Open-BeatBox/Open-BeatBox_Hardware/electronics/pictures/BB_feeder_IRbarrier.PNG

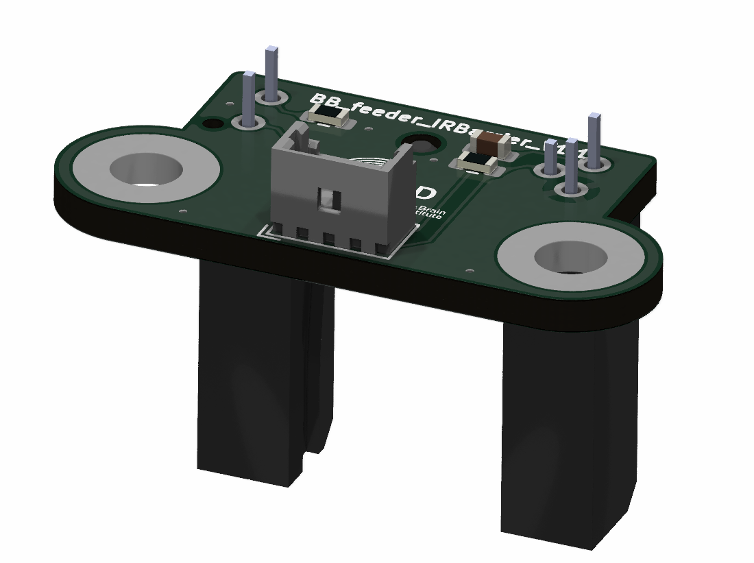
electronics/pictures/BB_feeder_IRbarrier.PNG
