Open-BeatBox/Open-BeatBox_Hardware/electronics/pictures/BB_Feeder_main.PNG

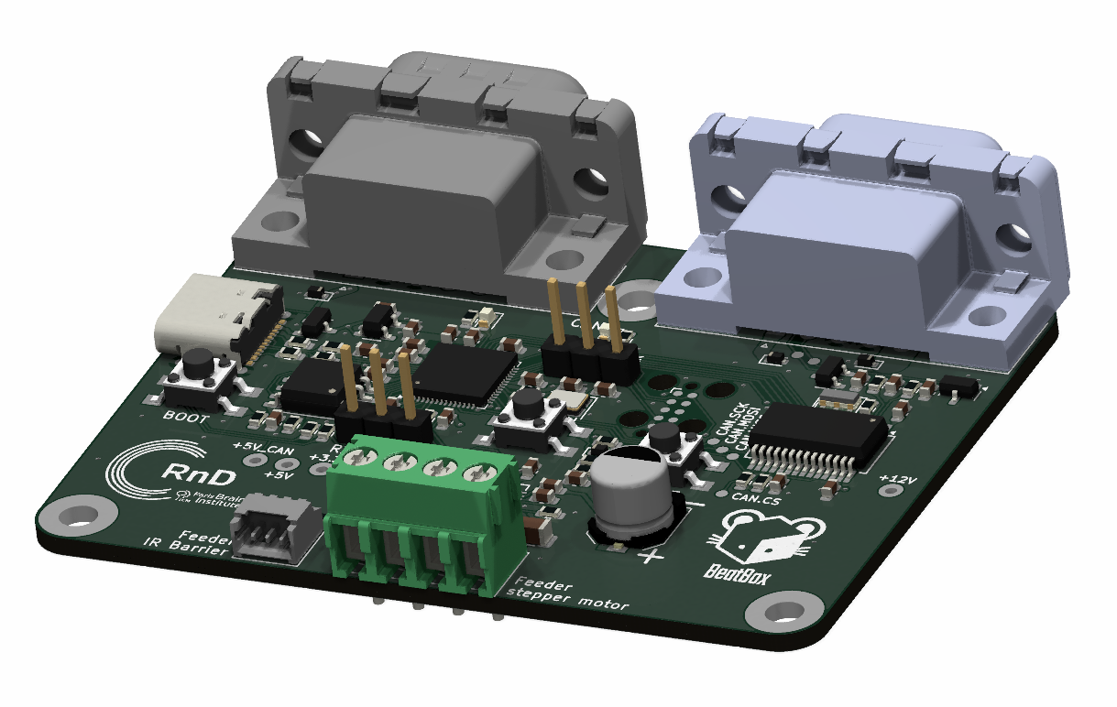
electronics/pictures/BB_Feeder_main.PNG
