Open-BeatBox/Open-BeatBox_Hardware/electronics/pictures/BB_Lighting.PNG

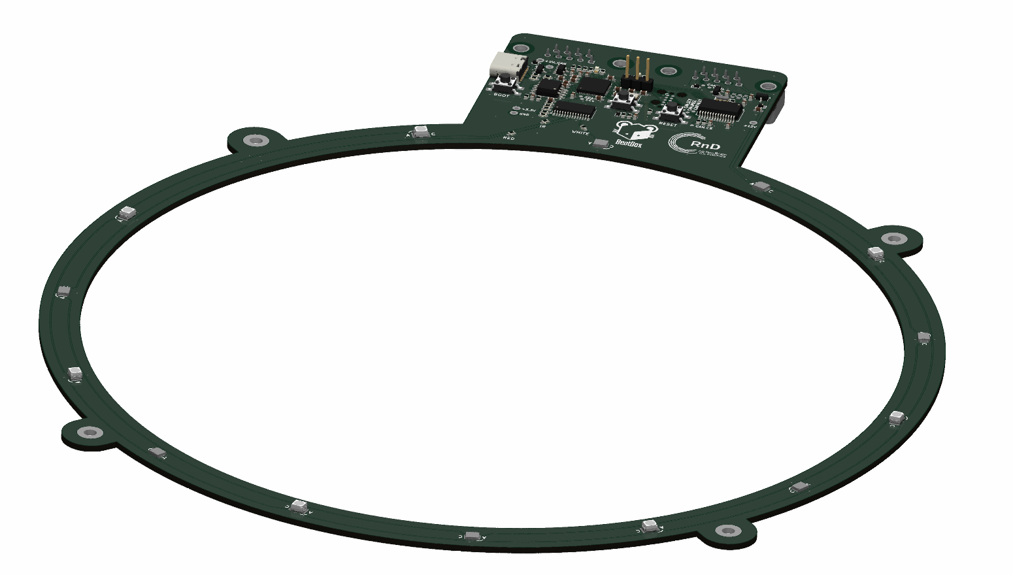
electronics/pictures/BB_Lighting.PNG
