Open-BeatBox/Open-BeatBox_Hardware/electronics/pictures/BB_Nosepoke.PNG

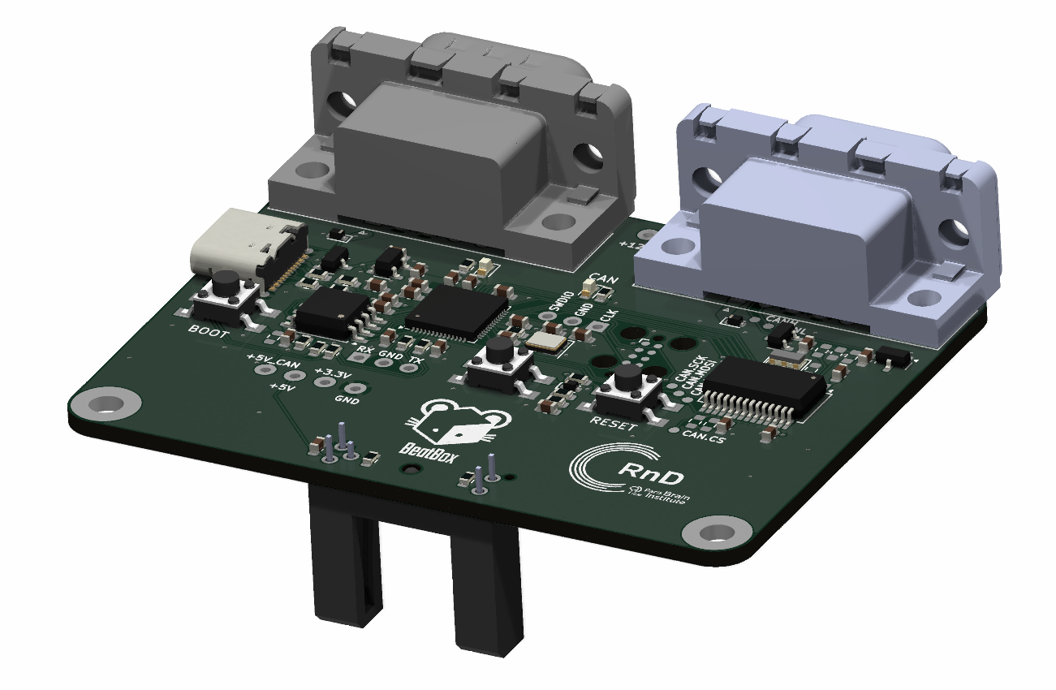
electronics/pictures/BB_Nosepoke.PNG
