Open-BeatBox/Open-BeatBox_Hardware/electronics/pictures/BB_RPI_shield.PNG

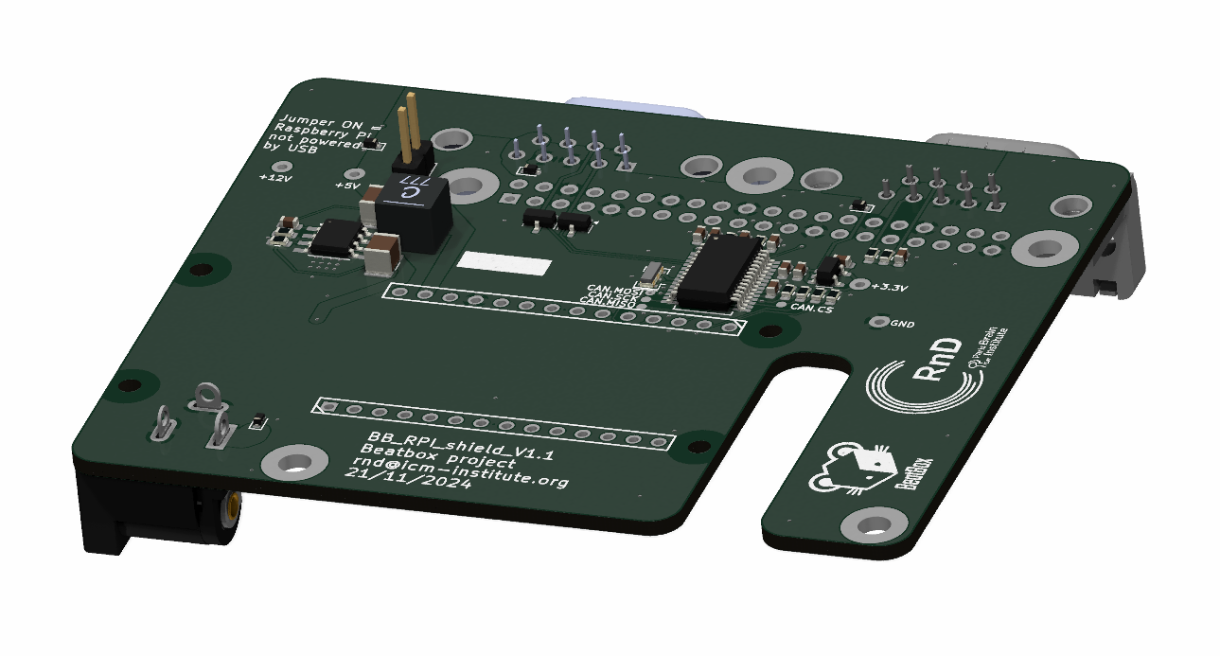
electronics/pictures/BB_RPI_shield.PNG
