Open-BeatBox/Open-BeatBox_Hardware/electronics/pictures/BB_Screen_Main.PNG

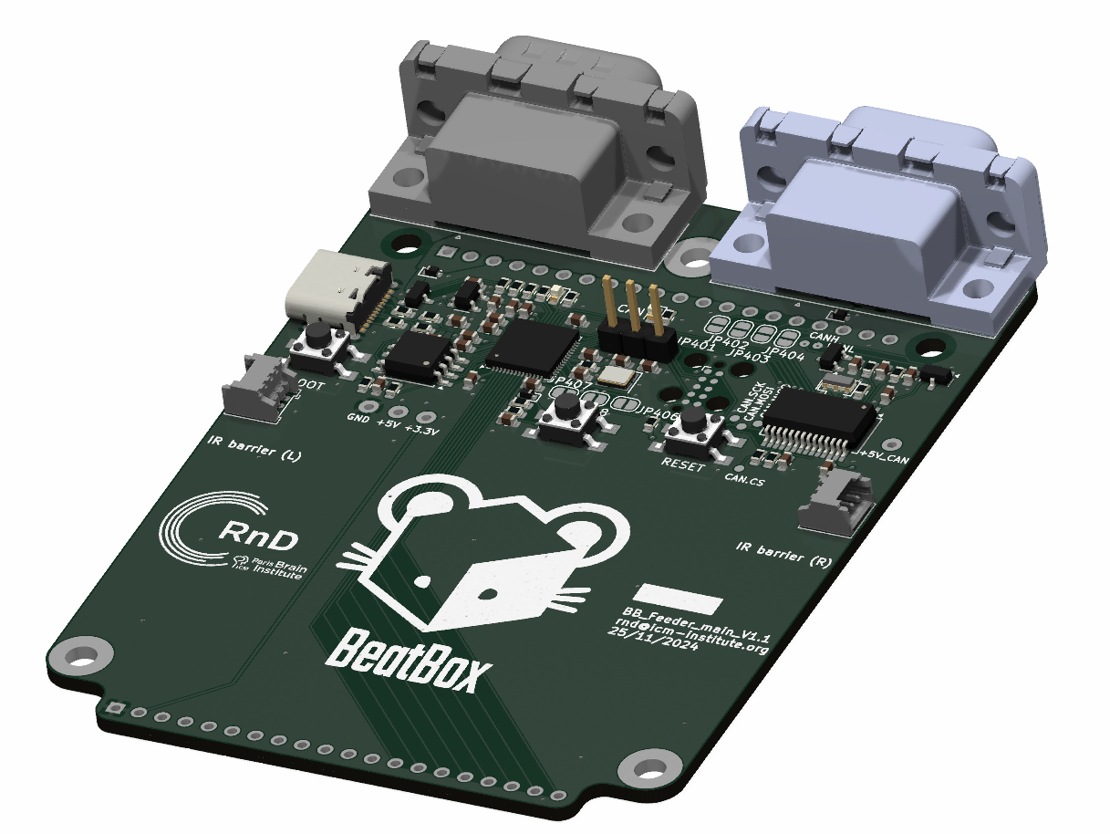
electronics/pictures/BB_Screen_Main.PNG
