Open-BeatBox/Open-BeatBox_Hardware/electronics/pictures/BB_Tunnel.PNG

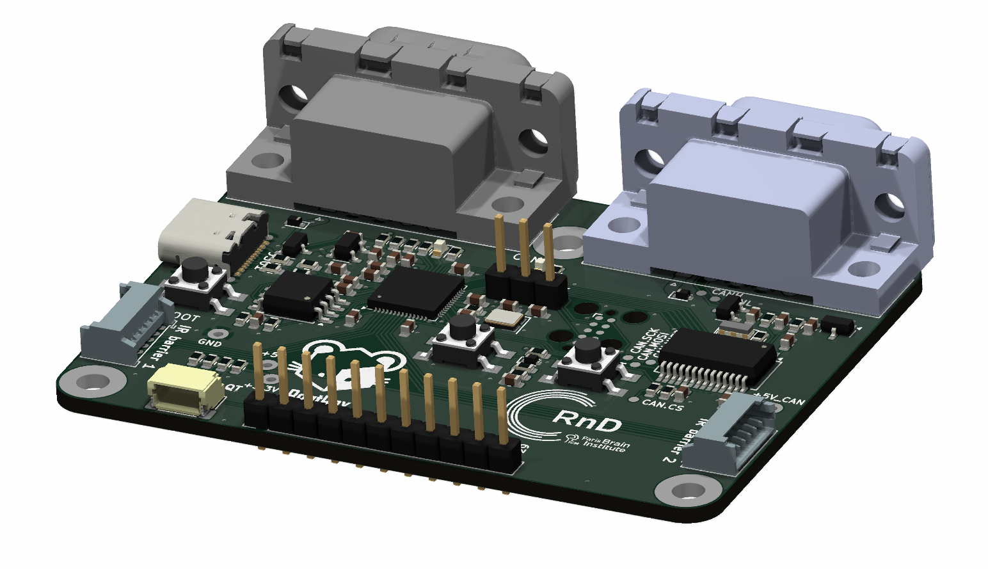
electronics/pictures/BB_Tunnel.PNG
