Open-BeatBox/Open-BeatBox_Hardware/electronics/pictures/BB_Tunnel_IR_Light_curtain.PNG

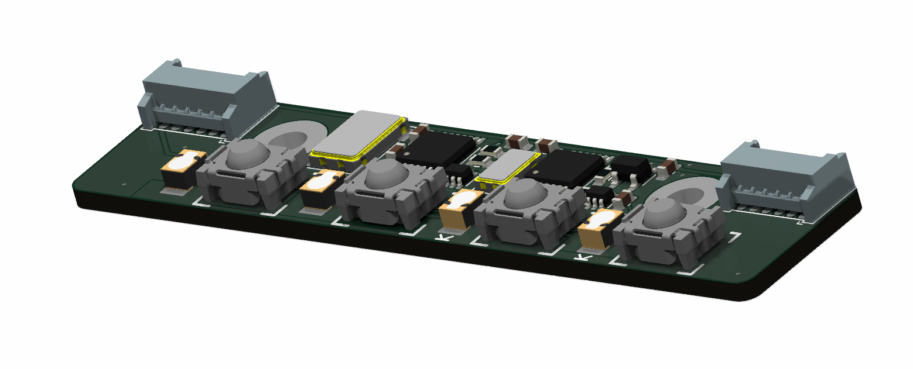
electronics/pictures/BB_Tunnel_IR_Light_curtain.PNG
