Open-BeatBox/Open-BeatBox_Hardware/electronics/BB_feeder_IRBarrier_V1/production/bom.csv

Designator | Footprint | Quantity | Value | LCSC Part #
C101 | 0603 | 1 | 100nF
J101 | Conn_Molex_PicoBlade_53048-0310_1x03_P1.25mm_Horizontal | 1 | Conn_Picoblade_Molex_53047-0310 | 53048-0310
R101 | 0603 | 1 | 300R
R102 | 0603 | 1 | 30k
U101 | SHARP-GP1A57HRJ00F | 1 | GP1A57HRJ00F | GP1A57HRJ00F
