Open-BeatBox/Open-BeatBox_Hardware/electronics/BB_feeder_main_V1/production/bom.csv

Designator | Footprint | Quantity | Value | LCSC Part #
C201, C202, C205, C206, C207, C208, C209, C210, C211, C212, C213, C214, C215, C216, C217, C303, C304, C305, C502, C503, C506, C507 | 0603 | 22 | 100nF
C203, C204 | 0603 | 2 | 1µF
C218, C219 | 0603 | 2 | 15pF
C302, C307 | 0603 | 2 | 47pF
C401, C402, C403, C404 | 0603 | 4 | 1uF
C501, C508 | 0603 | 2 | 220nF
C504 | 1206 | 1 | 4.7µF 16V
C505 | EEE-FN1V680UP | 1 | EEE-FN1V680UP | EEE-FN1V680UP
D201 | D_SOD-523 | 1 | TVS_ESD5Z3.3T5G | ESD5Z3.3T5G
D202, D301, D302 | D_SOD-523 | 3 | TVS_ESD5Z5.0T1G | ESD5Z5.0T1G
D203 | 0603 | 1 | LED_150060GS75000 | 150060GS75000
D204 | 0603 | 1 | LED_150060YS75000 | 150060YS75000
D303 | D_SOD-523 | 1 | TVS_ESD5Z12T1G | ESD5Z12T1G
D304, D305 | SOT-23 | 2 | MMBZ27VCLT1G | MMBZ27VCLT1G
J202 | KH-BNC50-3511 | 1 | Conn_BNC_KH-BNC50-3511 | KH-BNC50-3511
J301 | Conn_DB9_D09P33E4PA00LF | 1 | Conn-DB9_D09P33E4PA00LF | D09P33E4PA00LF
J302 | Conn_DB9_D09S33E4PA00LF | 1 | Conn-DB9_D09S33E4PA00LF | D09S33E4PA00LF
J401 | Conn_USB_C_Receptacle_GCT_USB4105-xx-A_16P_TopMnt_Horizontal | 1 | Conn_USB-C_USB4105-GF-A | USB4105-GF-A
J501 | TerminalBlock_Phoenix_PT-1,5-4-3.5-H_1x04_P3.50mm_Horizontal | 1 | Conn_Screw_Terminal_04_P3.5 | 20020327-C041B01LF
J502 | Conn_Molex_PicoBlade_53048-0310_1x03_P1.25mm_Horizontal | 1 | Conn_Picoblade_Molex_53048-0310 | 53048-0310
R201, R209, R403, R406, R503, R504 | 0603 | 6 | 100k
R202, R203, R205, R306, R307, R308, R309, R501, R508 | 0603 | 9 | 10k
R204, R206 | 0603 | 2 | 1k
R207, R208 | 0603 | 2 | 470R
R210 | 0603 | 1 | 33k
R401, R402 | 0603 | 2 | 5.1k
R404, R405 | 0603 | 2 | 27R
R502 | 0603 | 1 | 1.05k
R505 | 0603 | 1 | 5k
R506, R507 | 0603 | 2 | 68mR
R509 | 0603 | 1 | 30k
SW201, SW202, SW203 | SW_Push_TL3305 | 3 | SW_TL3305AF160QG | TL3305AF160QG
U201 | SOIC-8_W25Q128JV | 1 | W25Q128JVS
U202 | SOT-363_SC-70-6 | 1 | 74LVC1T45 | 74LVC1T45DW-7
U203 | QFN-56-1EP_7x7mm_P0.4mm_EP3.2x3.2mm | 1 | RP2040 | RP2040
U301 | SSOP-28_5.3x10.2mm_P0.65mm | 1 | MCP25625-E/SS | MCP25625-E/SS
U401, U403 | SOT-363_SC-70-6 | 2 | LM66100DCK | LM66100DCKR
U402 | SOT-23-5 | 1 | MIC5504-3.3YM5 | MIC5504-3.3YM5
U501 | QFN-28-1EP_5x5mm_P0.5mm_EP3.1x3.1mm | 1 | A4988 | A4988SETTR-T
Y201 | Crystal_SMD_Abracon_ABM8 | 1 | Crystal_ABM8-272-T3 | ABM8-272-T3
Y301 | Resonator_SMD_Murata_CSTxExxV-3Pin_3.0x1.1mm | 1 | CSTNE16M0VH3L000R0 | CSTNE16M0VH3L000R0
