Open-BeatBox/Open-BeatBox_Hardware/electronics/BB_IR_light_curtain_V2_38k/production/bom.csv

Designator | Footprint | Quantity | Value | LCSC Part #
C1, C2 | 0603 | 2 | 1µF
C101, C102 | 0603 | 2 | 100nF
D1, D2, D3, D4 | 1206 | 4 | DY-IRS3216176-3T-09 | C7470733
J1 | Conn_Molex_PicoBlade_53048-0610_1x06_P1.25mm_Horizontal | 1 | Conn_01x06
J2 | Conn_Molex_PicoBlade_53048-0310_1x03_P1.25mm_Horizontal | 1 | Conn_Picoblade_Molex_53048-0310 | C505275
R1, R2 | 0603 | 2 | 20k
R3 | 0603 | 1 | 10k
TP1, TP2, TP5 | TestPoint_Pad_D1.0mm | 3 | TestPoint
U1, U3, U5, U8 | SOT-353_SC-70-5 | 4 | 74LVC1G06GW,125 | C426704
U101 | TSSOP-14_4.4x5mm_P0.65mm | 1 | CD74HC4024PWR | C2653003
U2, U4, U7, U9 | Vishay-panhead | 4 | TSSP6038 | C3742816
U6 | SOT-23-5 | 1 | MIC5504-3.3YM5 | C88419
X101 | Crystal_SMD_3225-4Pin_3.2x2.5mm | 1 | SX3M4.9152A10F20TNN | C41361375
