Open-BeatBox/Open-BeatBox_Hardware/electronics/BB_RPI_shield_V1/production/bom.csv

Designator | Footprint | Quantity | Value | LCSC Part #
BT601 | Harwin-S8411-45R | 1 | S8411R-45R | C70381
C201, C202, C205, C206, C207, C208, C209, C210, C211, C212, C213, C214, C215, C216, C217, C303, C304, C305, C412, C601 | 0603 | 20 | 100nF
C203, C204 | 0603 | 2 | 1µF
C218, C219 | 0603 | 2 | 15pF
C301, C306 | 0603 | 2 | 4.7nF
C302, C307, C408, C409 | 0603 | 4 | 47pF
C401, C402, C403, C404 | 0603 | 4 | 1uF
C405 | 1210 | 1 | 22uF
C406 | 1210 | 1 | 10uF 25V
C407 | 0603 | 1 | 1uF 25V
C410, C411 | 0603 | 2 | 2.2uF
C501 | 0603 | 1 | 10µF
D201, D501 | D_SOD-523 | 2 | TVS_ESD5Z3.3T5G | C22440024
D202, D301, D302, D407, D408 | D_SOD-523 | 5 | TVS_ESD5Z5.0T1G | C343989
D203, D402 | 0603 | 2 | LED_150060GS75000 | C5252984
D204 | 0603 | 1 | LED_150060YS75000 | C6784997
D303, D401 | D_SOD-523 | 2 | TVS_ESD5Z12T1G | ESD5Z12T1G
D304, D305 | SOT-23 | 2 | MMBZ27VCLT1G | C128609
D403, D404, D405, D406 | D_SOD-523 | 4 | TVS_ESD321DYAR | C20345394
D502, D503, D504, D505, D506 | D_SOD-323 | 5 | UDD32C03L01 | C78439
J202 | KH-BNC50-3511 | 1 | Conn_BNC_KH-BNC50-3511 | C2837587
J301 | Conn_DB9_D09P33E4PA00LF | 1 | Conn-DB9_D09P33E4PA00LF | C19077344
J302 | Conn_DB9_D09S33E4PA00LF | 1 | Conn-DB9_D09S33E4PA00LF | C141882
J401, J403 | Conn_USB_C_Receptacle_GCT_USB4105-xx-A_16P_TopMnt_Horizontal | 2 | Conn_USB-C_USB4105-GF-A | C393939
J402 | Conn_BarrelJack_Wurth_694106301002 | 1 | Barrel_Jack_Switch | C5441017
J501 | microSD_TF-01A | 1 | TF-01A | C91145
L401 | L_coilcraft_XAL50XX | 1 | Ind_XAL5030-332MEC | C5342047
LG401 | Lightpipe_Dialight_515-1049F | 1 | 515-1049F | 515-1049F
R201, R210 | 0603 | 2 | 100k
R202, R203, R205, R306, R307, R308, R309 | 0603 | 7 | 10k
R204, R206 | 0603 | 2 | 1k
R207, R208, R413 | 0603 | 3 | 470R
R303, R304, R305, R310 | 0603 | 4 | 60.4R
R401, R402, R409, R410 | 0603 | 4 | 5.1k
R404, R405, R411, R412 | 0603 | 4 | 27R
R407 | 0603 | 1 | 115k
R408 | 0603 | 1 | 22k
R501 | 0603 | 1 | 100kR
R502, R503, R504, R601, R602 | 0603 | 5 | 10kR
SW201, SW202, SW203 | SW_Push_TL3305 | 3 | SW_TL3305AF160QG | C18078070
U201 | SOIC-8_W25Q128JV | 1 | W25Q128JVS | C97521
U202 | SOT-363_SC-70-6 | 1 | 74LVC1T45 | C168855
U203 | QFN-56-1EP_7x7mm_P0.4mm_EP3.2x3.2mm | 1 | RP2040 | C2040
U301 | SSOP-28_5.3x10.2mm_P0.65mm | 1 | MCP25625-E/SS | C184944
U401, U403 | SOT-363_SC-70-6 | 2 | LM66100DCK | C2869734
U402 | SOT-23-5 | 1 | MIC5504-3.3YM5 | C88419
U404 | TI_SO-PowerPAD-8 | 1 | ST1S41PHR | C2070789
U405 | WDFN-12-1EP_3x3mm_P0.45mm_EP1.7x2.5mm | 1 | FT234XD
U601 | SOIC-16W_7.5x10.3mm_P1.27mm | 1 | DS3231S | C722469
Y201 | Crystal_SMD_Abracon_ABM8 | 1 | Crystal_ABM8-272-T3 | C20625731
Y301 | Resonator_SMD_Murata_CSTxExxV-3Pin_3.0x1.1mm | 1 | CSTNE16M0VH3L000R0 | C1870467
