Open-BeatBox/Open-BeatBox_Hardware/electronics/BB_screen_main_V1/production/bom.csv

Designator | Footprint | Quantity | Value | LCSC Part #
BOM401, BOM402 | Placeholder | 2 | M20-7822046 | M20-7822046
C201, C305, C306, C307, C308, C309, C310, C311, C312, C313, C314, C315, C318, C502, C503, C504 | 0603 | 16 | 100nF
C301, C302 | 0603 | 2 | 10µF
C303, C304 | 0603 | 2 | 1µF
C316, C317 | 0603 | 2 | 15pF
C501, C506 | 0603 | 2 | 47pF
D302 | 0603 | 1 | LED_150060GS75000 | 150060GS75000
D303 | 0603 | 1 | LED_150060YS75000 | 150060YS75000
D304 | D_SOD-523 | 1 | TVS_ESD5Z3.3T5G | ESD5Z3.3T5G
D501, D502 | D_SOD-523 | 2 | TVS_ESD5Z5.0T1G | ESD5Z5.0T1G
D503, D504 | SOT-23 | 2 | MMBZ27VCLT1G | MMBZ27VCLT1G
J301 | Conn_USB_C_Receptacle_GCT_USB4105-xx-A_16P_TopMnt_Horizontal | 1 | Conn_USB-C_USB4105-GF-A | USB4105-GF-A
J302, J305 | Conn_Molex_PicoBlade_53048-0310_1x03_P1.25mm_Horizontal | 2 | Conn_Picoblade_Molex_53048-0310 | 53048-0310
J501 | Conn_DB9_D09P33E4PA00LF | 1 | Conn-DB9_D09P33E4PA00LF | D09P33E4PA00LF
J502 | Conn_DB9_D09S33E4PA00LF | 1 | Conn-DB9_D09S33E4PA00LF | D09S33E4PA00LF
R201, R210, R310, R311, R502, R503, R505 | 0603 | 7 | 10k
R209, R303, R306, R309 | 0603 | 4 | 100k
R301, R304 | 0603 | 2 | 470R
R307, R308 | 0603 | 2 | 5.1k
R312, R315 | 0603 | 2 | 1k
R313, R314 | 0603 | 2 | 27R
SW301, SW302, SW303 | SW_Push_TL3305 | 3 | SW_TL3305AF160QG | TL3305AF160QG
U201 | SOIC-8_W25Q128JV | 1 | W25Q128JVS | W25Q128JVS
U301 | SOT-23-5 | 1 | MIC5504-3.3YM5 | MIC5504-3.3YM5
U302 | QFN-56-1EP_7x7mm_P0.4mm_EP3.2x3.2mm | 1 | RP2040 | RP2040
U501 | SSOP-28_5.3x10.2mm_P0.65mm | 1 | MCP25625-E/SS | MCP25625-E/SS
Y301 | Crystal_SMD_Abracon_ABM8 | 1 | Crystal_ABM8-272-T3 | ABM8-272-T3
Y501 | Resonator_SMD_Murata_CSTxExxV-3Pin_3.0x1.1mm | 1 | CSTNE16M0VH3L000R0 | CSTNE16M0VH3L000R0
