Open-BeatBox/Open-BeatBox_Hardware/electronics/BB_tunnel_V1/production/bom.csv

Designator | Footprint | Quantity | Value | LCSC Part #
C201, C305, C306, C307, C308, C309, C310, C311, C312, C313, C314, C315, C316, C402, C403, C404 | 0603 | 16 | 100nF
C301, C302 | 0603 | 2 | 10µF
C303, C304 | 0603 | 2 | 1µF
C317, C318 | 0603 | 2 | 15pF
C401, C406 | 0603 | 2 | 47pF
D302 | 0603 | 1 | LED_150060GS75000 | C5252984
D303 | 0603 | 1 | LED_150060YS75000 | C6784997
D304 | D_SOD-523 | 1 | TVS_ESD5Z3.3T5G | C22440024
D401, D402 | D_SOD-523 | 2 | TVS_ESD5Z5.0T1G | C343989
D403, D404 | SOT-23 | 2 | MMBZ27VCLT1G | C128609
J301 | Conn_USB_C_Receptacle_GCT_USB4105-xx-A_16P_TopMnt_Horizontal | 1 | Conn_USB-C_USB4105-GF-A | C393939
J401 | Conn_DB9_D09P33E4PA00LF | 1 | Conn-DB9_D09P33E4PA00LF | C19077344
J402 | Conn_DB9_D09S33E4PA00LF | 1 | Conn-DB9_D09S33E4PA00LF | C141882
J502, J504 | Molex_PicoBlade_53048-0610_1x06_P1.25mm_Horizontal | 2 | 53048-0610 | C161598
J503 | Conn_JST_SH_SM04B-SRSS-TB_1x04-1MP_P1.00mm_Horizontal | 1 | SH_SM04B-SRSS-TB | C160404
R201, R310, R311, R402, R403, R405, R503, R504 | 0603 | 8 | 10k
R209, R302, R303, R305, R306, R309 | 0603 | 6 | 100k
R210 | 0603 | 1 | 56k
R301, R304 | 0603 | 2 | 470R
R307, R308 | 0603 | 2 | 5.1k
R312, R315 | 0603 | 2 | 1k
R313, R314 | 0603 | 2 | 27R
R502 | 0603 | 1 | 0R
SW301, SW302, SW303 | SW_Push_TL3305 | 3 | SW_TL3305AF160QG | C18078070
TP301, TP302, TP303 | TestPoint_THTPad_D2.0mm_Drill1.0mm | 3 | TestPoint
U201 | SOIC-8_W25Q128JV | 1 | W25Q128JVS | C97521
U301 | SOT-23-5 | 1 | MIC5504-3.3YM5 | C88419
U302 | QFN-56-1EP_7x7mm_P0.4mm_EP3.2x3.2mm | 1 | RP2040 | C2040
U401 | SSOP-28_5.3x10.2mm_P0.65mm | 1 | MCP25625-E/SS | C184944
Y301 | Crystal_SMD_Abracon_ABM8 | 1 | Crystal_ABM8-272-T3 | C20625731
Y401 | Resonator_SMD_Murata_CSTxExxV-3Pin_3.0x1.1mm | 1 | CSTNE16M0VH3L000R0 | C1870467
