Open-BeatBox/Open-BeatBox_Hardware/mechanical/V3/enclosure/ceiling_3mm.DXF

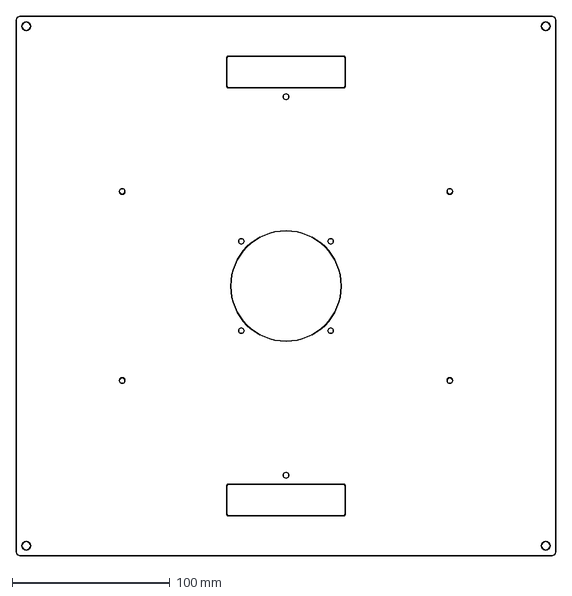
[picture p10: CAD file, 2026-09-29]
mechanical/V3/enclosure/ceiling_3mm.DXF
342.0 x 342.0 mm
