Open-BeatBox/Open-BeatBox_Hardware/mechanical/V3/feeder/PRODUCTION/feeder_base.STL

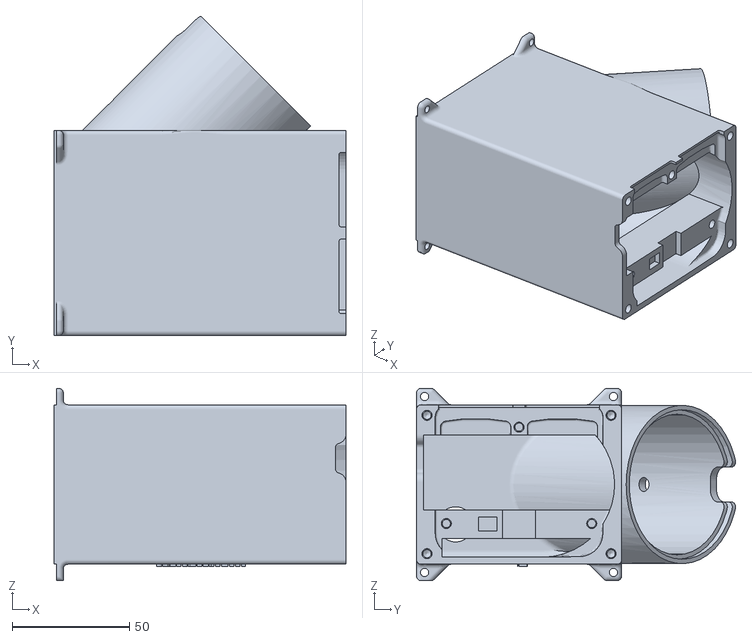
[picture p11: CAD file, 2026-09-29]
mechanical/V3/feeder/PRODUCTION/feeder_base.STL
124.5 x 136.1 x 82.0
