Open-BeatBox/Open-BeatBox_Hardware/mechanical/V3/lighting/PRODUCTION/lighting_cap.STL

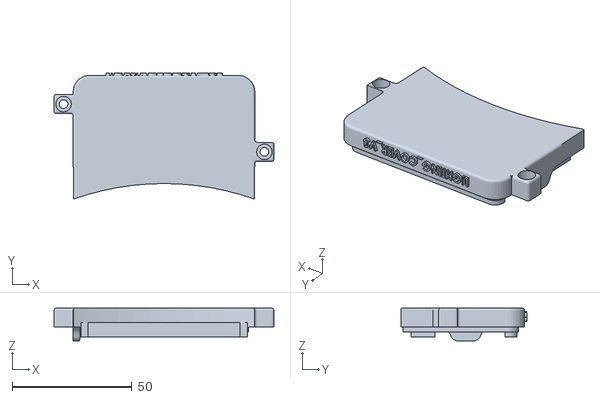
[picture p12: CAD file, 2026-09-29]
mechanical/V3/lighting/PRODUCTION/lighting_cap.STL
92.0 x 52.7 x 13.7
