Open-BeatBox/Open-BeatBox_Hardware/mechanical/V3/main/PRODUCTION/RPI_shield_top_V3.STL

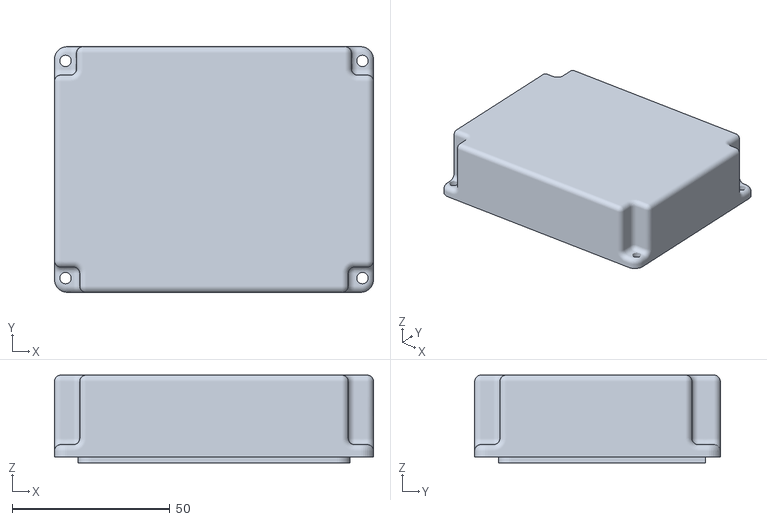
[picture p13: CAD file, 2026-09-18]
mechanical/V3/main/PRODUCTION/RPI_shield_top_V3.STL
101.0 x 77.8 x 27.8
