Open-BeatBox/Open-BeatBox_Hardware/mechanical/V3/screen/PRODUCTION/screen_cover.STL

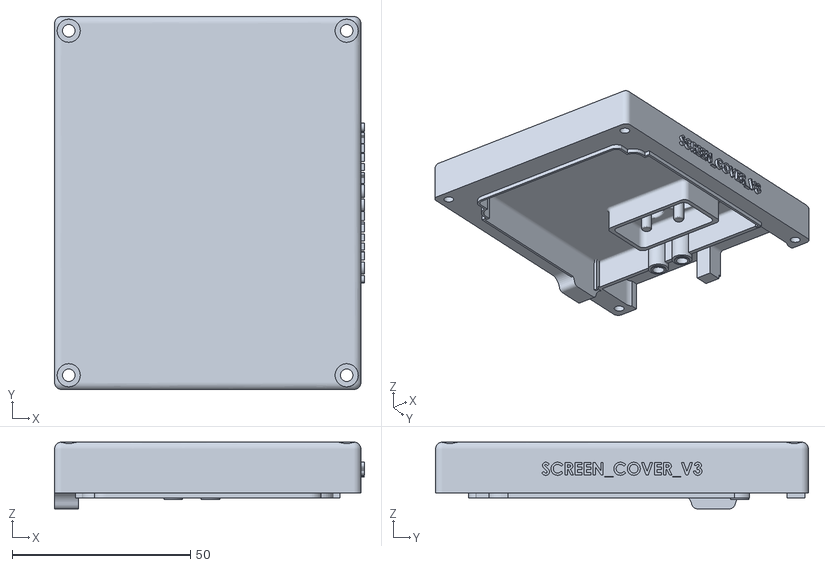
[picture p14: CAD file, 2026-09-29]
mechanical/V3/screen/PRODUCTION/screen_cover.STL
87.0 x 104.7 x 18.8
