Open-BeatBox/Open-BeatBox_Hardware/mechanical/V3/structure/base_plate.DXF

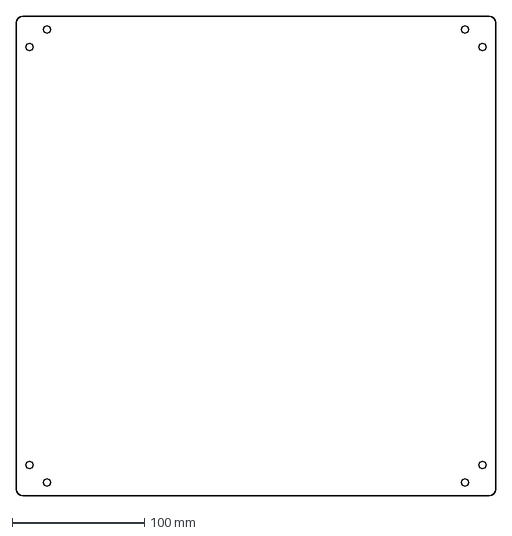
[picture p15: CAD file, 2026-09-29]
mechanical/V3/structure/base_plate.DXF
363.0 x 363.0 mm
