Open-BeatBox/Open-BeatBox_Hardware/mechanical/V3/tunnel/PRODUCTION/tunnel_base.STL

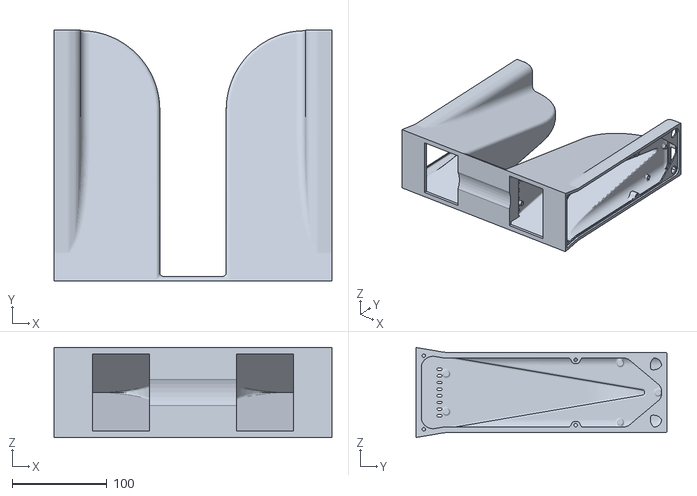
[picture p16: CAD file, 2026-09-29]
mechanical/V3/tunnel/PRODUCTION/tunnel_base.STL
293.0 x 265.0 x 95.0
