Open-BeatBox/Open-BeatBox_Hardware/mechanical/V3/enclosure/door_locker_3mm.DXF

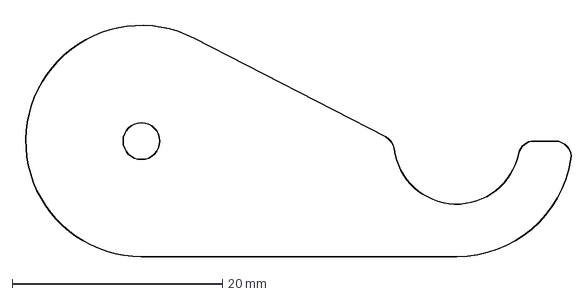
[picture p17: CAD file, 2026-09-29]
mechanical/V3/enclosure/door_locker_3mm.DXF
52.8 x 22.9 mm
