Open-BeatBox/Open-BeatBox_Hardware/mechanical/V3/feeder/PRODUCTION/feeder_front.STL

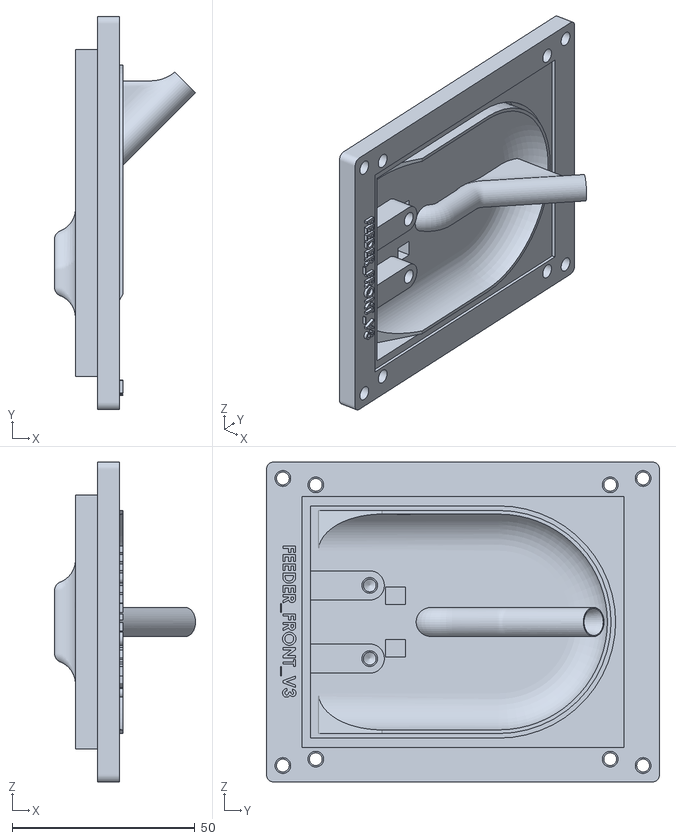
[picture p18: CAD file, 2026-09-29]
mechanical/V3/feeder/PRODUCTION/feeder_front.STL
38.6 x 107.5 x 87.5
