Open-BeatBox/Open-BeatBox_Hardware/mechanical/V3/lighting/PRODUCTION/beatbox_lighting_cover.DXF

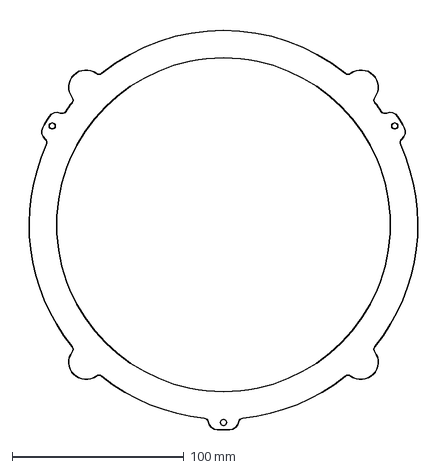
[picture p19: CAD file, 2026-09-29]
mechanical/V3/lighting/PRODUCTION/beatbox_lighting_cover.DXF
241.1 x 240.6 mm
