Open-BeatBox/Open-BeatBox_Hardware/mechanical/V3/main/PRODUCTION/RPI_shield_base_V3.STL

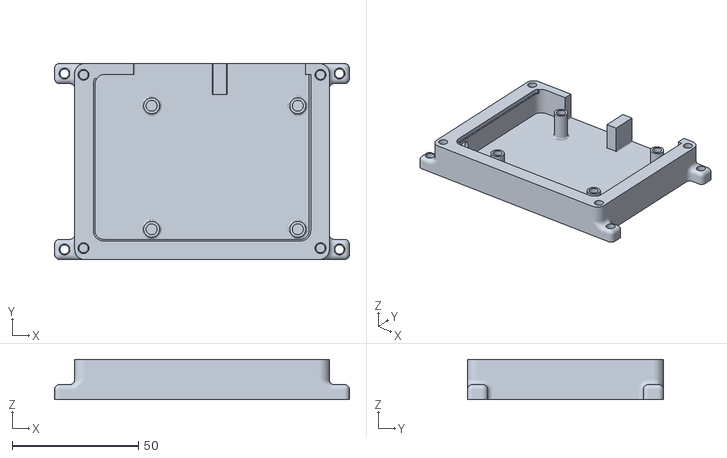
[picture p20: CAD file, 2026-09-18]
mechanical/V3/main/PRODUCTION/RPI_shield_base_V3.STL
117.0 x 77.8 x 16.0
