Open-BeatBox/Open-BeatBox_Hardware/mechanical/V3/screen/PRODUCTION/screen_base.STL

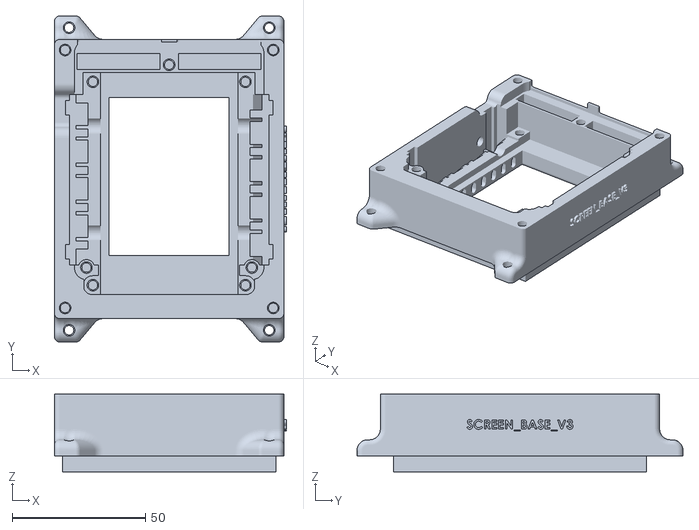
[picture p21: CAD file, 2026-09-29]
mechanical/V3/screen/PRODUCTION/screen_base.STL
87.0 x 122.2 x 29.1
