Open-BeatBox/Open-BeatBox_Hardware/mechanical/V3/structure/pillar.STL

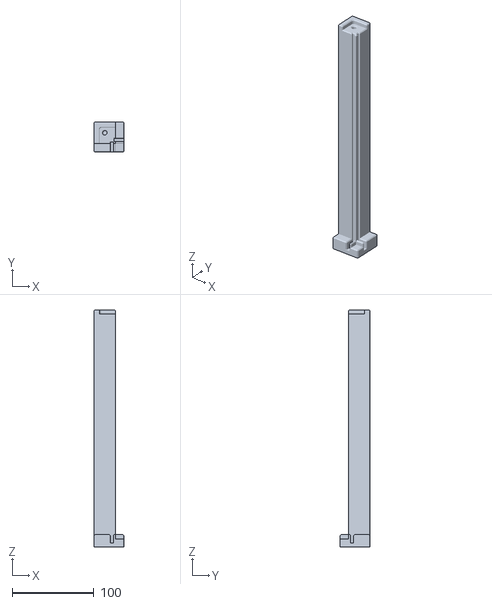
[picture p22: CAD file, 2026-09-18]
mechanical/V3/structure/pillar.STL
36.5 x 36.5 x 290.0
