Open-BeatBox/Open-BeatBox_Hardware/mechanical/V3/tunnel/PRODUCTION/tunnel_lateral_cap.STL

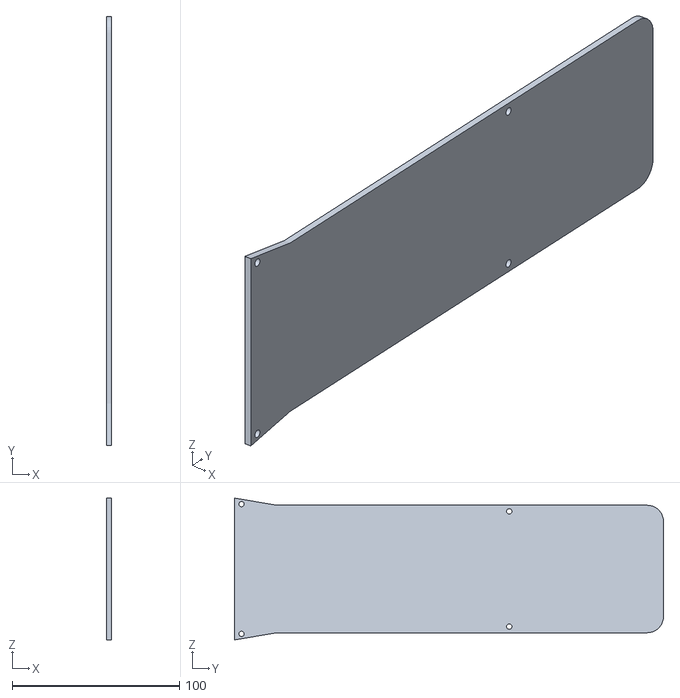
[picture p23: CAD file, 2026-09-18]
mechanical/V3/tunnel/PRODUCTION/tunnel_lateral_cap.STL
3.00 x 256.4 x 84.8
