Open-BeatBox/Open-BeatBox_Hardware/mechanical/V3/enclosure/door_3mm.DXF

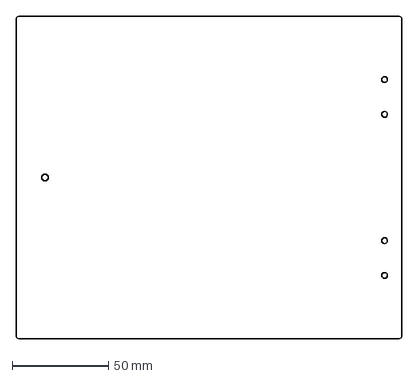
[picture p24: CAD file, 2026-09-29]
mechanical/V3/enclosure/door_3mm.DXF
200.0 x 166.9 mm
