Open-BeatBox/Open-BeatBox_Hardware/mechanical/V3/feeder/PRODUCTION/feeder_cover.STL

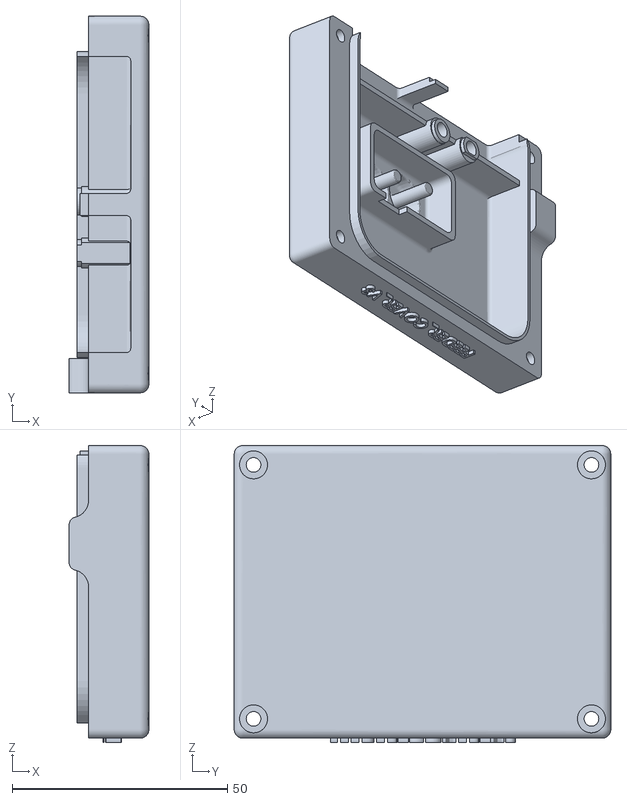
[picture p25: CAD file, 2026-09-29]
mechanical/V3/feeder/PRODUCTION/feeder_cover.STL
18.5 x 87.5 x 69.0
