Open-BeatBox/Open-BeatBox_Hardware/mechanical/V3/lighting/PRODUCTION/lighting_base.STL

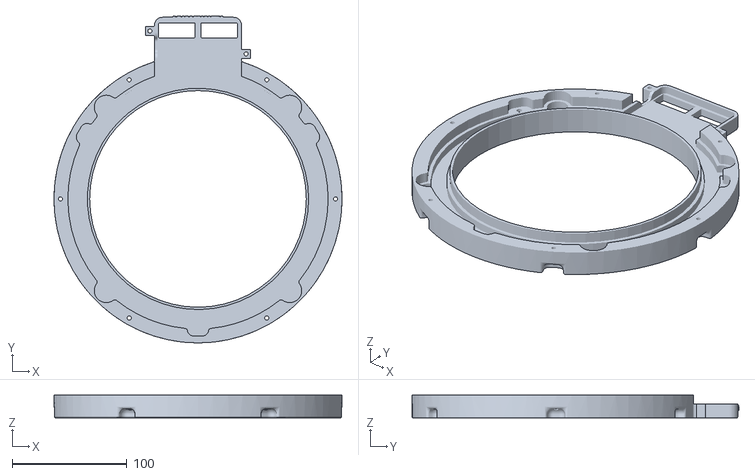
[picture p26: CAD file, 2026-09-29]
mechanical/V3/lighting/PRODUCTION/lighting_base.STL
251.3 x 285.1 x 20.0
