Open-BeatBox/Open-BeatBox_Hardware/mechanical/V3/feeder/PRODUCTION/front_bottle_guide.STL

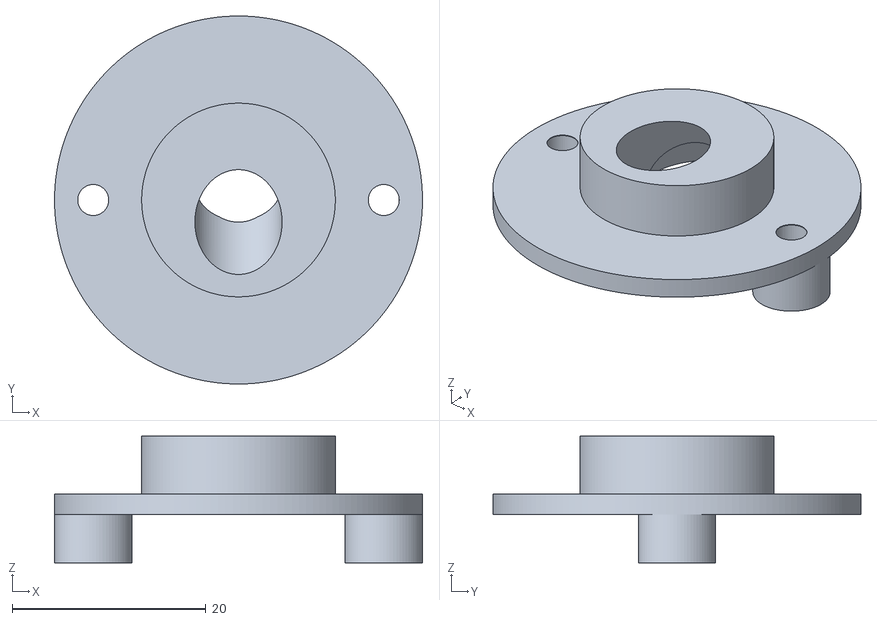
[picture p28: CAD file, 2026-09-18]
mechanical/V3/feeder/PRODUCTION/front_bottle_guide.STL
38.0 x 38.0 x 13.1
