Open-BeatBox/Open-BeatBox_Hardware/mechanical/V3/enclosure/door_wall_1_3mm.DXF

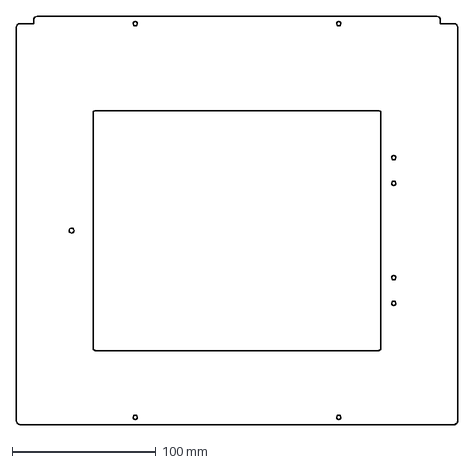
[picture p29: CAD file, 2026-09-29]
mechanical/V3/enclosure/door_wall_1_3mm.DXF
306.9 x 283.9 mm
