Open-BeatBox/Open-BeatBox_Hardware/mechanical/V3/enclosure/feeder_wall_1_3mm.DXF

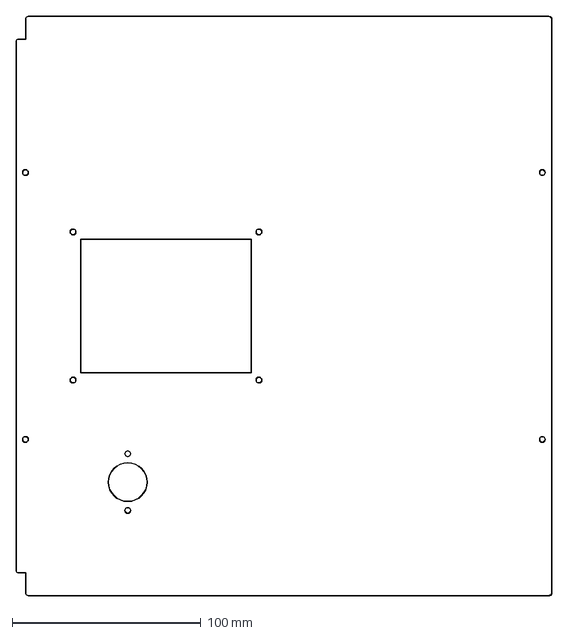
[picture p33: CAD file, 2026-09-29]
mechanical/V3/enclosure/feeder_wall_1_3mm.DXF
283.9 x 306.9 mm
