Open-BeatBox/Open-BeatBox_Hardware/mechanical/V3/enclosure/door_wall_2_3mm.DXF

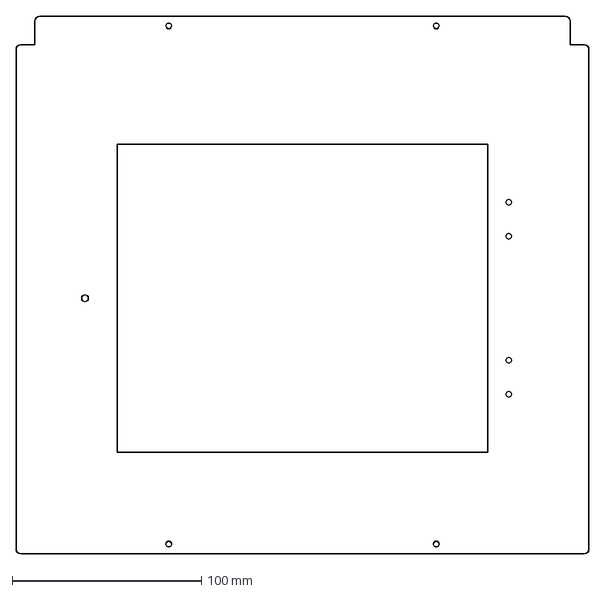
[picture p35: CAD file, 2026-09-29]
mechanical/V3/enclosure/door_wall_2_3mm.DXF
302.8 x 283.9 mm
