Open-BeatBox/Open-BeatBox_Hardware/mechanical/V3/enclosure/base_plate_10mm.DXF

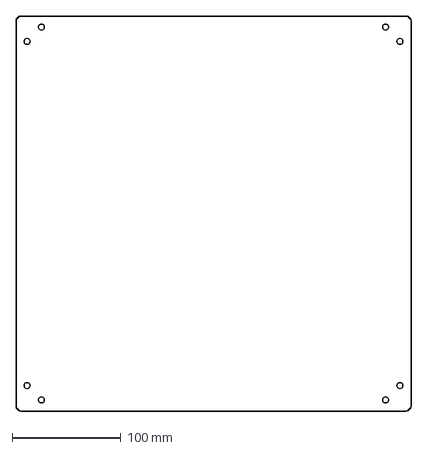
[picture p36: CAD file, 2026-09-29]
mechanical/V3/enclosure/base_plate_10mm.DXF
363.0 x 363.0 mm
