Open-BeatBox/Open-BeatBox_Hardware/mechanical/V3/enclosure/doorKnob.STL

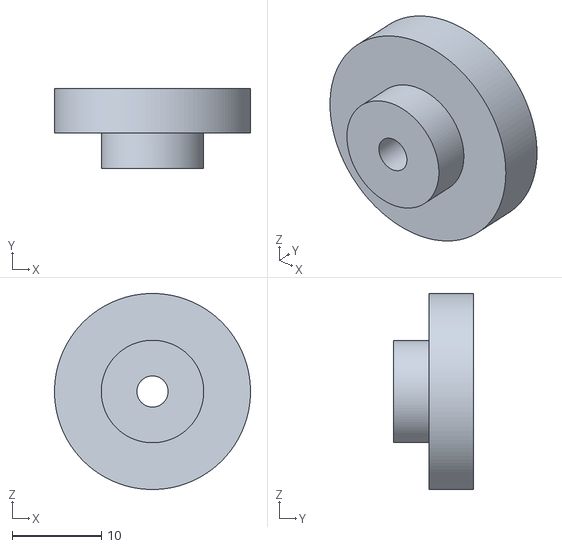
[picture p37: CAD file, 2026-09-18]
mechanical/V3/enclosure/doorKnob.STL
22.0 x 9.00 x 22.0
