Open-BeatBox/Open-BeatBox_Hardware/(list of files, cad)

Other CAD files:
mechanical/V3/main/main.STEP
electronics/STEPs/BB_feeder_main.step
electronics/STEPs/BB_screen_main.step
electronics/STEPs/BB_RPI_shield.step
mechanical/V3/feeder/feeder.STEP
mechanical/V3/lighting/lighting.STEP
mechanical/V3/screen/screen.STEP
mechanical/V3/tunnel/tunnel.STEP
electronics/STEPs/BB_lighting.step
electronics/STEPs/BB_feeder_IRBarrier.step
electronics/STEPs/BB_tunnel.step
electronics/STEPs/BB_nosepoke.step
electronics/STEPs/BB_IR_light_curtain.step
electronics/STEPs/BB_tunnel_IR_light_curtain.step
mechanical/V2/baseCage/baseCage.SLDPRT
mechanical/V2/cage_1feeder_2screens/baseCage_1feeder_2screens.SLDPRT
mechanical/V2/cage_1feeder_2screens/cage_1feeder_2screens.SLDASM
mechanical/V2/cage_1feeder_2screens/frontBottleGuide.SLDPRT
mechanical/V2/cage_1feeder_2screens/production/baseCage_1feeder_2screens_backSide1_3mm_glossyBlack.DXF
mechanical/V2/cage_1feeder_2screens/production/baseCage_1feeder_2screens_backSide2_3mm_matteBlack.DXF
mechanical/V2/cage_1feeder_2screens/production/baseCage_1feeder_2screens_basePlate_10mm_black.DXF
mechanical/V2/cage_1feeder_2screens/production/baseCage_1feeder_2screens_ceiling_5mm.DXF
mechanical/V2/cage_1feeder_2screens/production/baseCage_1feeder_2screens_doorKnob.STL
mechanical/V2/cage_1feeder_2screens/production/baseCage_1feeder_2screens_doorLocker_3mm_glossyBlack.DXF
mechanical/V2/cage_1feeder_2screens/production/baseCage_1feeder_2screens_door_3mm_clear.DXF
mechanical/V2/cage_1feeder_2screens/production/baseCage_1feeder_2screens_feederSide1_3mm_glossyBlack.DXF
mechanical/V2/cage_1feeder_2screens/production/baseCage_1feeder_2screens_feederSide2_3mm_matteBlack.DXF
mechanical/V2/cage_1feeder_2screens/production/baseCage_1feeder_2screens_frontSide1_3mm_glossyBlack.DXF
mechanical/V2/cage_1feeder_2screens/production/baseCage_1feeder_2screens_frontSide2_3mm_matteBlack.DXF
mechanical/V2/cage_1feeder_2screens/production/baseCage_1feeder_2screens_screenSide1_3mm_glossyBlack.DXF
mechanical/V2/cage_1feeder_2screens/production/baseCage_1feeder_2screens_screenSide2_3mm_matteBlack.DXF
mechanical/V2/camera/cameraAndNeopixelSupport.SLDPRT
mechanical/V2/camera/neopixelRing24.SLDPRT
mechanical/V2/camera/production/cameraAndNeopixelSupport.STL
mechanical/V2/camera/production/neopixelCover_3mm_clear.DXF
mechanical/V2/feeder/feeder.SLDPRT
mechanical/V2/feeder/feederAssembly.SLDASM
mechanical/V2/feeder/production/feederBack_FDM.STL
mechanical/V2/feeder/production/feederCase_FDM.STL
mechanical/V2/feeder/production/feederFacade_FDM.STL
mechanical/V2/feeder/production/feederRotor_FDM.STL
mechanical/V2/feeder/production/feederTankCover.DXF
mechanical/V2/passage/passage_printed.SLDPRT
mechanical/V2/passage/production/passage_printed.STL
mechanical/V2/passage/production/passage_printed_cover_3mm_black_x2.DXF
mechanical/V2/passage/production/passage_printed_test.STL
mechanical/V2/screen/production/screenCover.STL
mechanical/V2/screen/production/screenFrame.STL
mechanical/V2/screen/screenFrame.SLDPRT
