Open-BeatBox/Open-BeatBox_Hardware/electronics/BB_lighting_V1/BB_lighting_V1.pdf

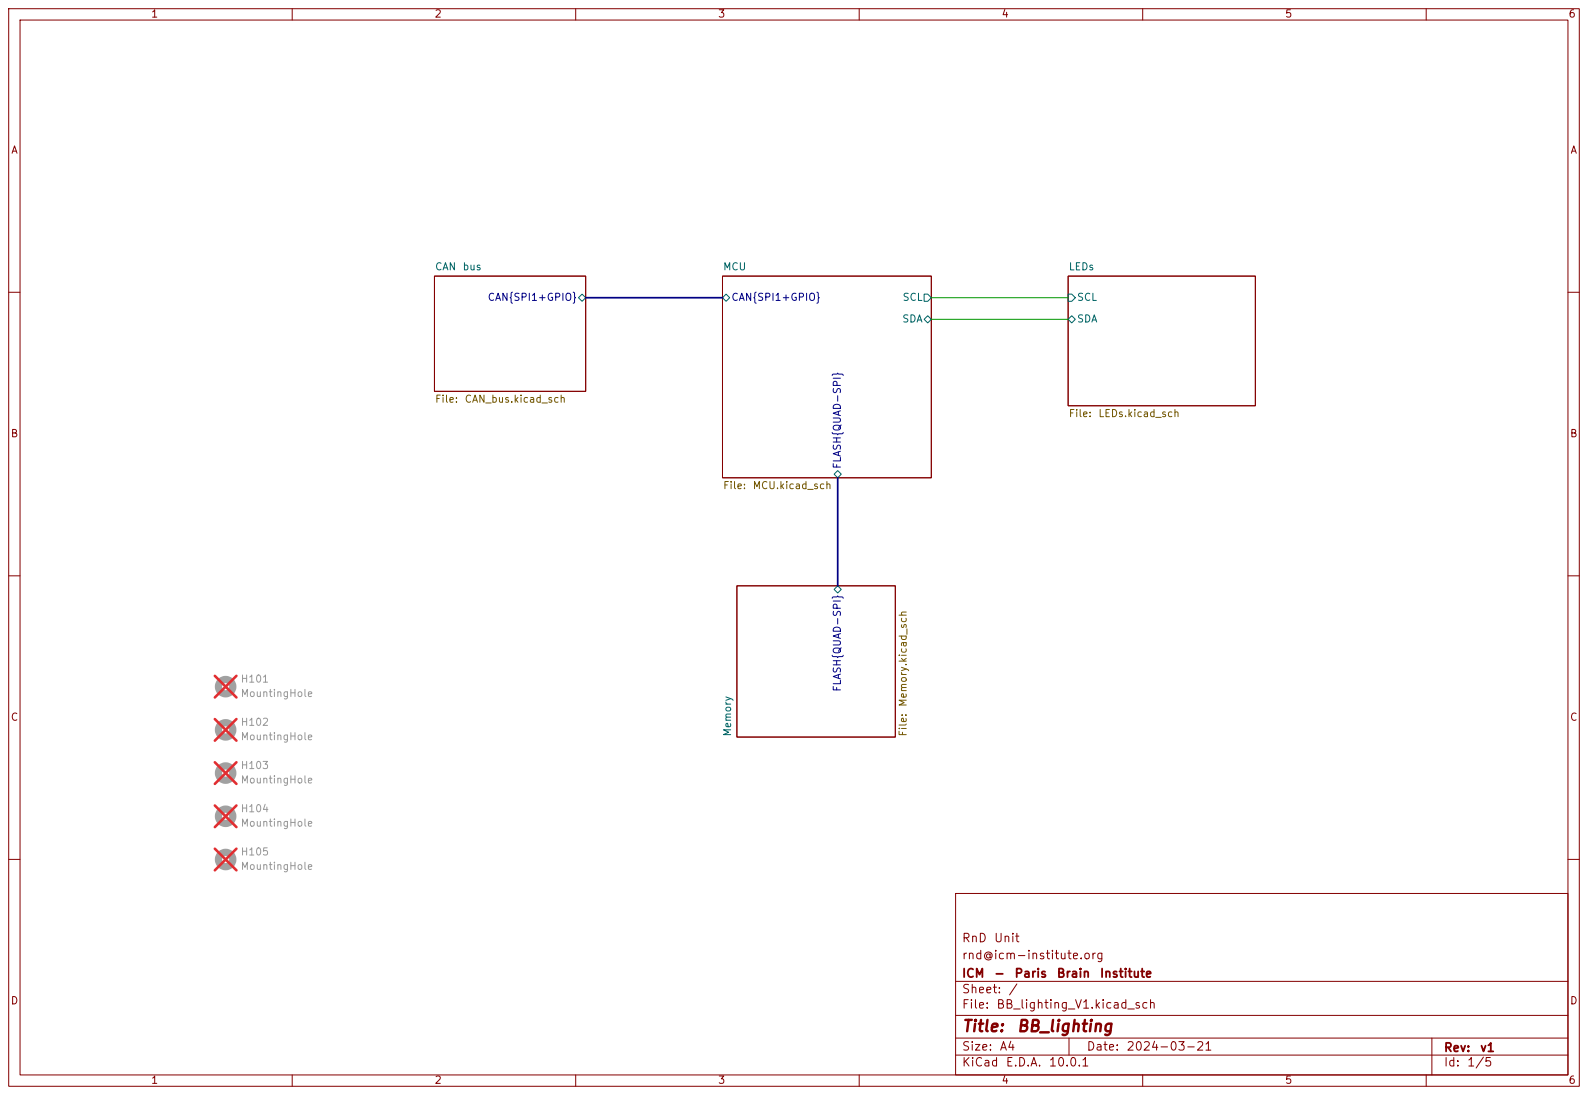
[picture p38: page 1]

RnD Unit FLASH{QUAD-SPI}

H105 MountingHole H103 MountingHole H102 MountingHole H101 MountingHole H104 MountingHole

rnd@icm-institute.org
ICM - Paris Brain Institute
Sheet: /
File: BB_lighting_V1.kicad_sch
Title: BB_lighting

Size: A4 | Rev: v1
KiCad E.D.A. 10.0.1 | Id: 1/5

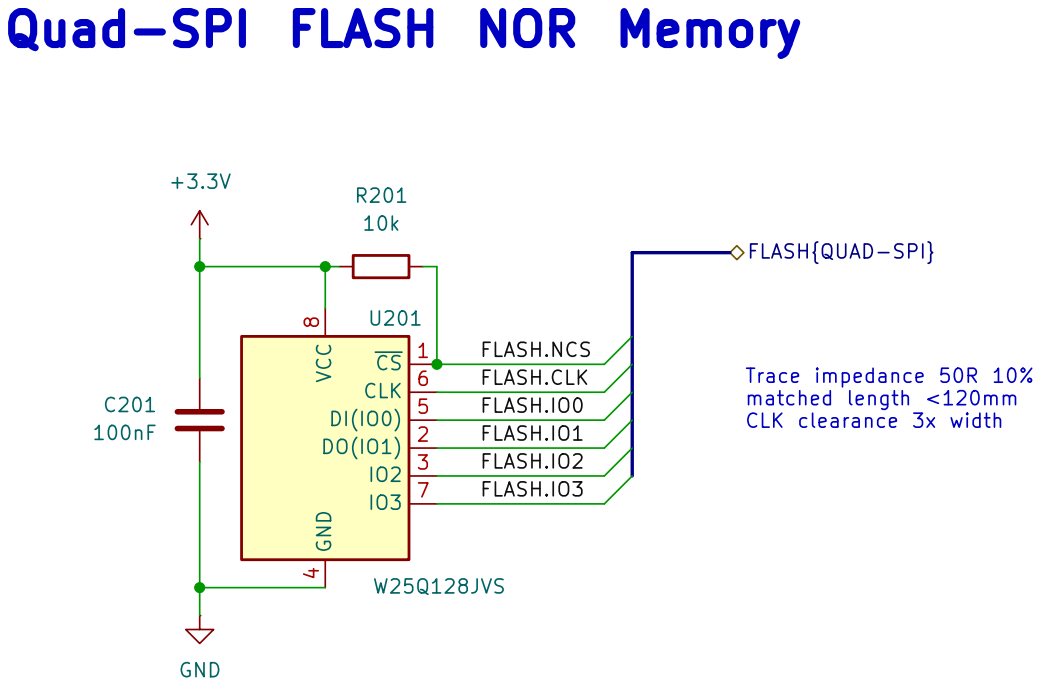
[picture p39: page 2]

FLASH.IO0 Quad-SPI FLASH NOR Memory

FLASH{QUAD-SPI} FLASH.IO3

Trace impedance 50R 10% matched length <120mm

RnD Unit
rnd@icm-institute.org
ICM - Paris Brain Institute
Sheet: /Memory/
File: Memory.kicad_sch
Title: BB_lighting

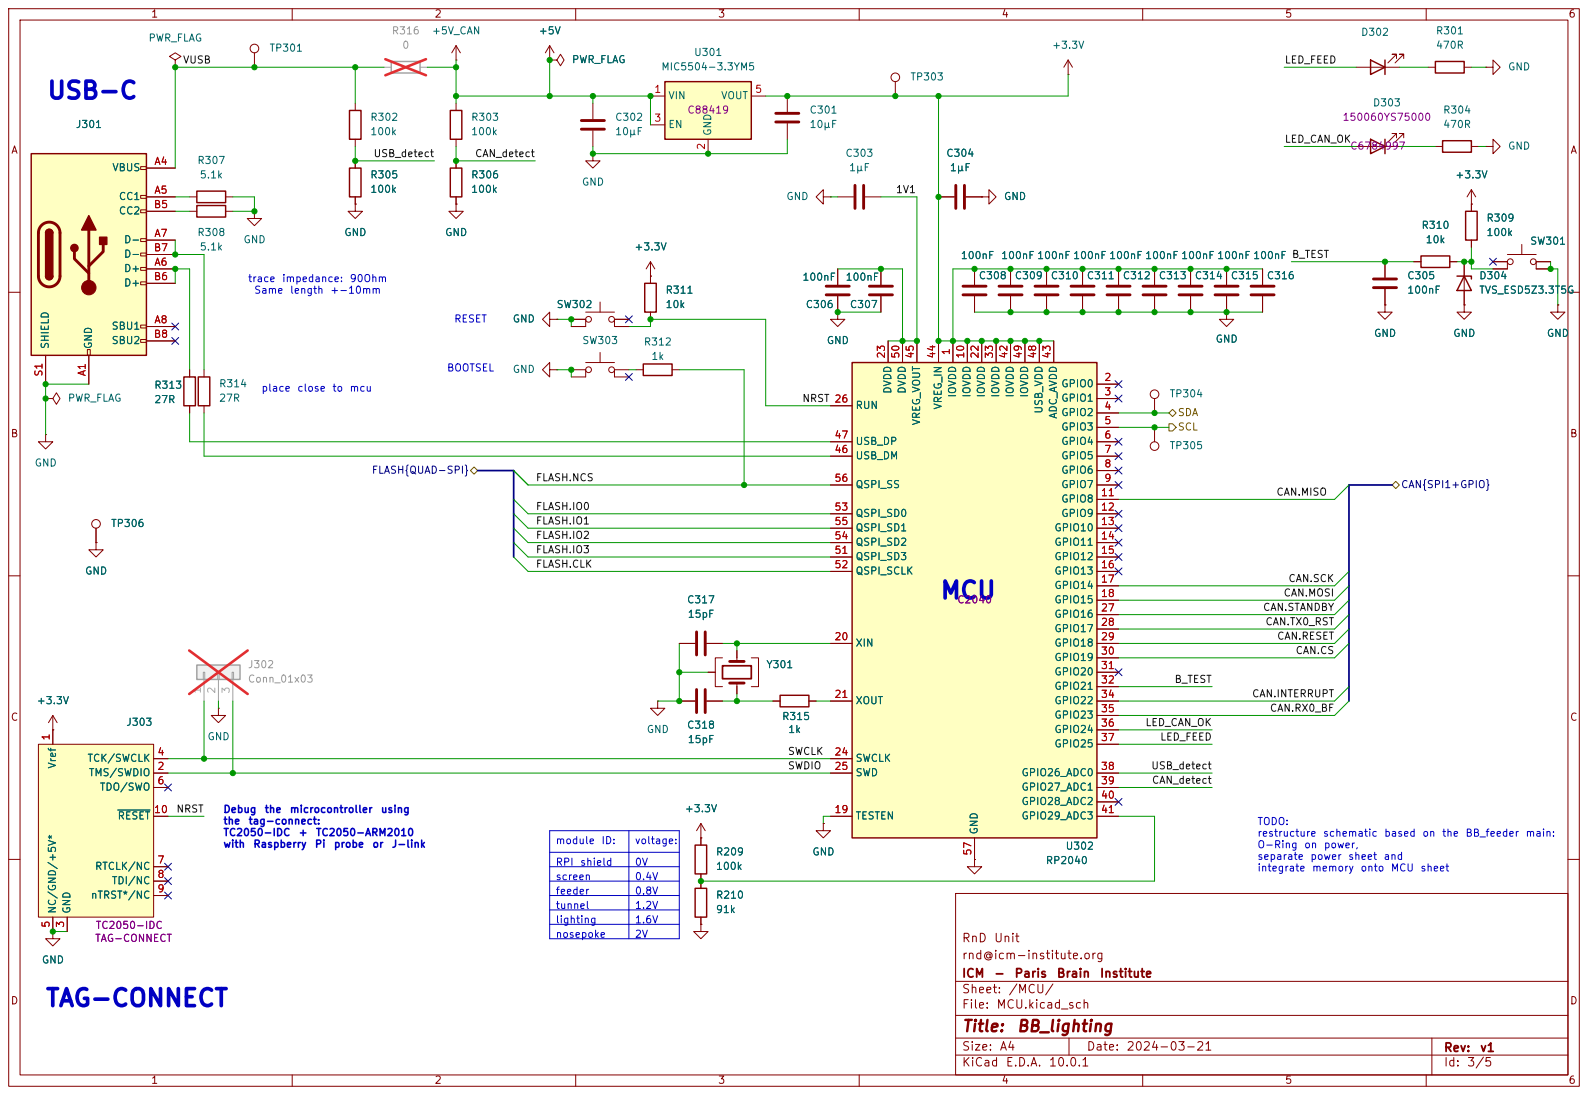
[picture p40: page 3]

place close to mcu

SDA SCL FLASH{QUAD-SPI}

Debug the microcontroller using
the tag-connect: TC2050-IDC + TC2050-ARM2010 with Raspberry Pi probe or J-link

TODO:
restructure schematic based on the BB_feeder main: O-Ring on power, separate power sheet and

screen | 0.4V
feeder | 0.8V

integrate memory onto MCU sheet

RnD Unit
rnd@icm-institute.org
ICM - Paris Brain Institute
Sheet: /MCU/
File: MCU.kicad_sch
Title: BB_lighting

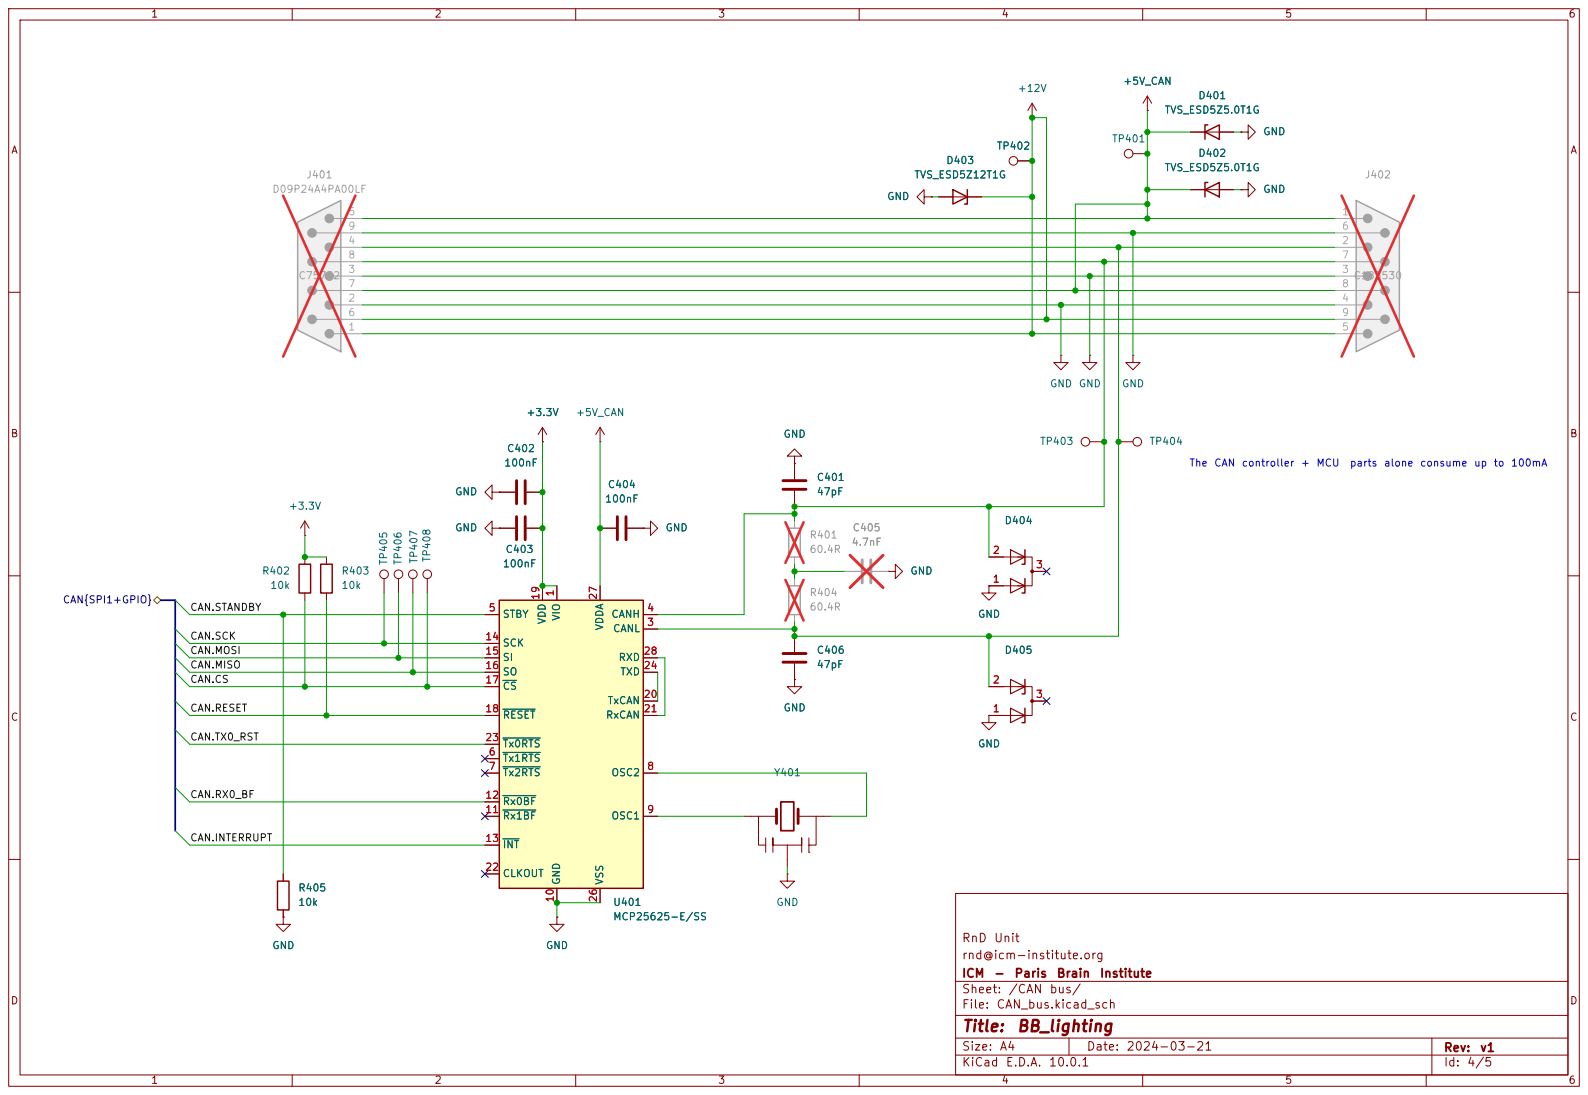
[picture p41: page 4]

The CAN controller + MCU parts alone consume up to 100mA GND

CAN.STANDBY CAN.RX0_BF CAN.RESET CAN.TX0_RST CAN.SCK

RnD Unit
rnd@icm-institute.org
ICM - Paris Brain Institute
Sheet: /CAN bus/
File: CAN_bus.kicad_sch
Title: BB_lighting

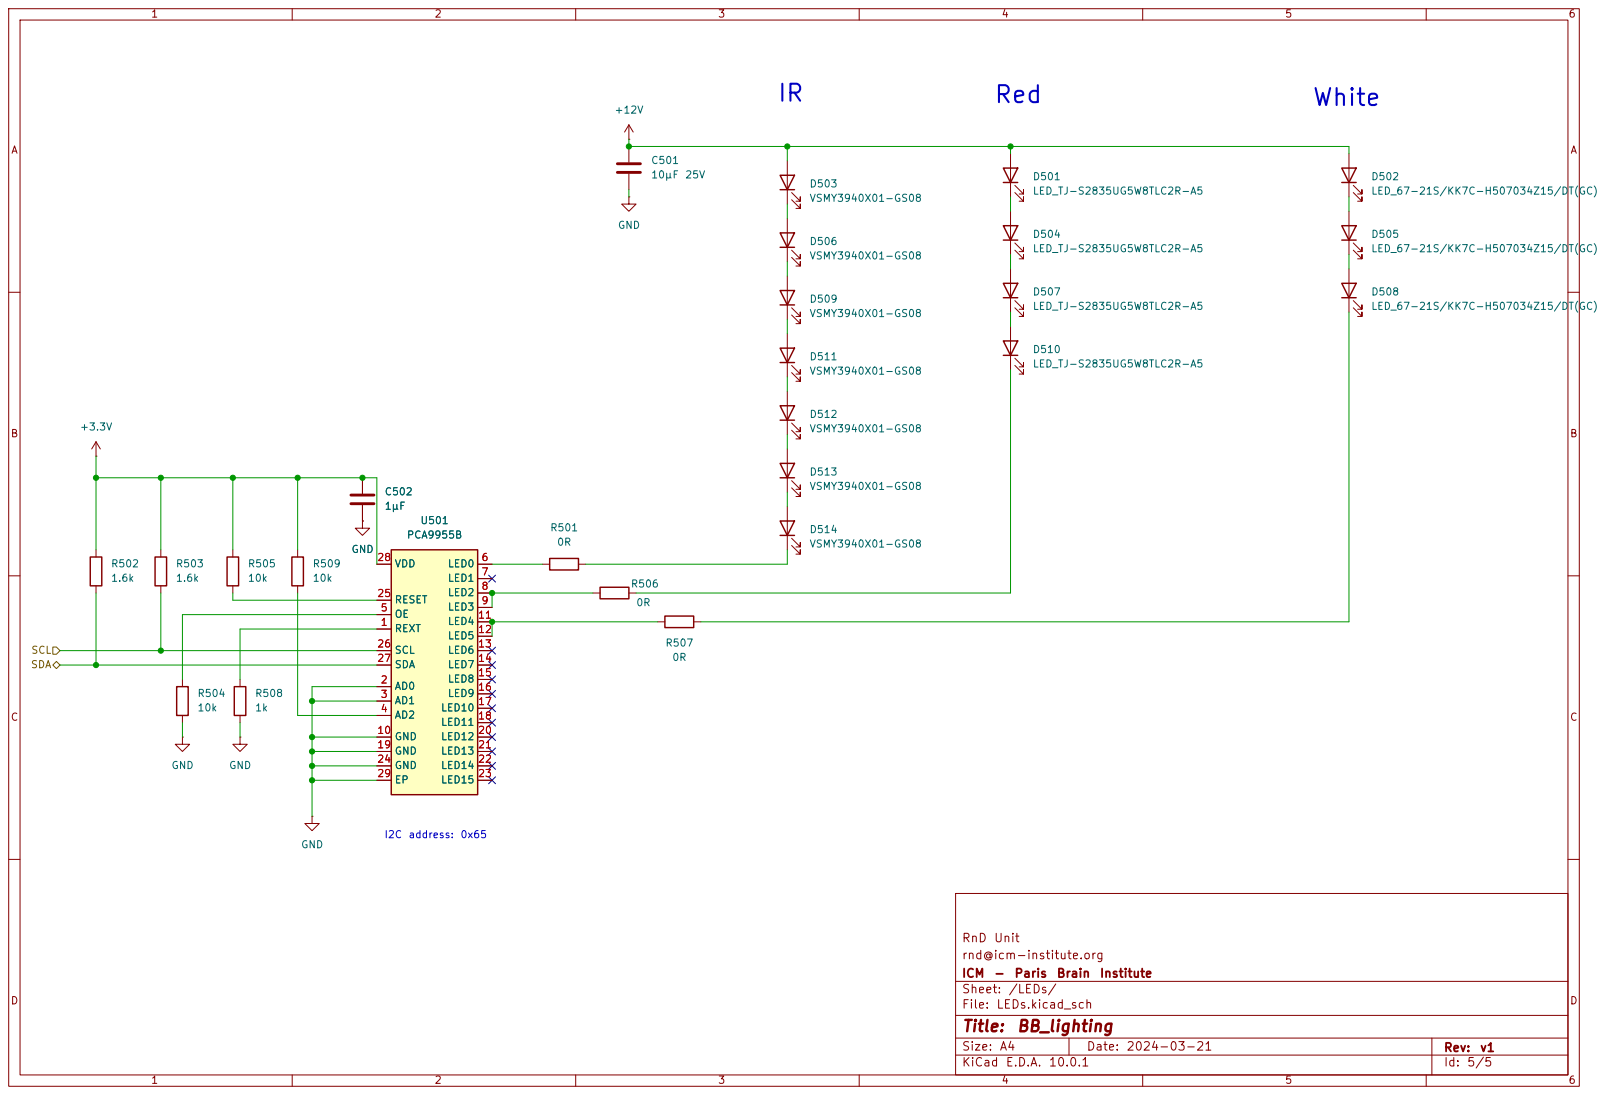
[picture p42: page 5]

rnd@icm-institute.org
ICM - Paris Brain Institute
Sheet: /LEDs/
File: LEDs.kicad_sch
Title: BB_lighting
