Open-BeatBox/Open-BeatBox_Hardware/electronics/BB_RPI_shield_V1/BB_RPI_shield_V1.pdf

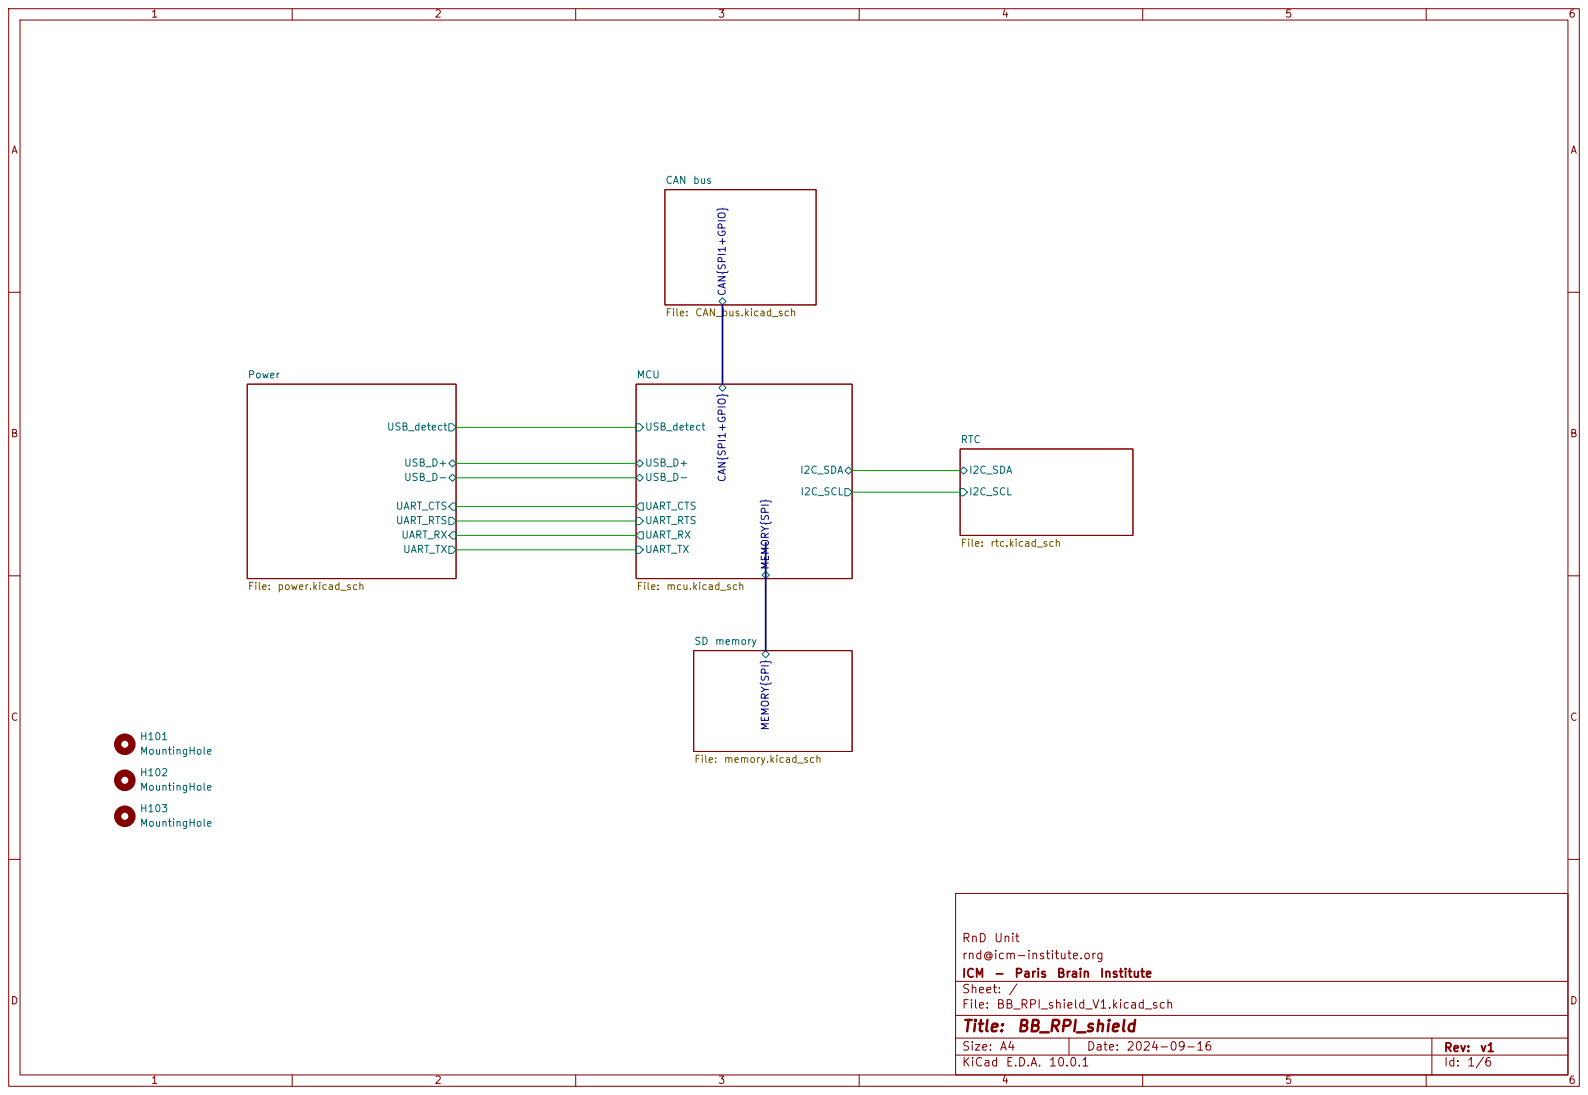
[picture p43: page 1]

USB_detect UART_CTS UART_RTS UART_RX UART_TX Power File: power.kicad_sch H103 MountingHole H101 MountingHole H102 MountingHole

rnd@icm-institute.org
ICM - Paris Brain Institute
Sheet: /
File: BB_RPI_shield_V1.kicad_sch
Title: BB_RPI_shield

Size: A4 | Rev: v1
KiCad E.D.A. 10.0.1 | Id: 1/6

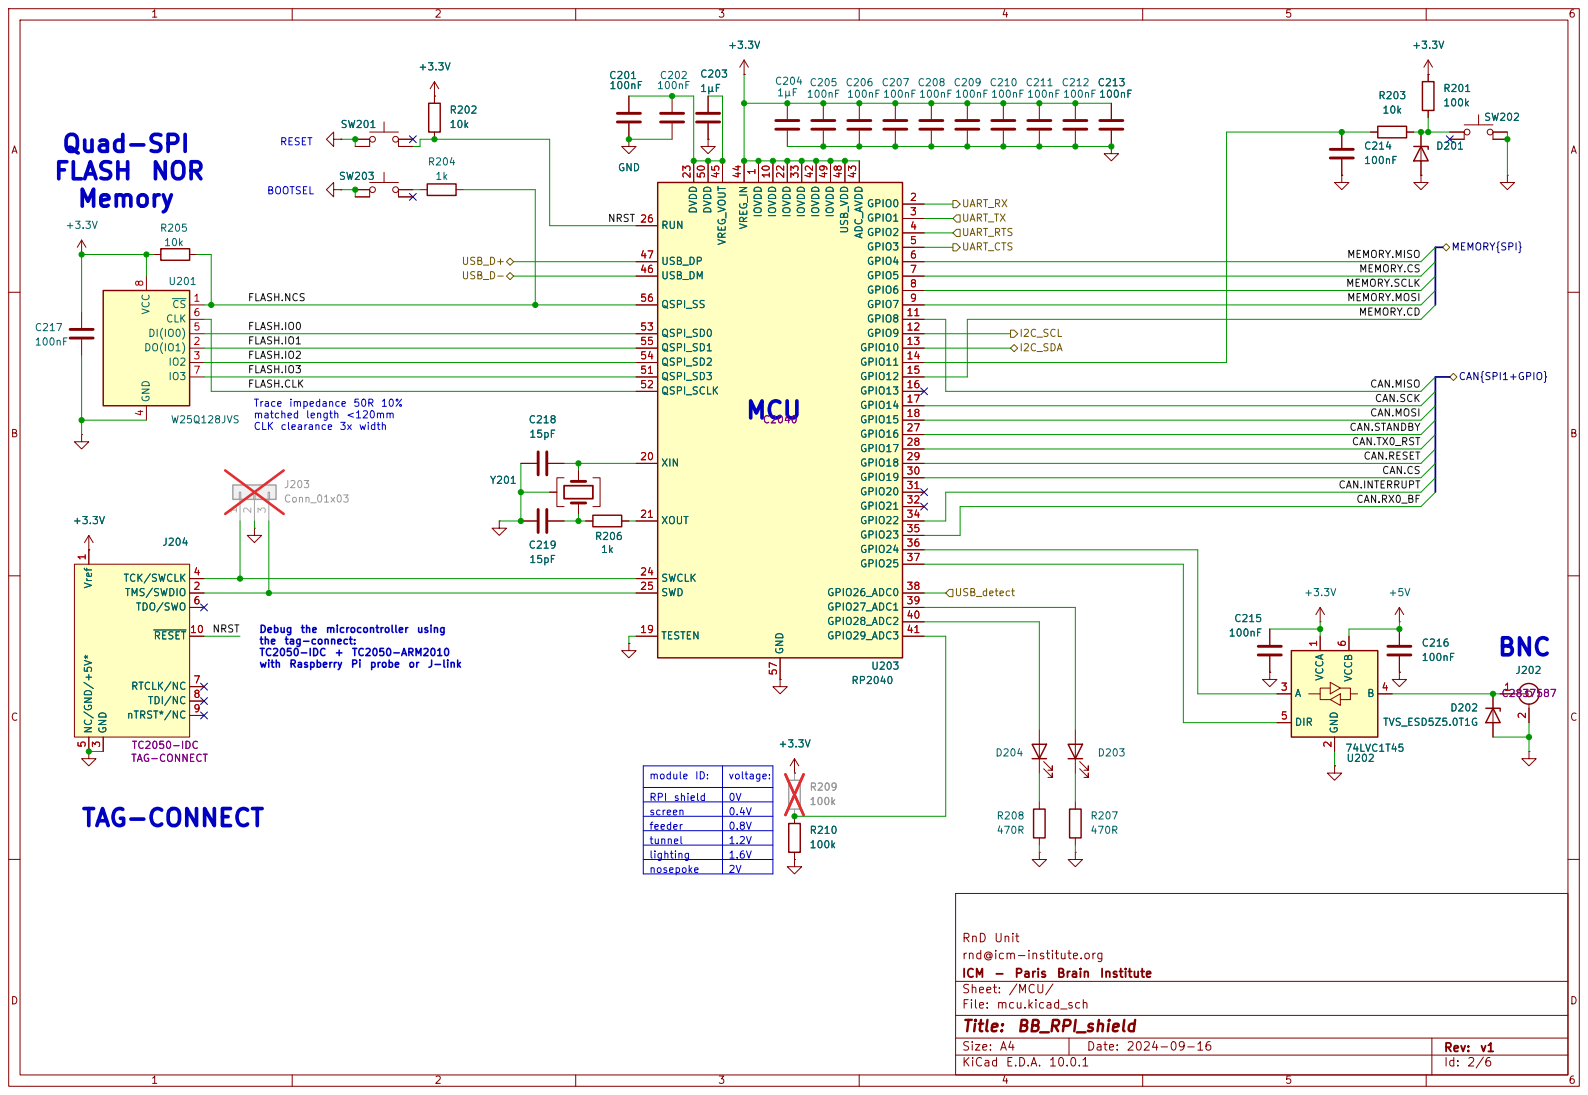
[picture p44: page 2]

CLK clearance 3x width RESET BOOTSEL Quad-SPI
FLASH NOR
Memory

MEMORY{SPI}
CAN.MISO MEMORY.CS

FLASH.IO1
FLASH.IO2

Trace impedance 50R 10% matched length <120mm

Debug the microcontroller using

screen | 0.4V
feeder | 0.8V
tunnel | 1.2V

RnD Unit
rnd@icm-institute.org
ICM - Paris Brain Institute
Sheet: /MCU/
File: mcu.kicad_sch
Title: BB_RPI_shield

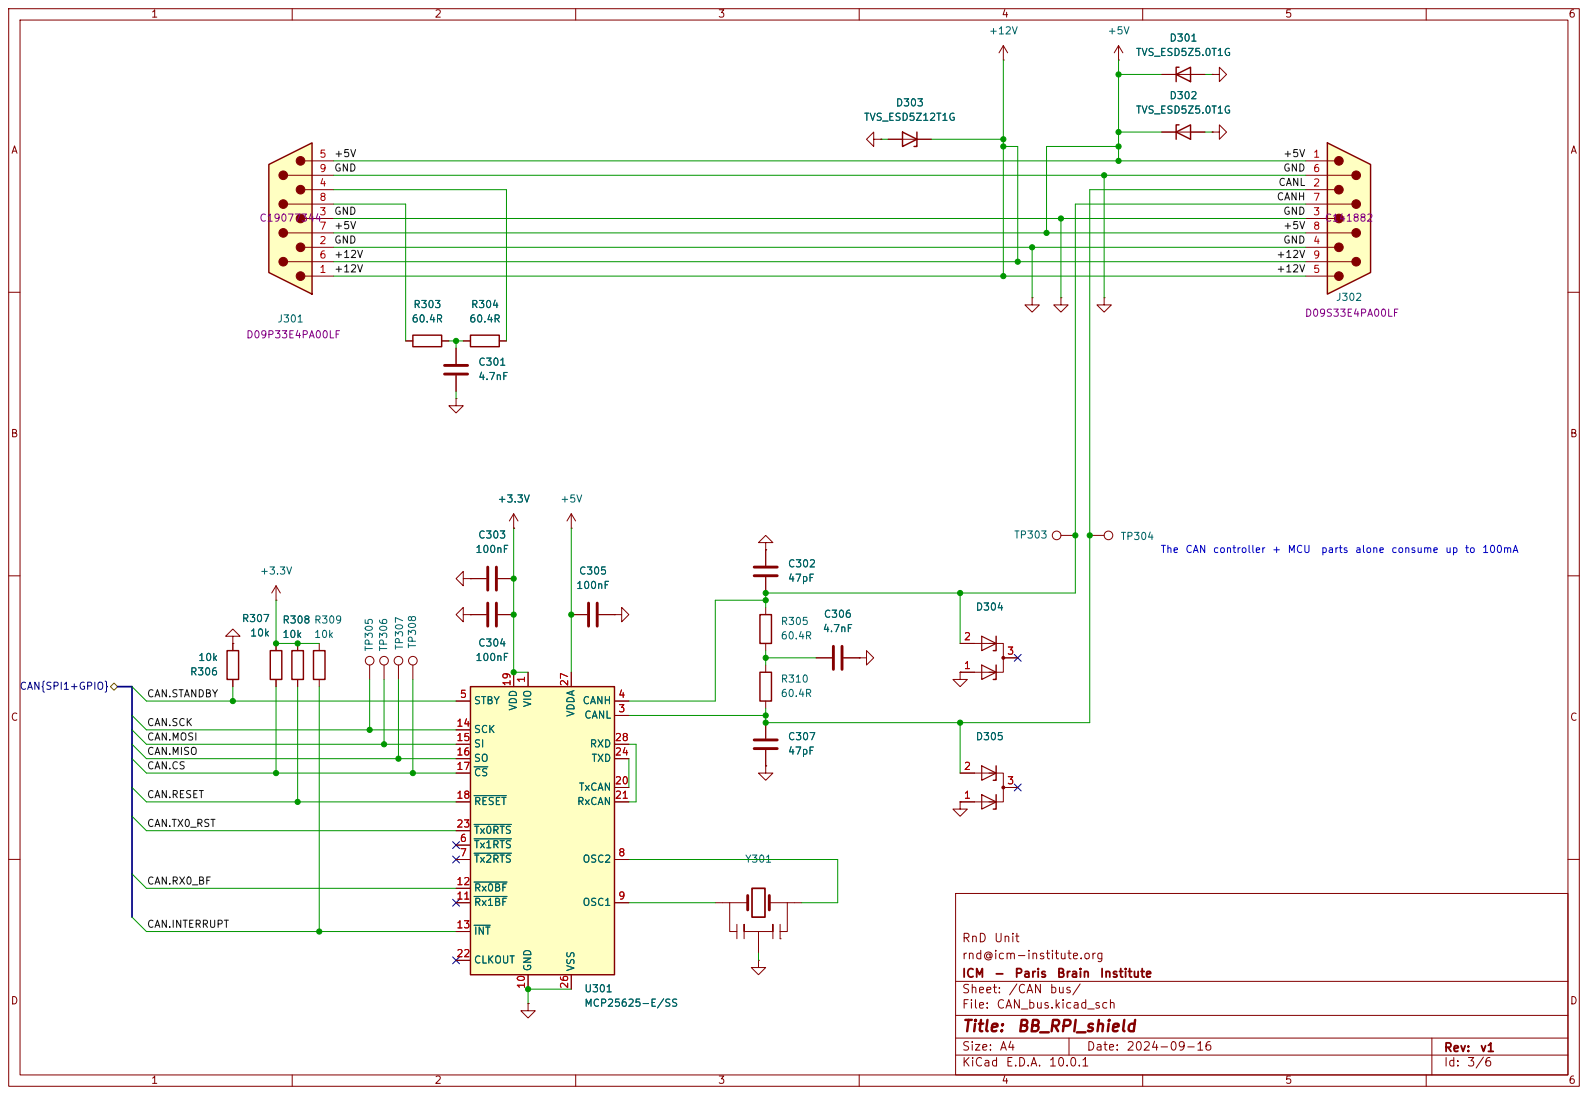
[picture p45: page 3]

The CAN controller + MCU parts alone consume up to 100mA

CAN.CS CAN.RESET CAN.MISO

rnd@icm-institute.org
ICM - Paris Brain Institute
Sheet: /CAN bus/
File: CAN_bus.kicad_sch
Title: BB_RPI_shield

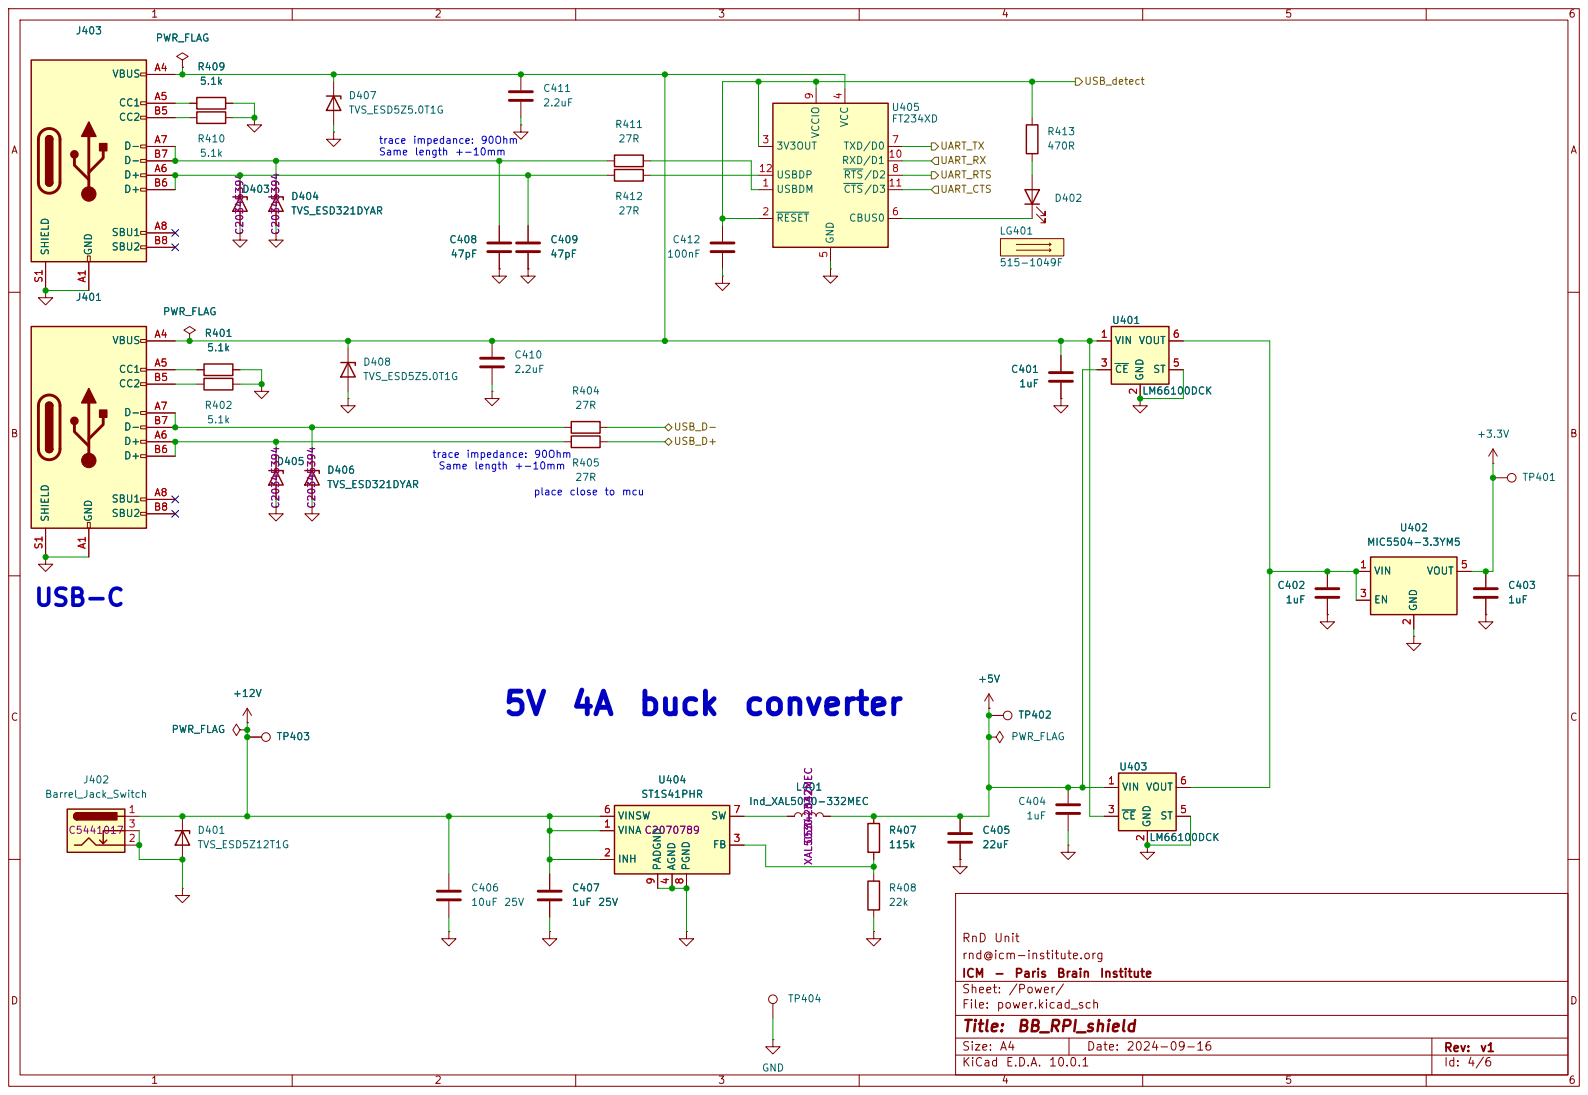
[picture p46: page 4]

place close to mcu D406

rnd@icm-institute.org
ICM - Paris Brain Institute
Sheet: /Power/
File: power.kicad_sch
Title: BB_RPI_shield

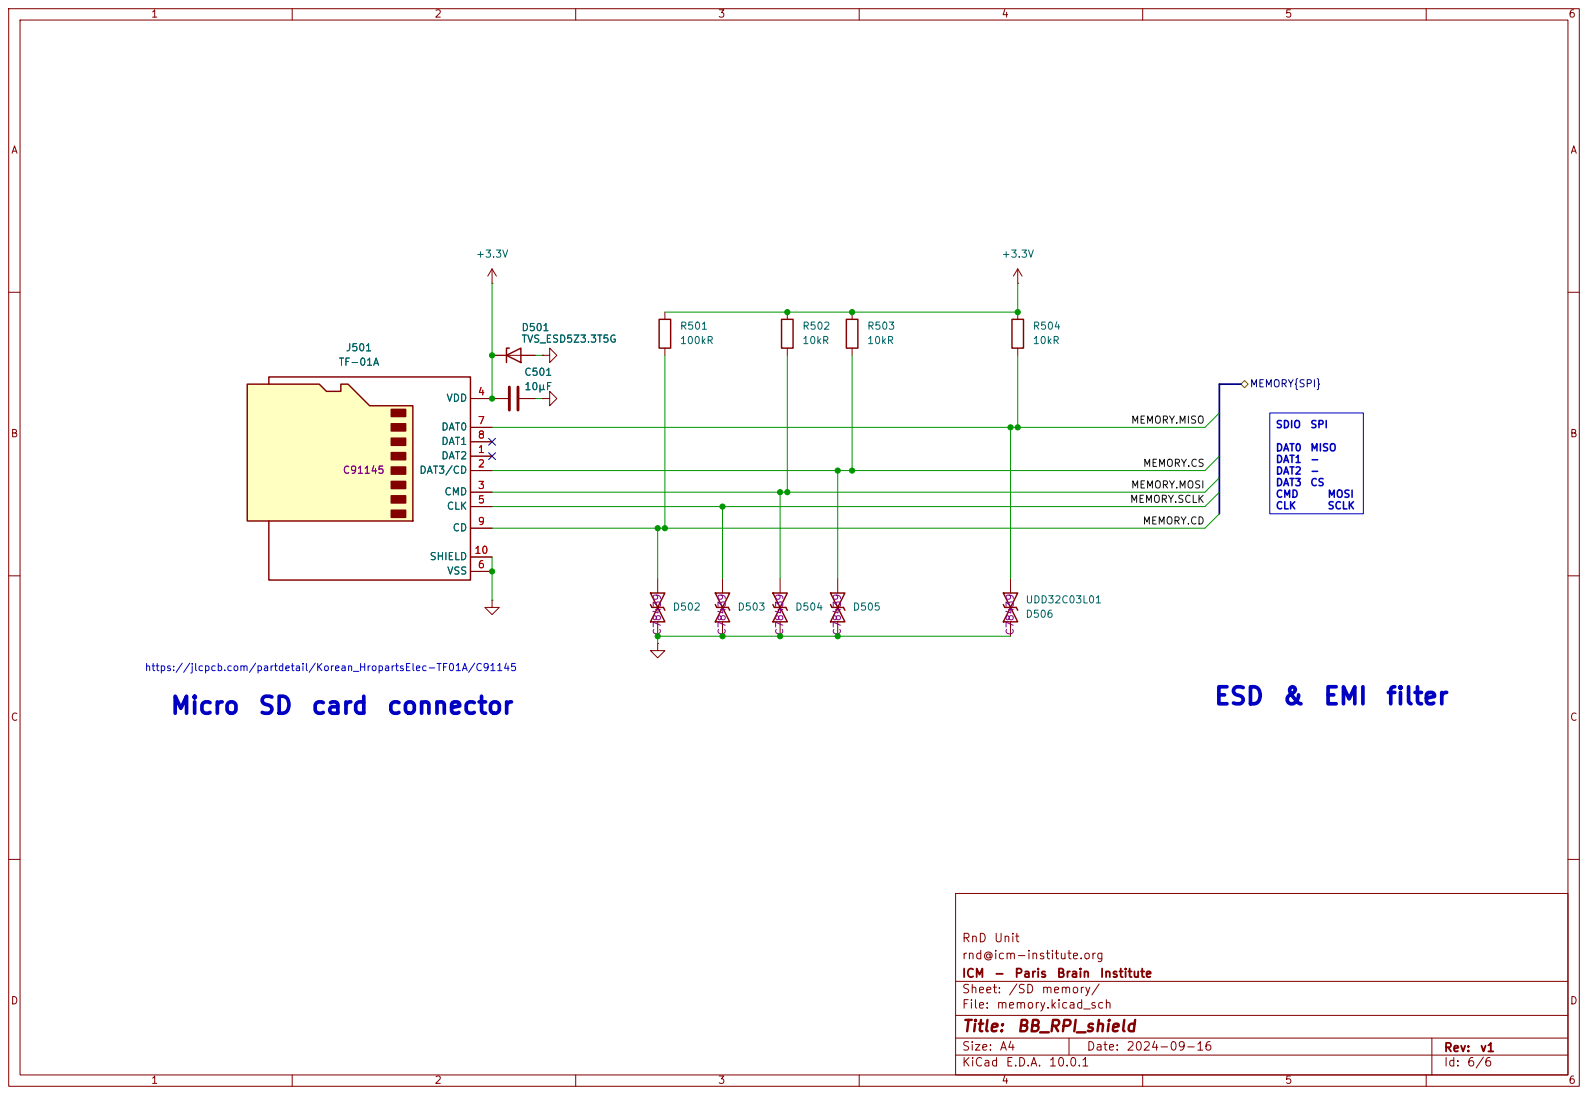
[picture p47: page 5]

https://jlcpcb.com/partdetail/Korean_HropartsElec-TF01A/C91145

rnd@icm-institute.org
ICM - Paris Brain Institute
Sheet: /SD memory/
File: memory.kicad_sch
Title: BB_RPI_shield

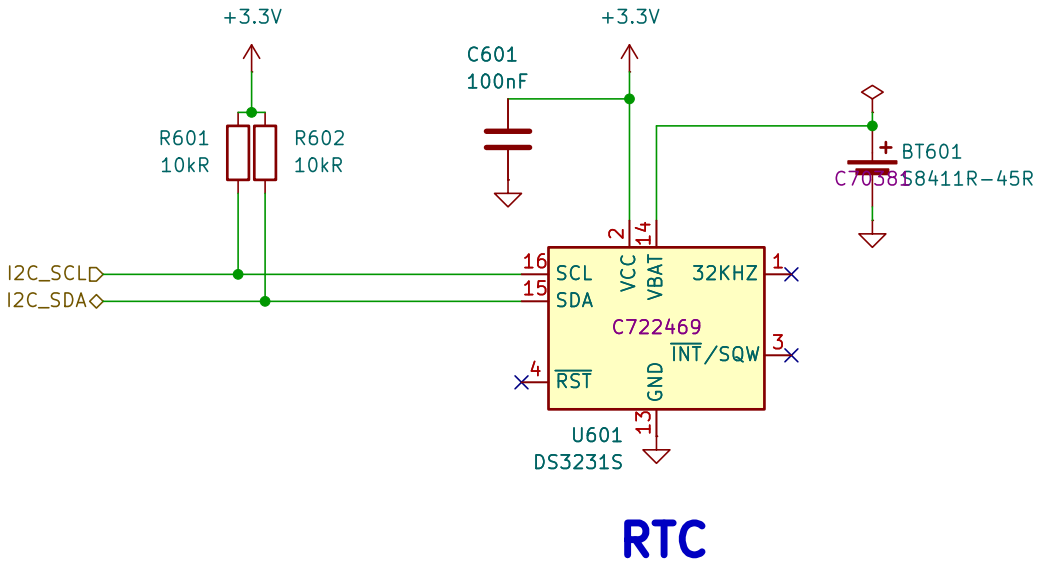
[picture p48: page 6]

RnD Unit
rnd@icm-institute.org
ICM - Paris Brain Institute
Sheet: /RTC/
File: rtc.kicad_sch
Title: BB_RPI_shield
