Open-BeatBox/Open-BeatBox_Hardware/electronics/BB_feeder_IRBarrier_V1/BB_feeder_IRBarrier_V1.pdf

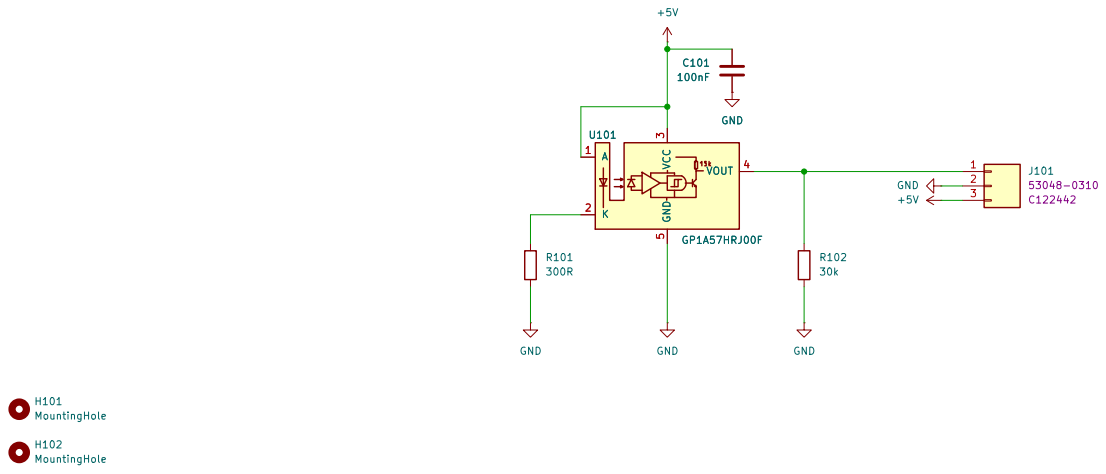
[picture p49: page 1]

rnd@icm-institute.org
ICM - Paris Brain Institute
Sheet: /
File: BB_feeder_IRBarrier_V1.kicad_sch
Title: BB_feeder_IRBarrier_V1

Size: A4 | Rev: v1
KiCad E.D.A. 10.0.1 | Id: 1/1
