Open-BeatBox/Open-BeatBox_Hardware/electronics/BB_feeder_main_V1/BB_feeder_main_V1.pdf

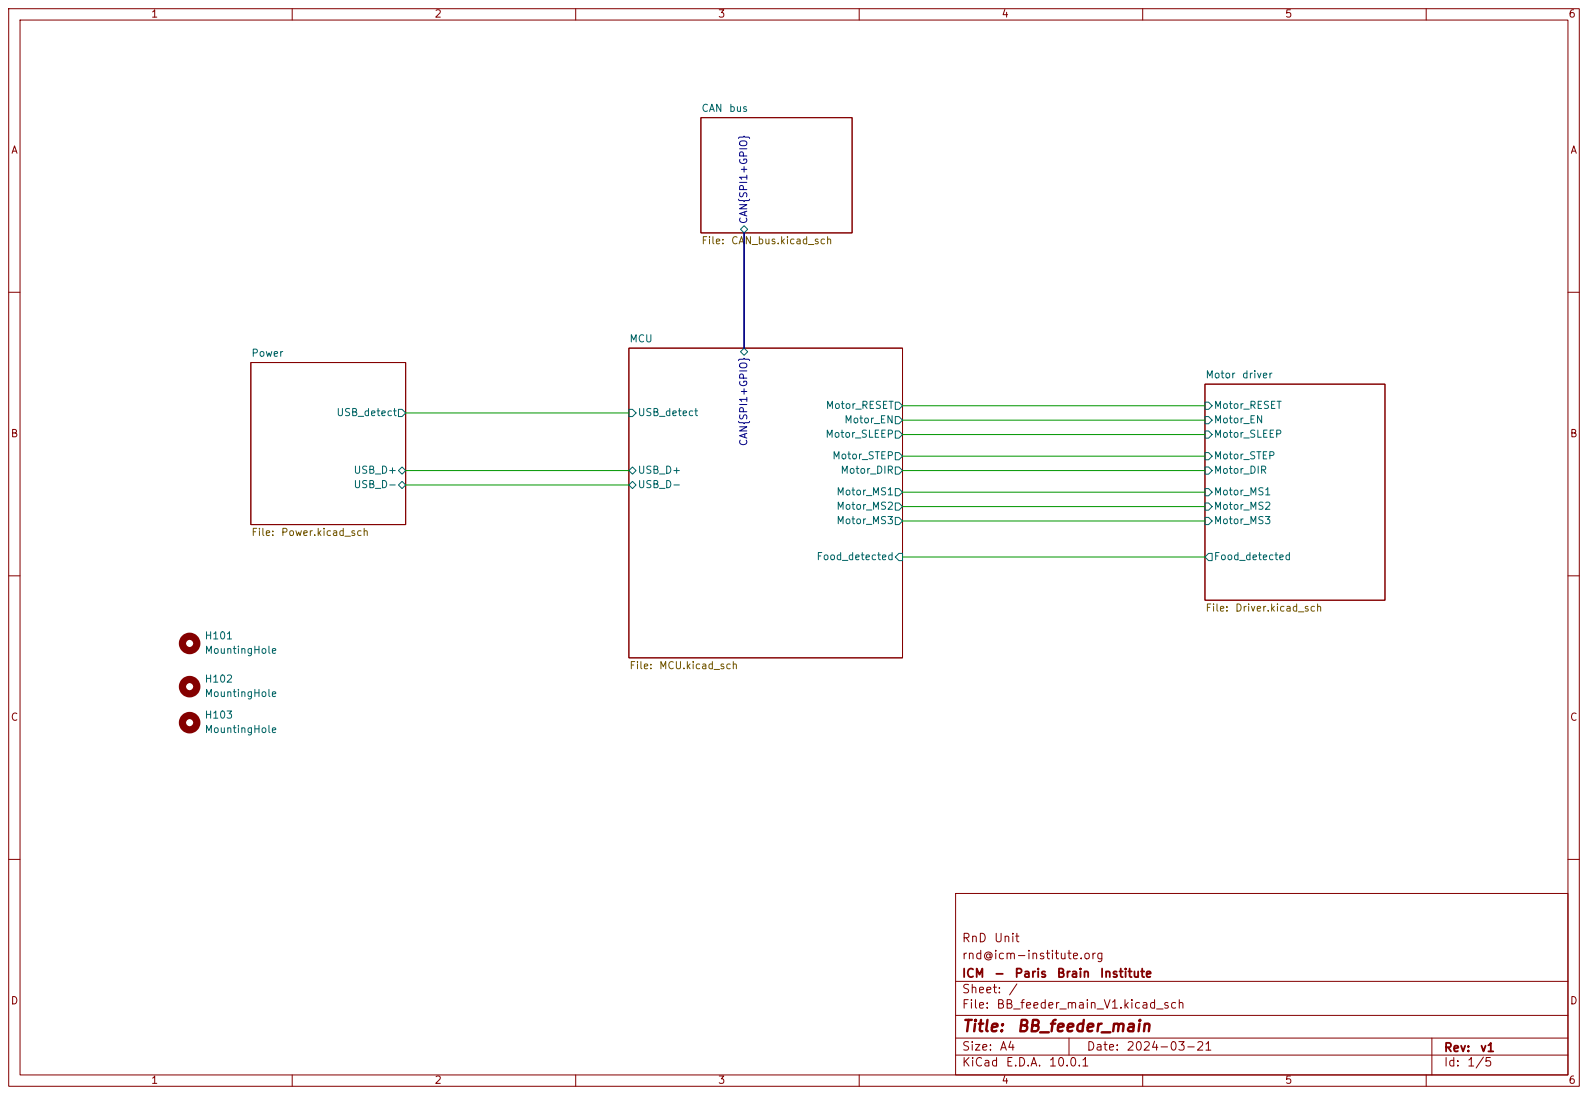
[picture p50: page 1]

Power File: Power.kicad_sch H102 MountingHole H103 MountingHole H101 MountingHole

rnd@icm-institute.org
ICM - Paris Brain Institute
Sheet: /
File: BB_feeder_main_V1.kicad_sch
Title: BB_feeder_main

Size: A4 | Rev: v1
KiCad E.D.A. 10.0.1 | Id: 1/5

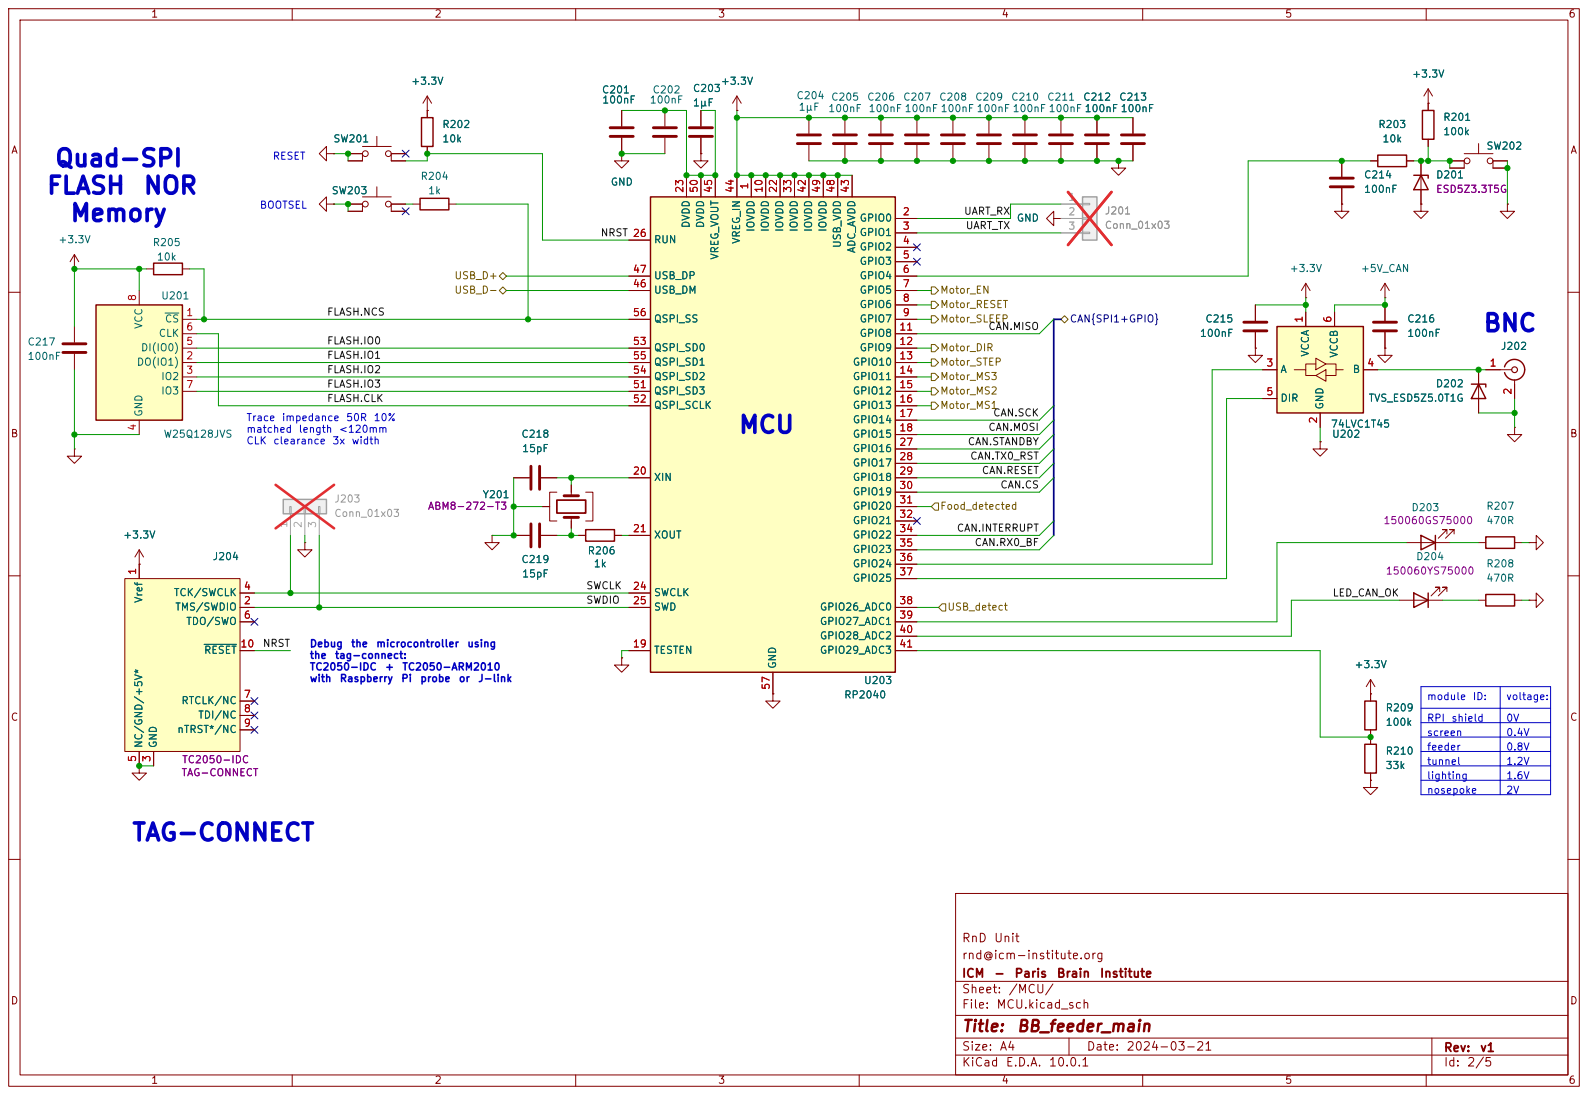
[picture p51: page 2]

RESET Debug the microcontroller using

Trace impedance 50R 10% matched length <120mm

CLK clearance 3x width TAG-CONNECT

the tag-connect: TC2050-IDC + TC2050-ARM2010 with Raspberry Pi probe or J-link

screen | 0.4V
feeder | 0.8V
tunnel | 1.2V

RnD Unit
rnd@icm-institute.org
ICM - Paris Brain Institute
Sheet: /MCU/
File: MCU.kicad_sch
Title: BB_feeder_main

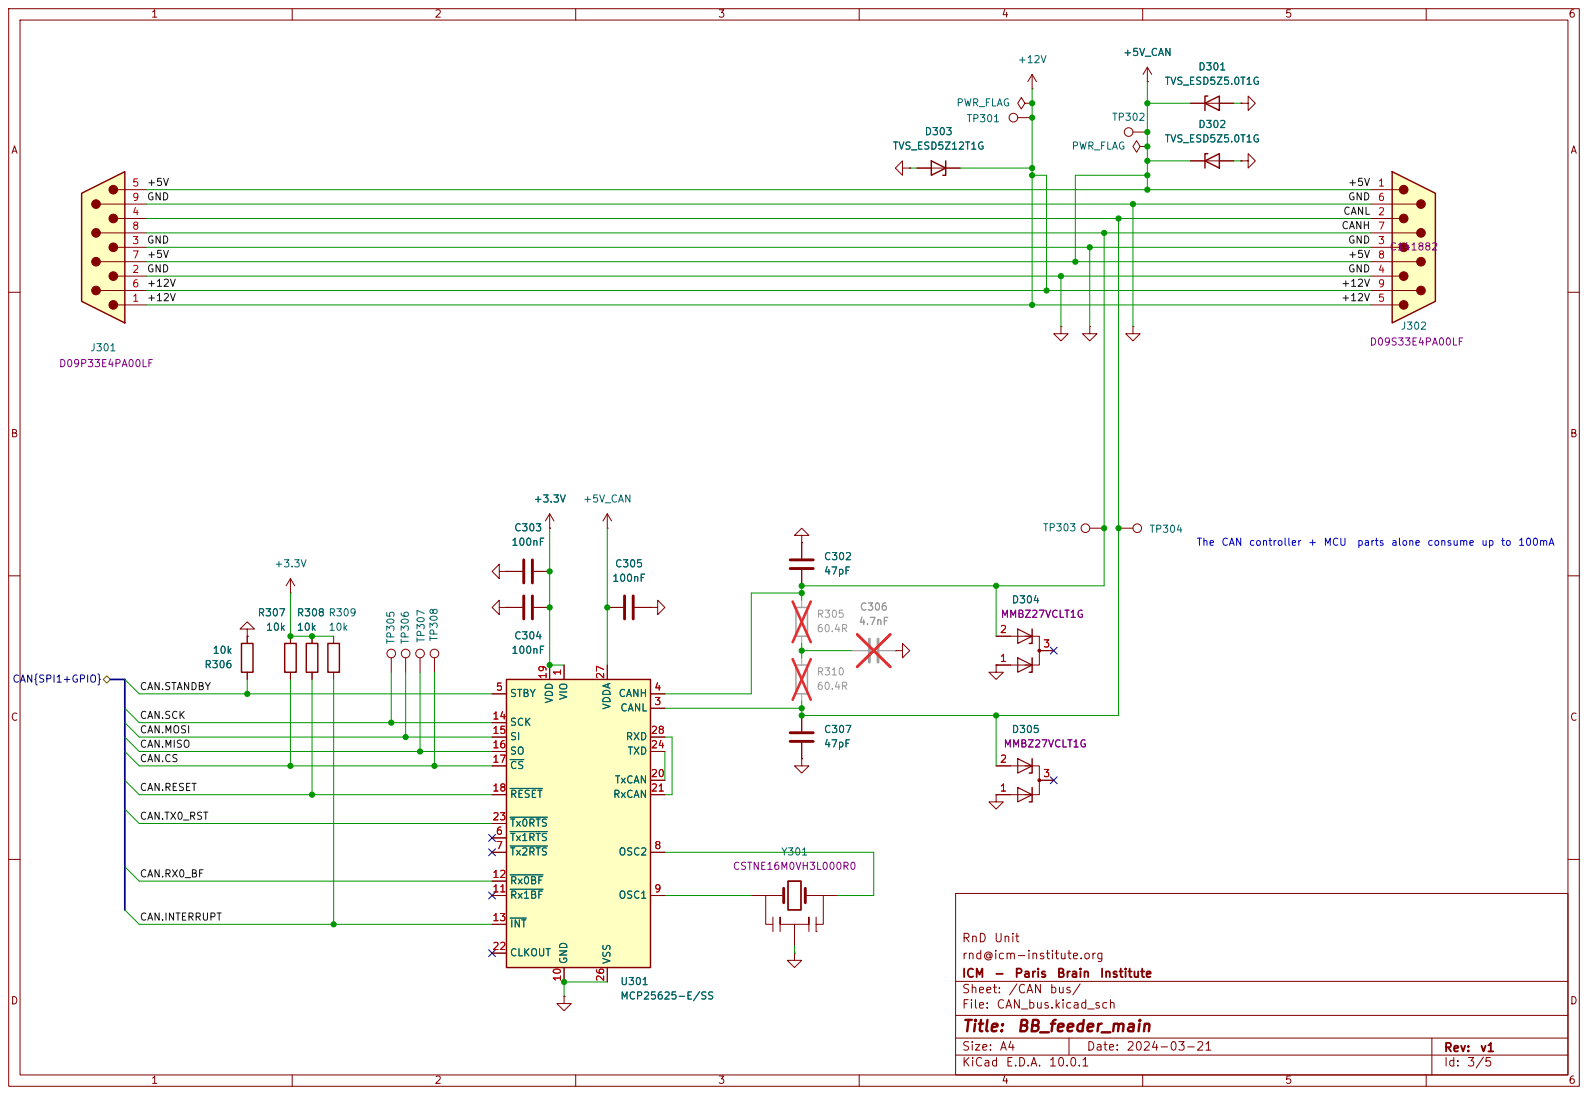
[picture p52: page 3]

The CAN controller + MCU parts alone consume up to 100mA C307

rnd@icm-institute.org
ICM - Paris Brain Institute
Sheet: /CAN bus/
File: CAN_bus.kicad_sch
Title: BB_feeder_main

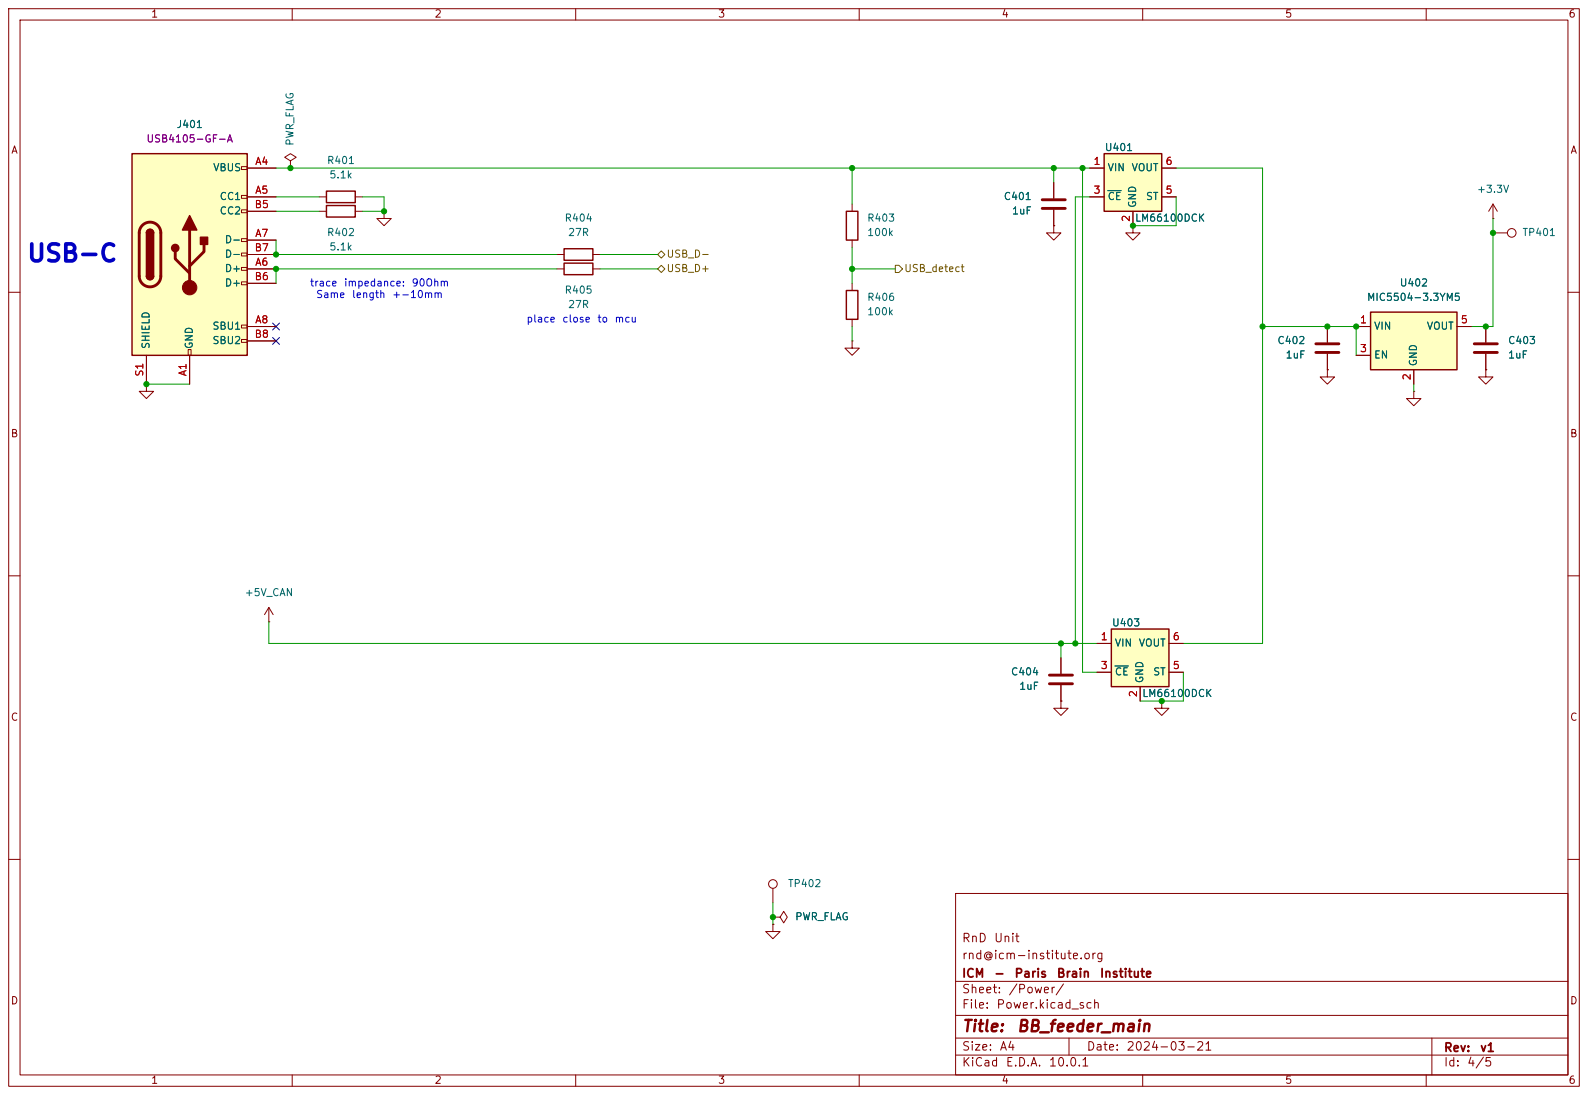
[picture p53: page 4]

RnD Unit
rnd@icm-institute.org
ICM - Paris Brain Institute
Sheet: /Power/
File: Power.kicad_sch
Title: BB_feeder_main

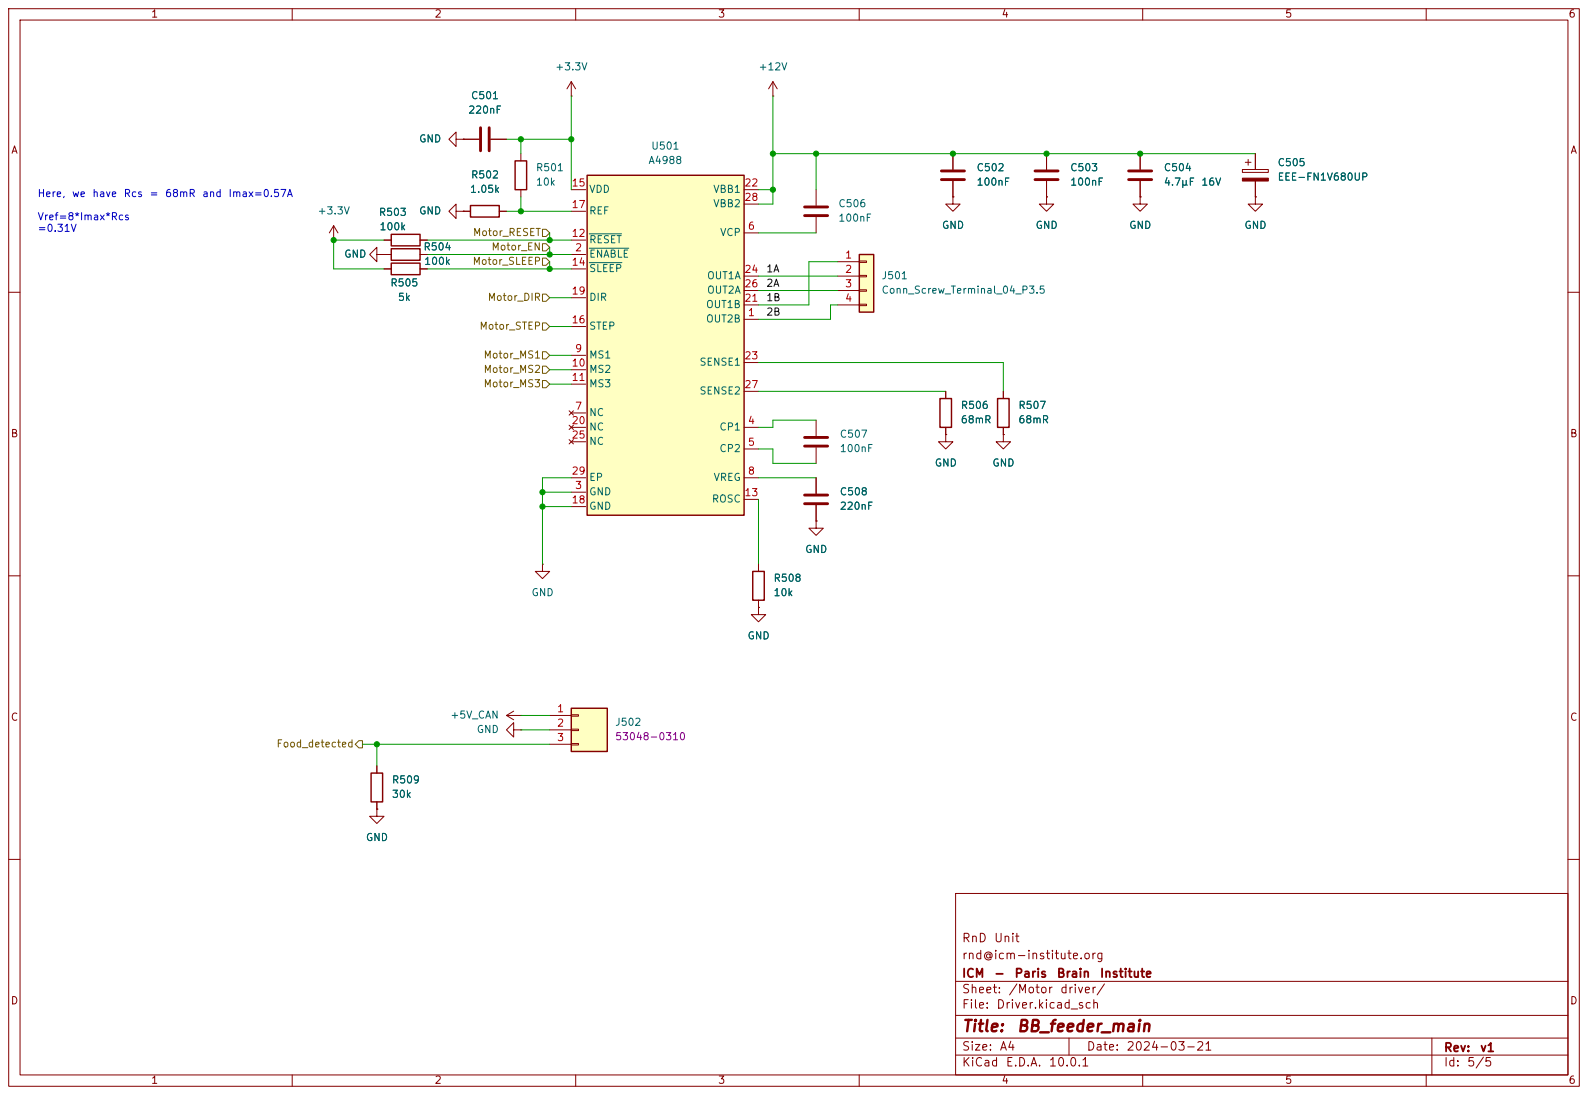
[picture p54: page 5]

2A1A1B Here, we have Rcs = 68mR and Imax=0.57A

RnD Unit
rnd@icm-institute.org
ICM - Paris Brain Institute
Sheet: /Motor driver/
File: Driver.kicad_sch
Title: BB_feeder_main
