Open-BeatBox/Open-BeatBox_Hardware/electronics/BB_IR_light_curtain_V2_38k/BB_IR_light_curtain_V2_38.pdf

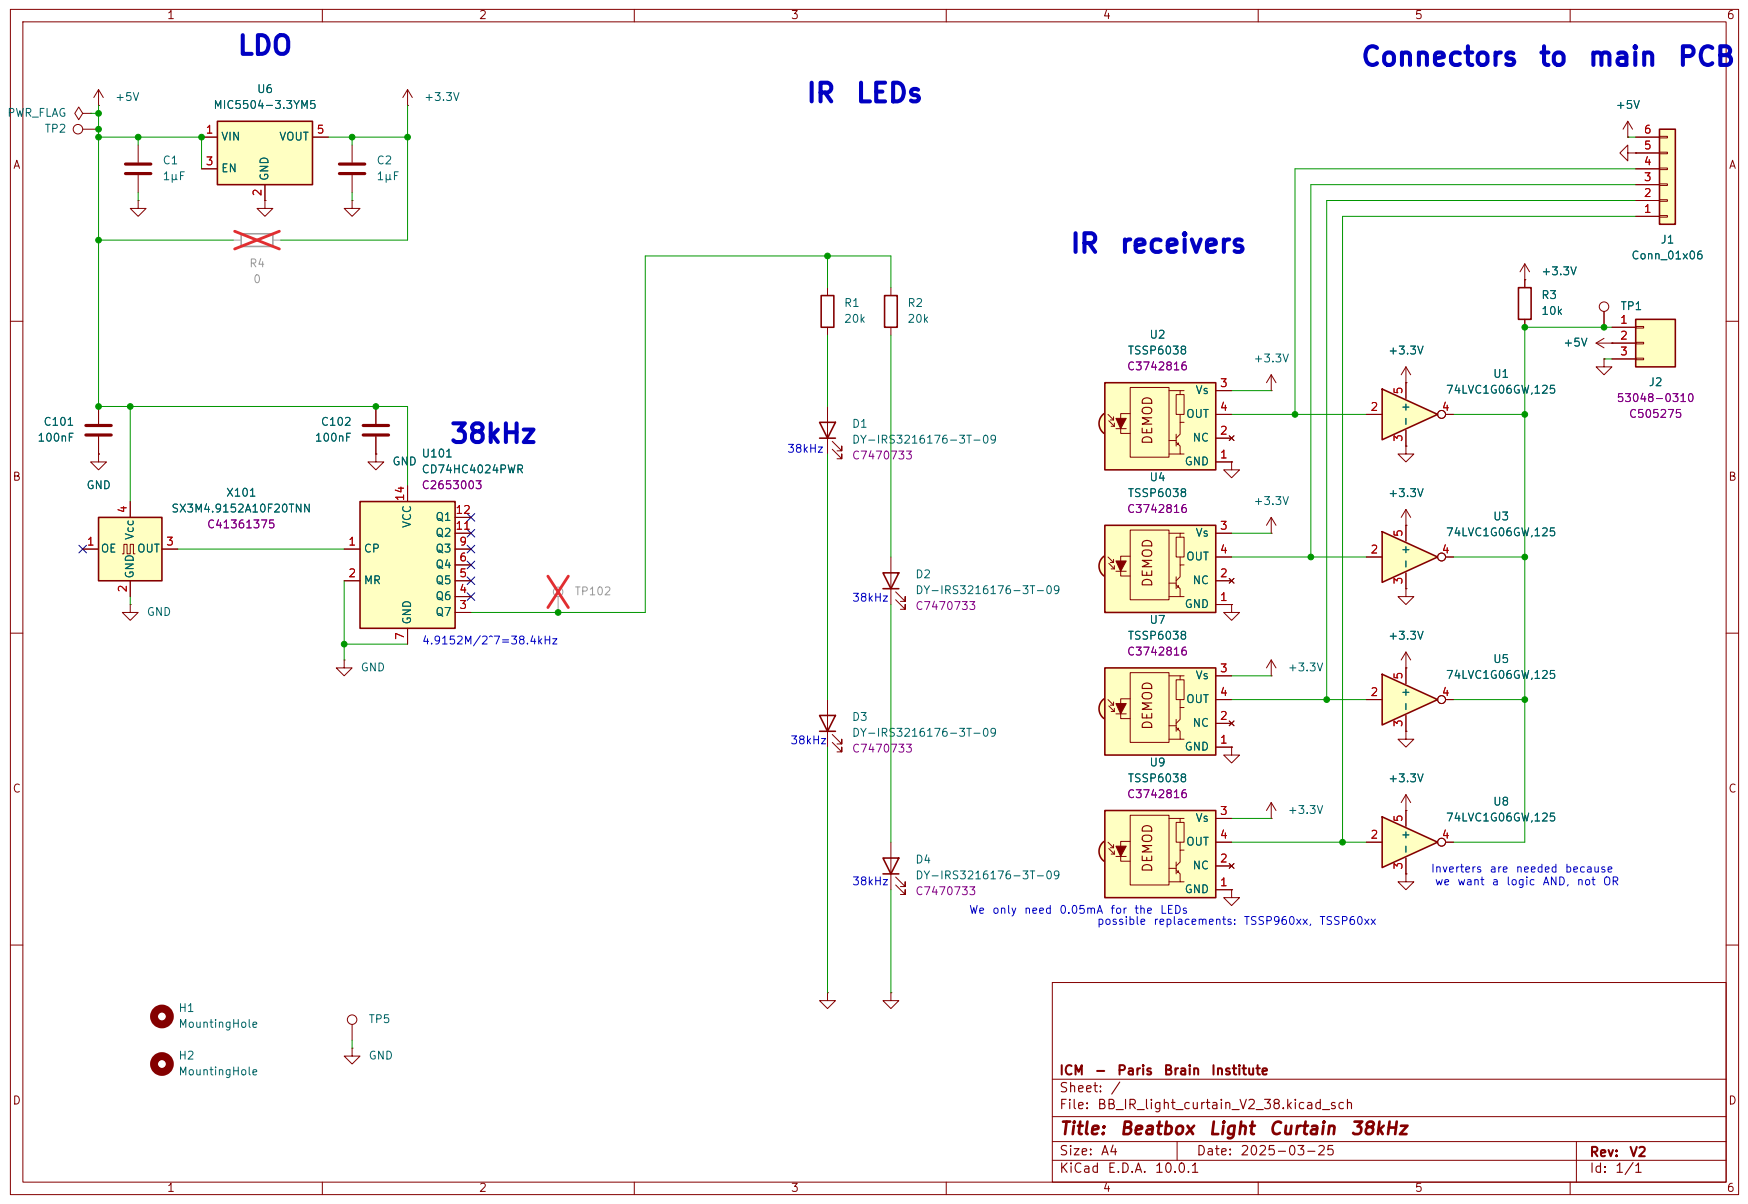
[picture p55: page 1]

74LVC1G06GW,125 +3.3V We only need 0.05mA for the LEDs possible replacements: TSSP960xx, TSSP60xx 38kHz 38kHz 38kHz LDO
Inverters are needed because we want a logic AND, not OR Connectors to main PCB

ICM - Paris Brain Institute
Sheet: /
File: BB_IR_light_curtain_V2_38.kicad_sch
Title: Beatbox Light Curtain 38kHz

Size: A4 | Rev: V2
KiCad E.D.A. 10.0.1 | Id: 1/1
