Open-BeatBox/Open-BeatBox_Hardware/electronics/BB_nosepoke_V1/BB_nosepoke_V1.pdf

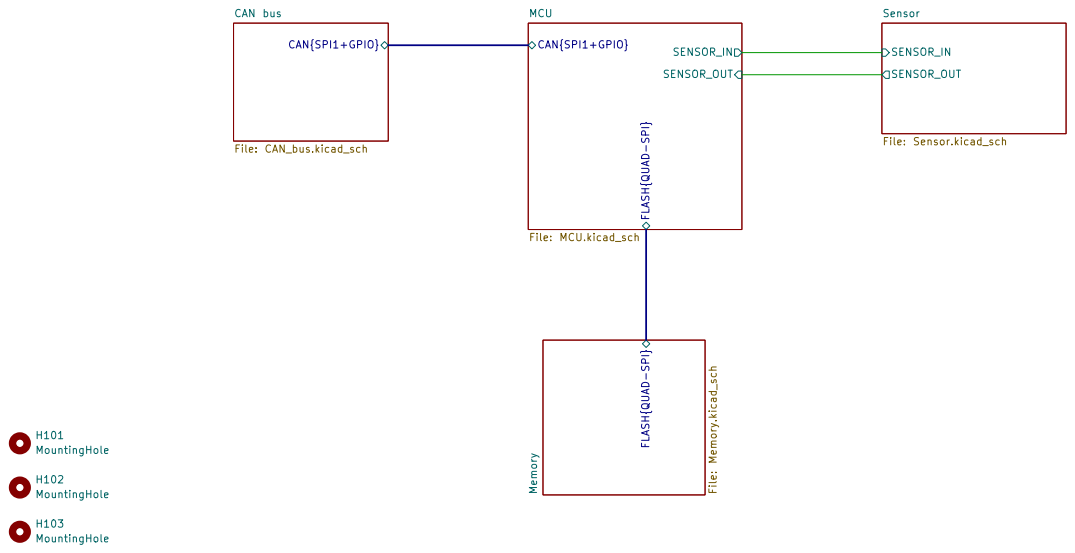
[picture p56: page 1]

File: MCU.kicad_sch H101 MountingHole H103 MountingHole H102 MountingHole

RnD Unit
rnd@icm-institute.org
ICM - Paris Brain Institute
Sheet: /
File: BB_nosepoke_V1.kicad_sch
Title: BB_nosepoke

Size: A4 | Rev: v1
KiCad E.D.A. 10.0.1 | Id: 1/5

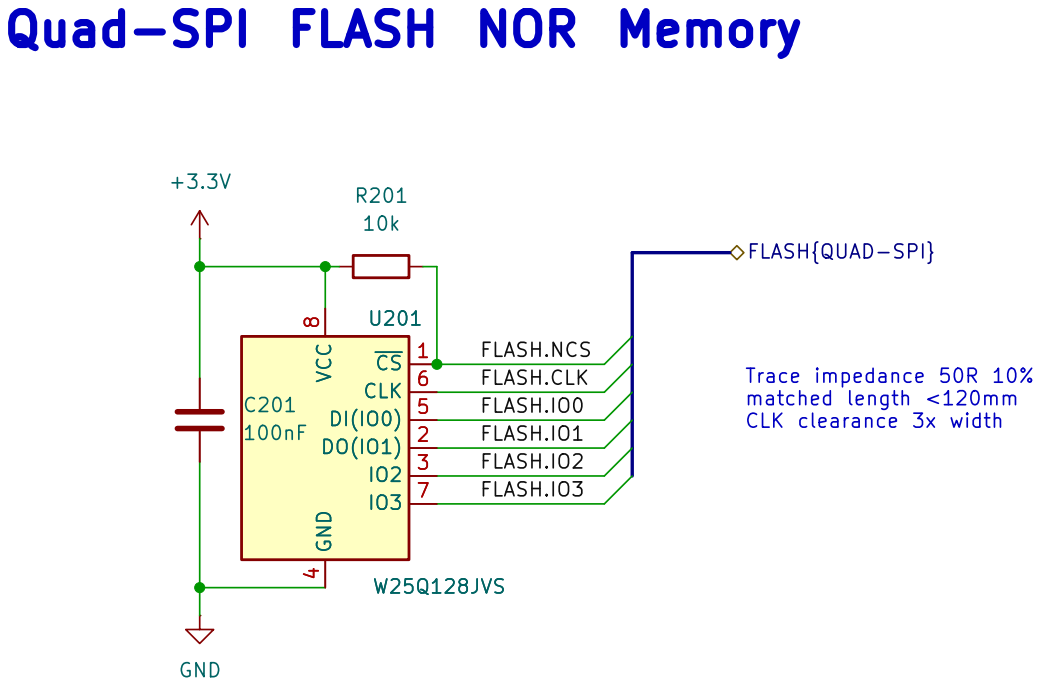
[picture p57: page 2]

CLK clearance 3x width Quad-SPI FLASH NOR Memory

FLASH{QUAD-SPI} FLASH.IO3

Trace impedance 50R 10% matched length <120mm

RnD Unit
rnd@icm-institute.org
ICM - Paris Brain Institute
Sheet: /Memory/
File: Memory.kicad_sch
Title: BB_nosepoke

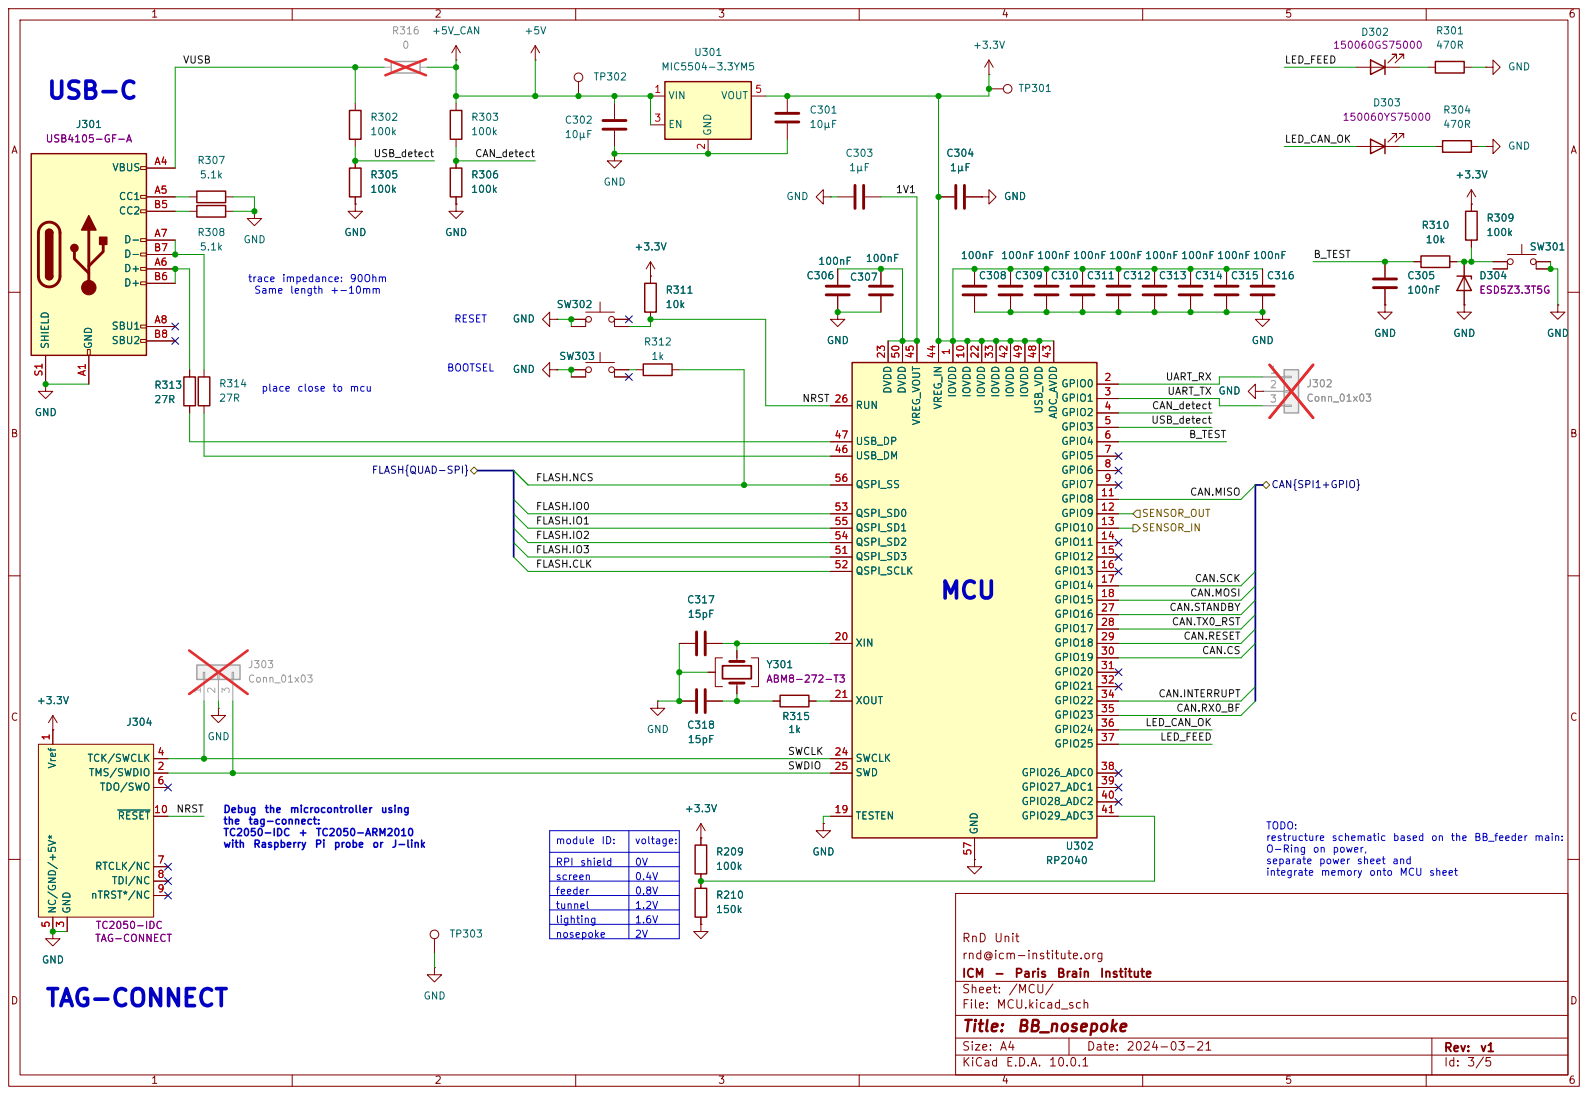
[picture p58: page 3]

place close to mcu

the tag-connect: TC2050-IDC + TC2050-ARM2010 with Raspberry Pi probe or J-link

TODO:
restructure schematic based on the BB_feeder main: O-Ring on power, separate power sheet and

screen | 0.4V
feeder | 0.8V

integrate memory onto MCU sheet

RnD Unit
rnd@icm-institute.org
ICM - Paris Brain Institute
Sheet: /MCU/
File: MCU.kicad_sch
Title: BB_nosepoke

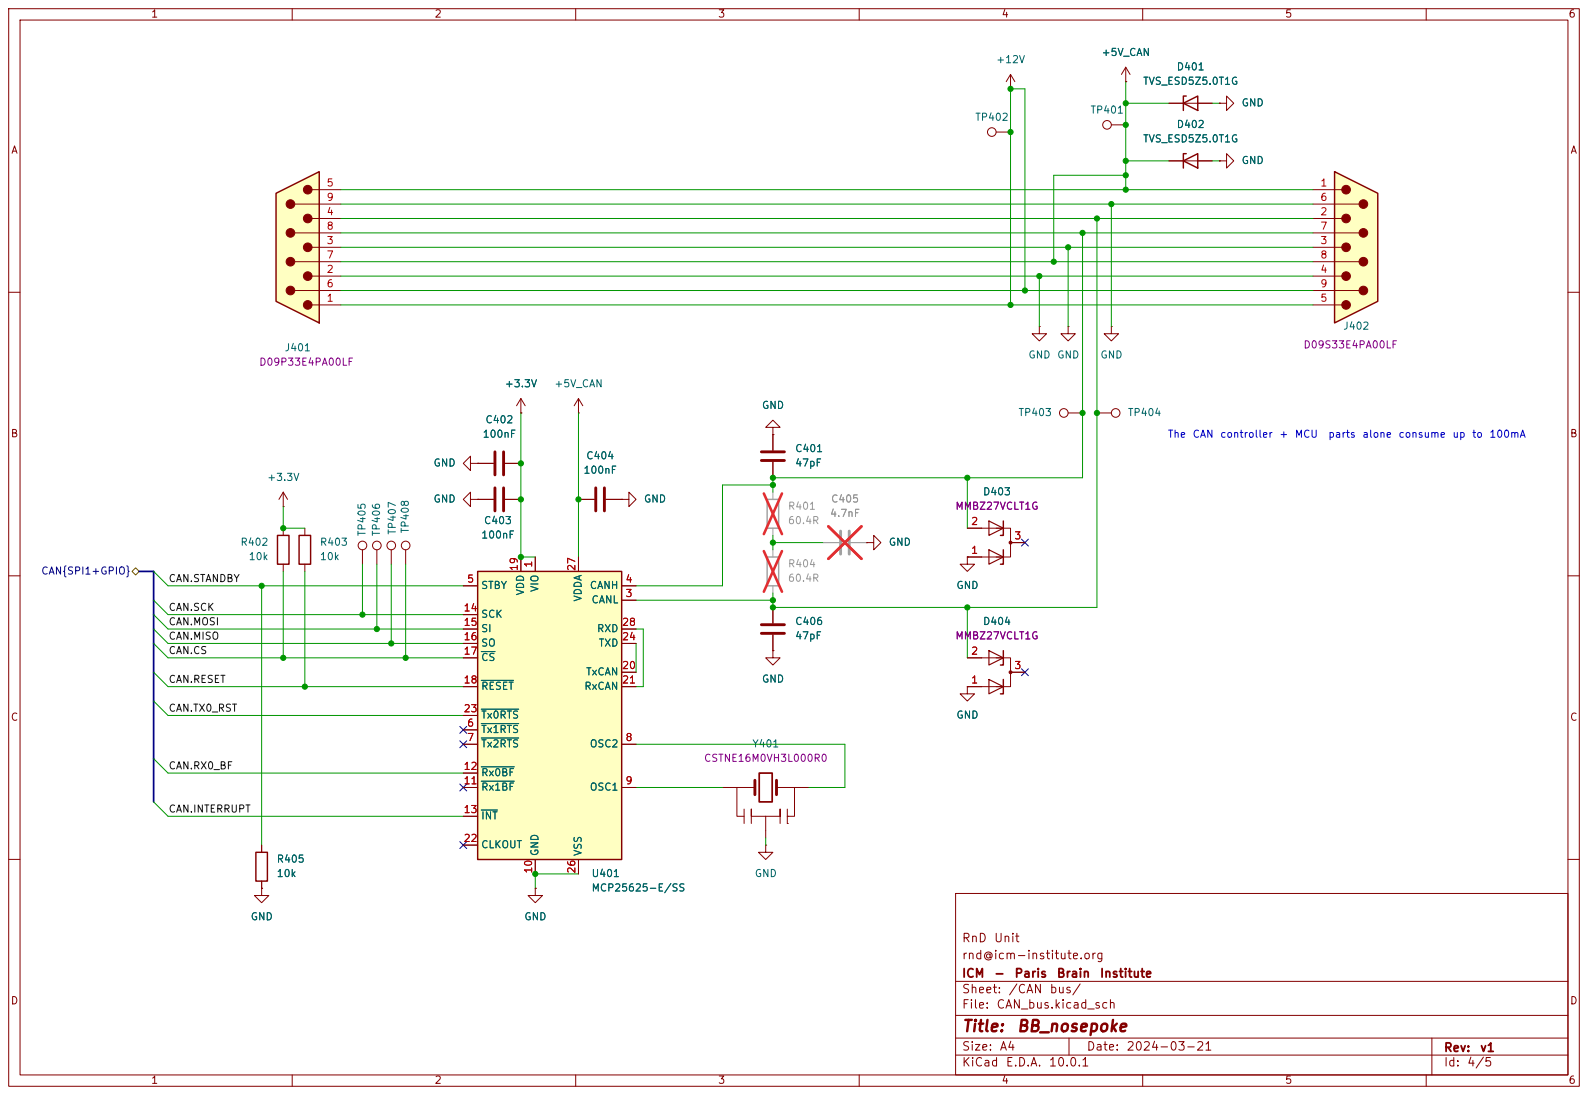
[picture p59: page 4]

The CAN controller + MCU parts alone consume up to 100mA +5V_CAN
3 D403 MMBZ27VCLT1G +12V

CAN.MOSI CAN.RX0_BF CAN.INTERRUPT CAN.RESET

CAN.CS CAN.TX0_RST CAN.STANDBY CAN.SCK

rnd@icm-institute.org
ICM - Paris Brain Institute
Sheet: /CAN bus/
File: CAN_bus.kicad_sch
Title: BB_nosepoke

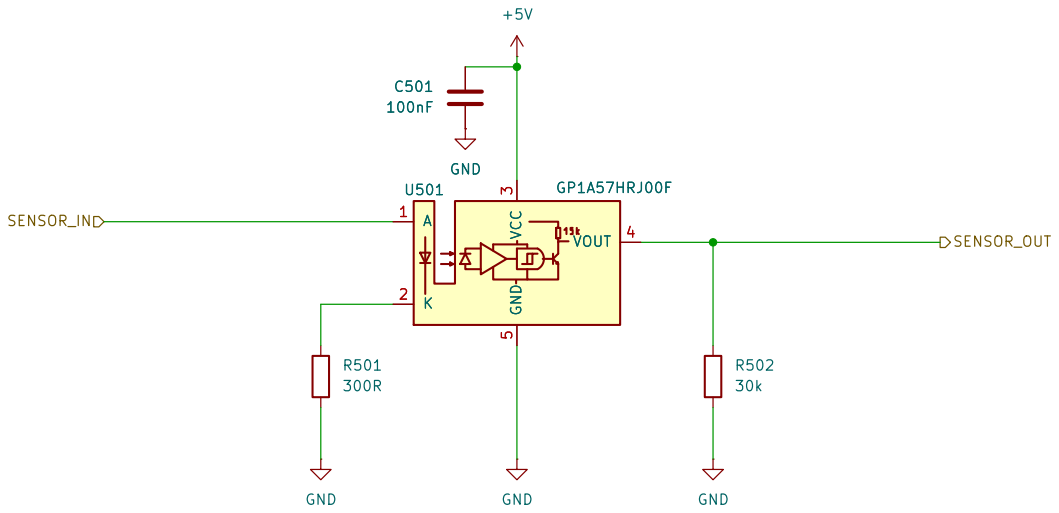
[picture p60: page 5]

RnD Unit
rnd@icm-institute.org
ICM - Paris Brain Institute
Sheet: /Sensor/
File: Sensor.kicad_sch
Title: BB_nosepoke
