Open-BeatBox/Open-BeatBox_Hardware/electronics/BB_screen_main_V1/BB_screen_main_V1.pdf

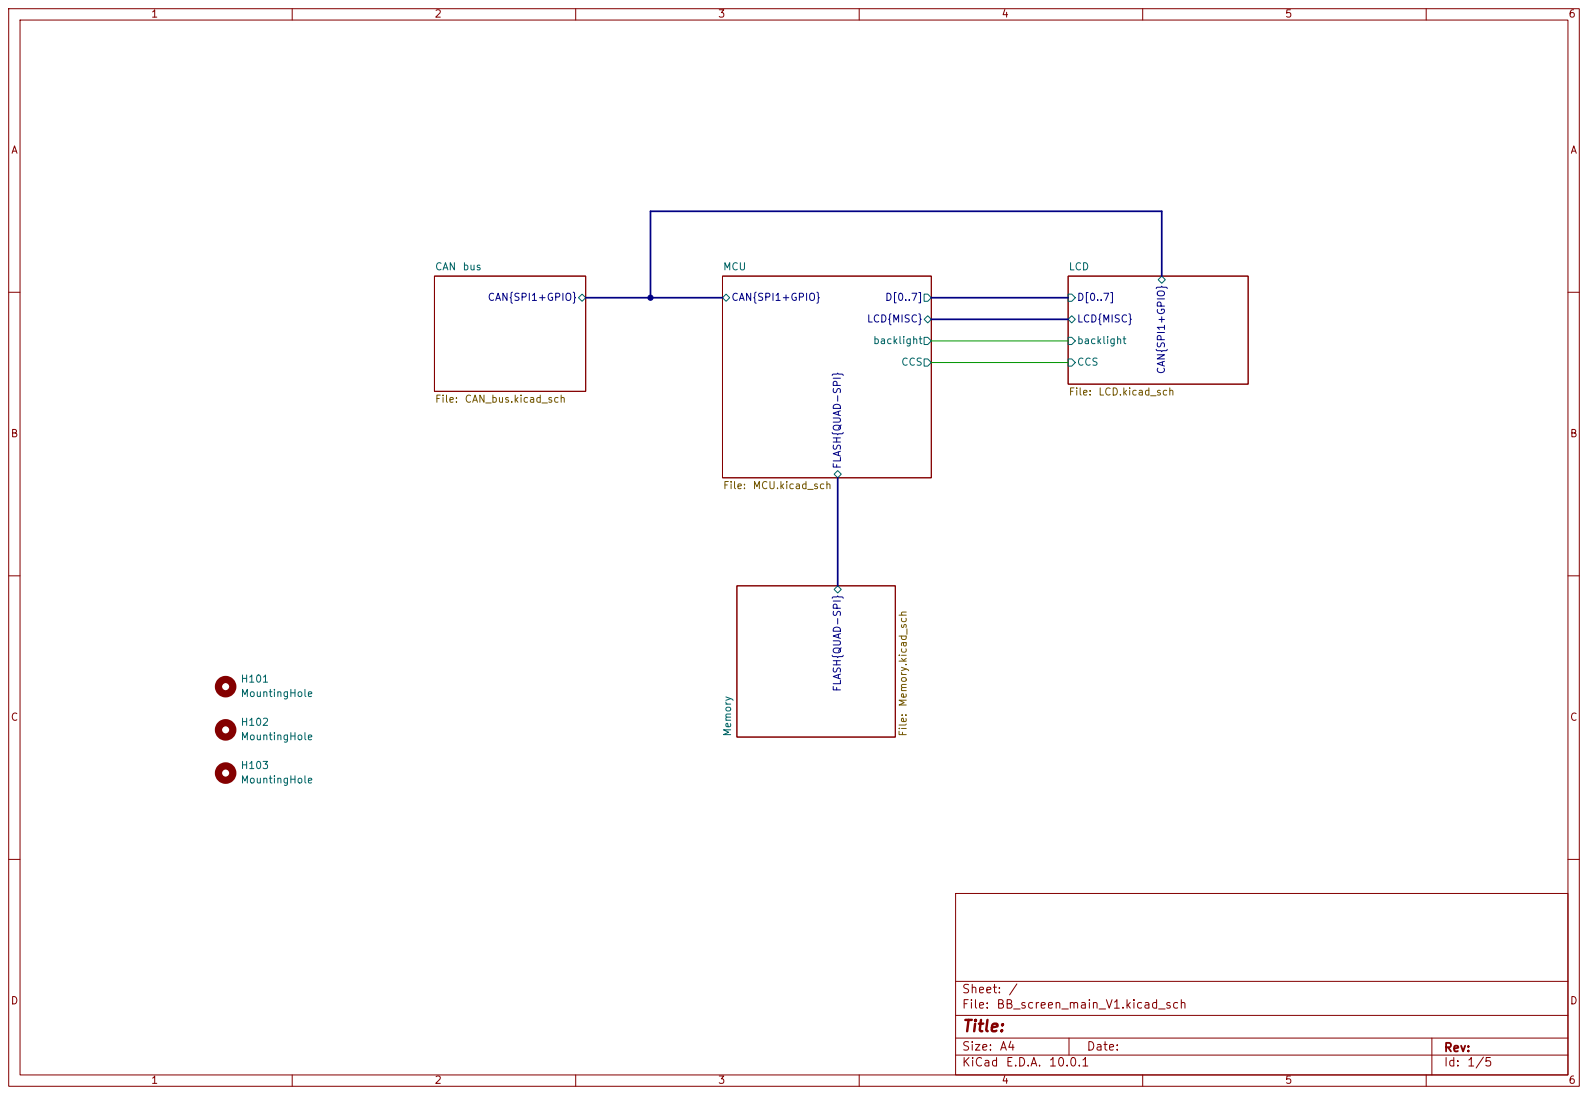
[picture p61: page 1]

CAN{SPI1+GPIO} CAN bus File: CAN_bus.kicad_sch H101 MountingHole H102 MountingHole H103 MountingHole

backlight CCS MCU
Sheet: / FLASH{QUAD-SPI}

Size: A4 | Rev:
KiCad E.D.A. 10.0.1 | Id: 1/5

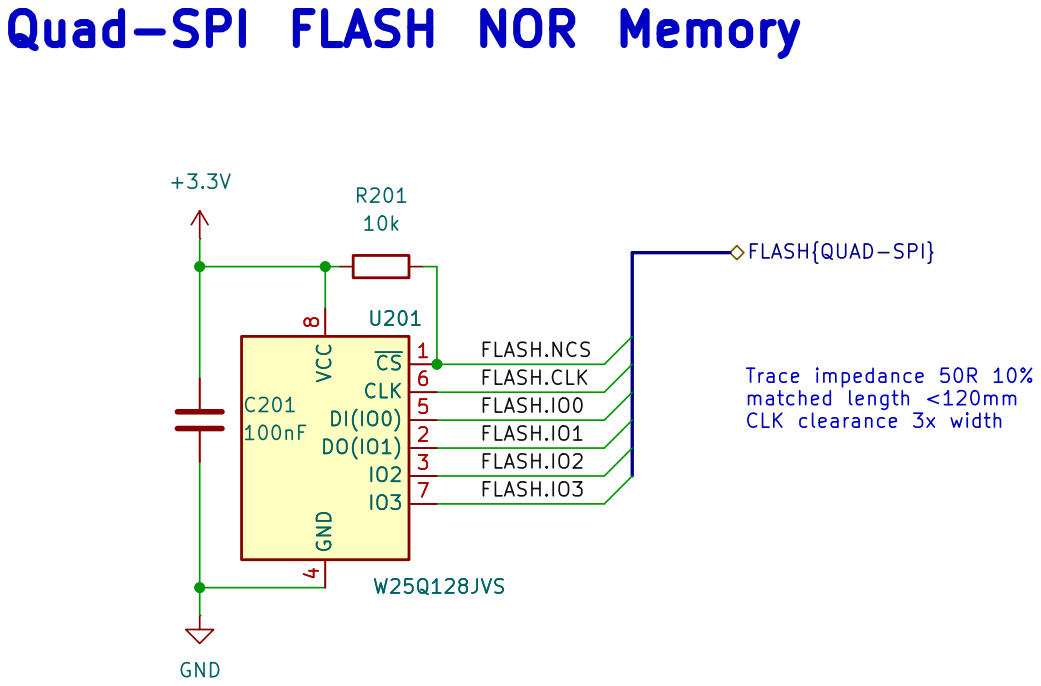
[picture p62: page 2]

CLK clearance 3x width Quad-SPI FLASH NOR Memory

Trace impedance 50R 10% matched length <120mm

RnD Unit
rnd@icm-institute.org
ICM - Paris Brain Institute
Sheet: /Memory/
File: Memory.kicad_sch
Title: BB_nosepoke

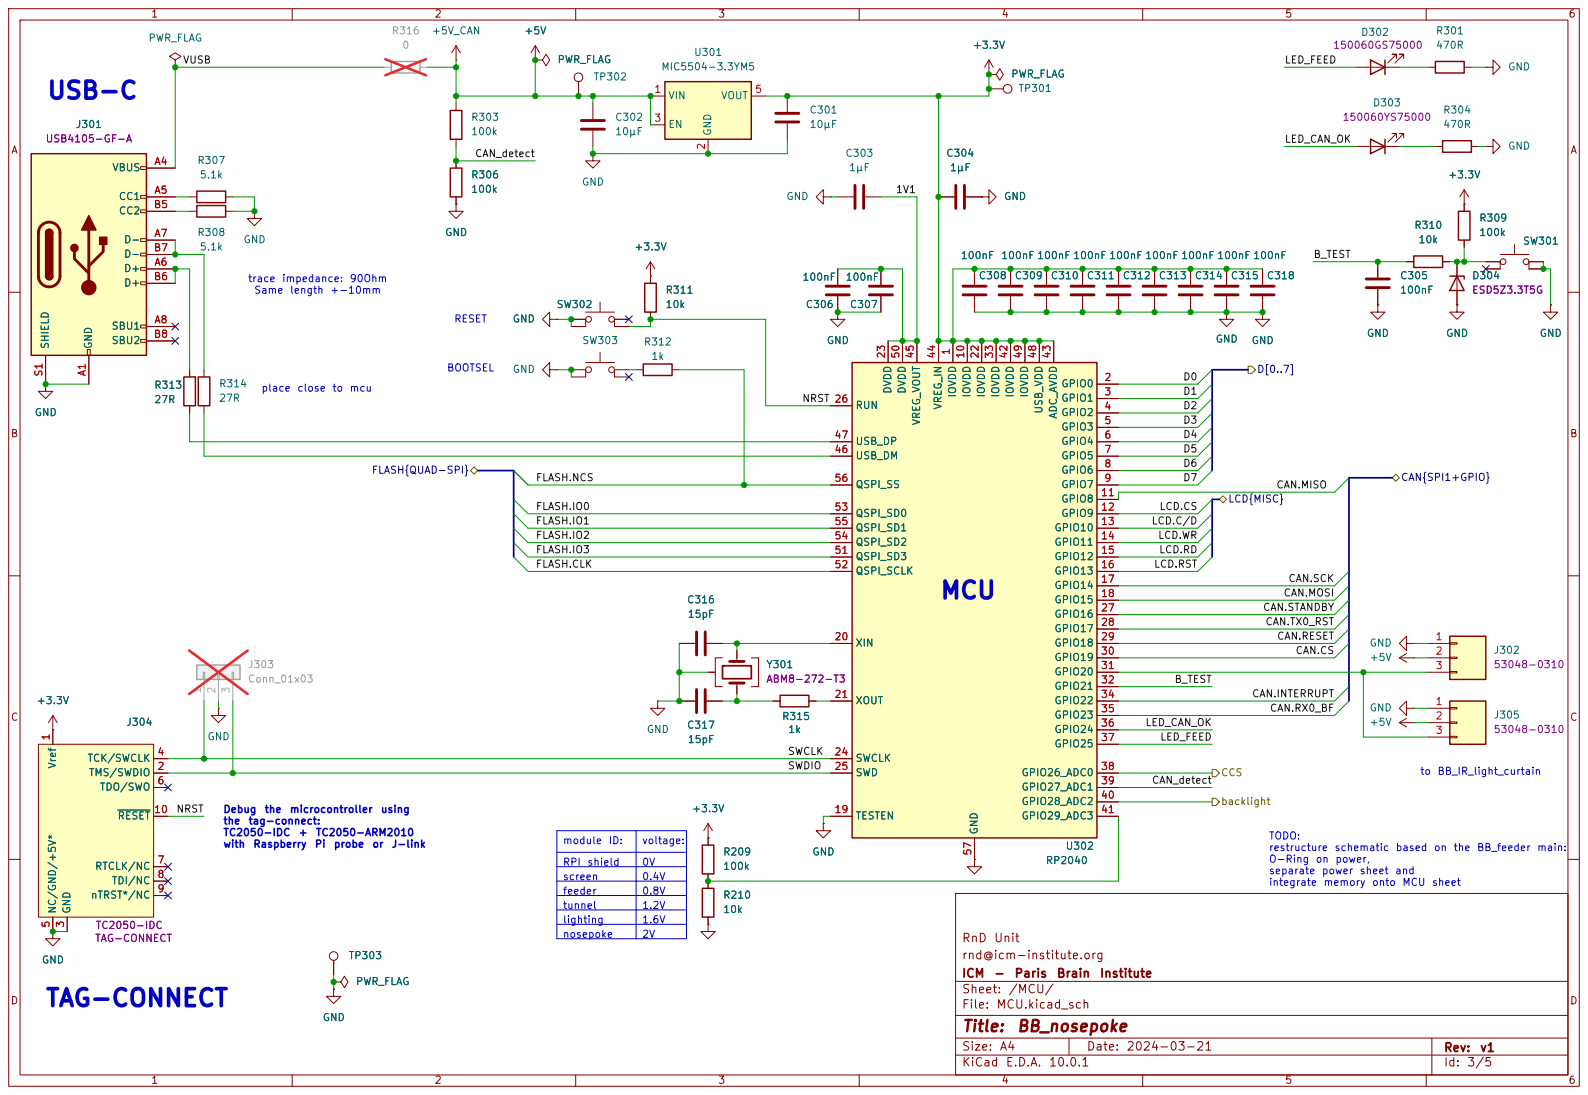
[picture p63: page 3]

CAN.TX0_RST CAN.STANDBY CAN.SCK

Debug the microcontroller using
the tag-connect: TC2050-IDC + TC2050-ARM2010 with Raspberry Pi probe or J-link

TODO:
restructure schematic based on the BB_feeder main: O-Ring on power, separate power sheet and

screen | 0.4V
feeder | 0.8V

integrate memory onto MCU sheet

rnd@icm-institute.org
ICM - Paris Brain Institute
Sheet: /MCU/
File: MCU.kicad_sch
Title: BB_nosepoke

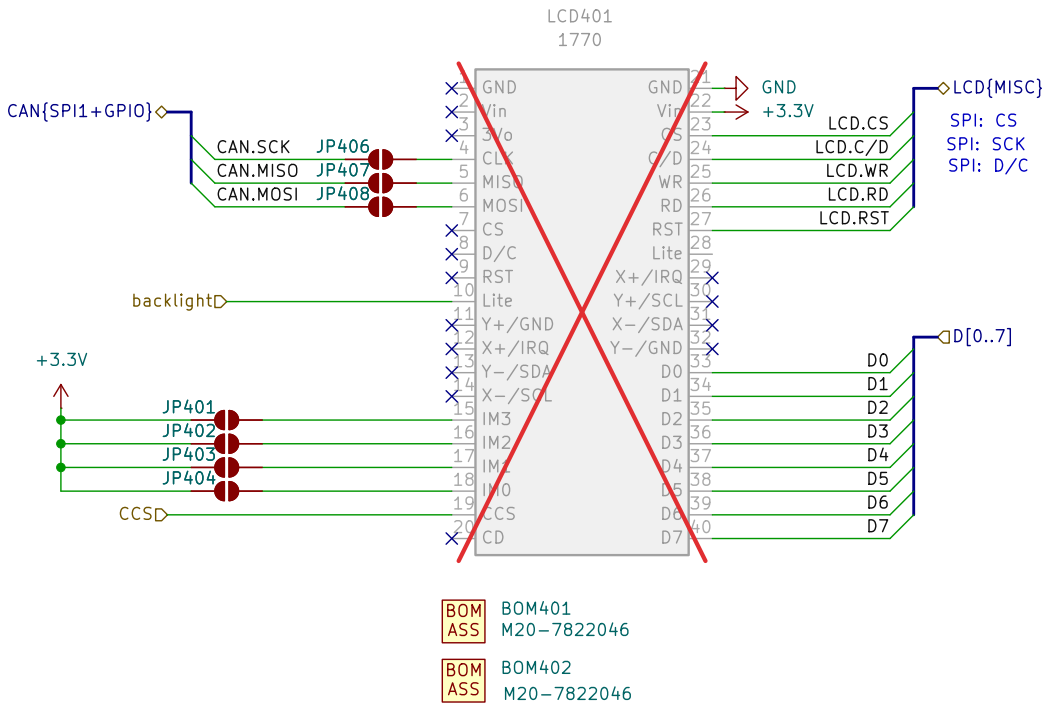
[picture p64: page 4]

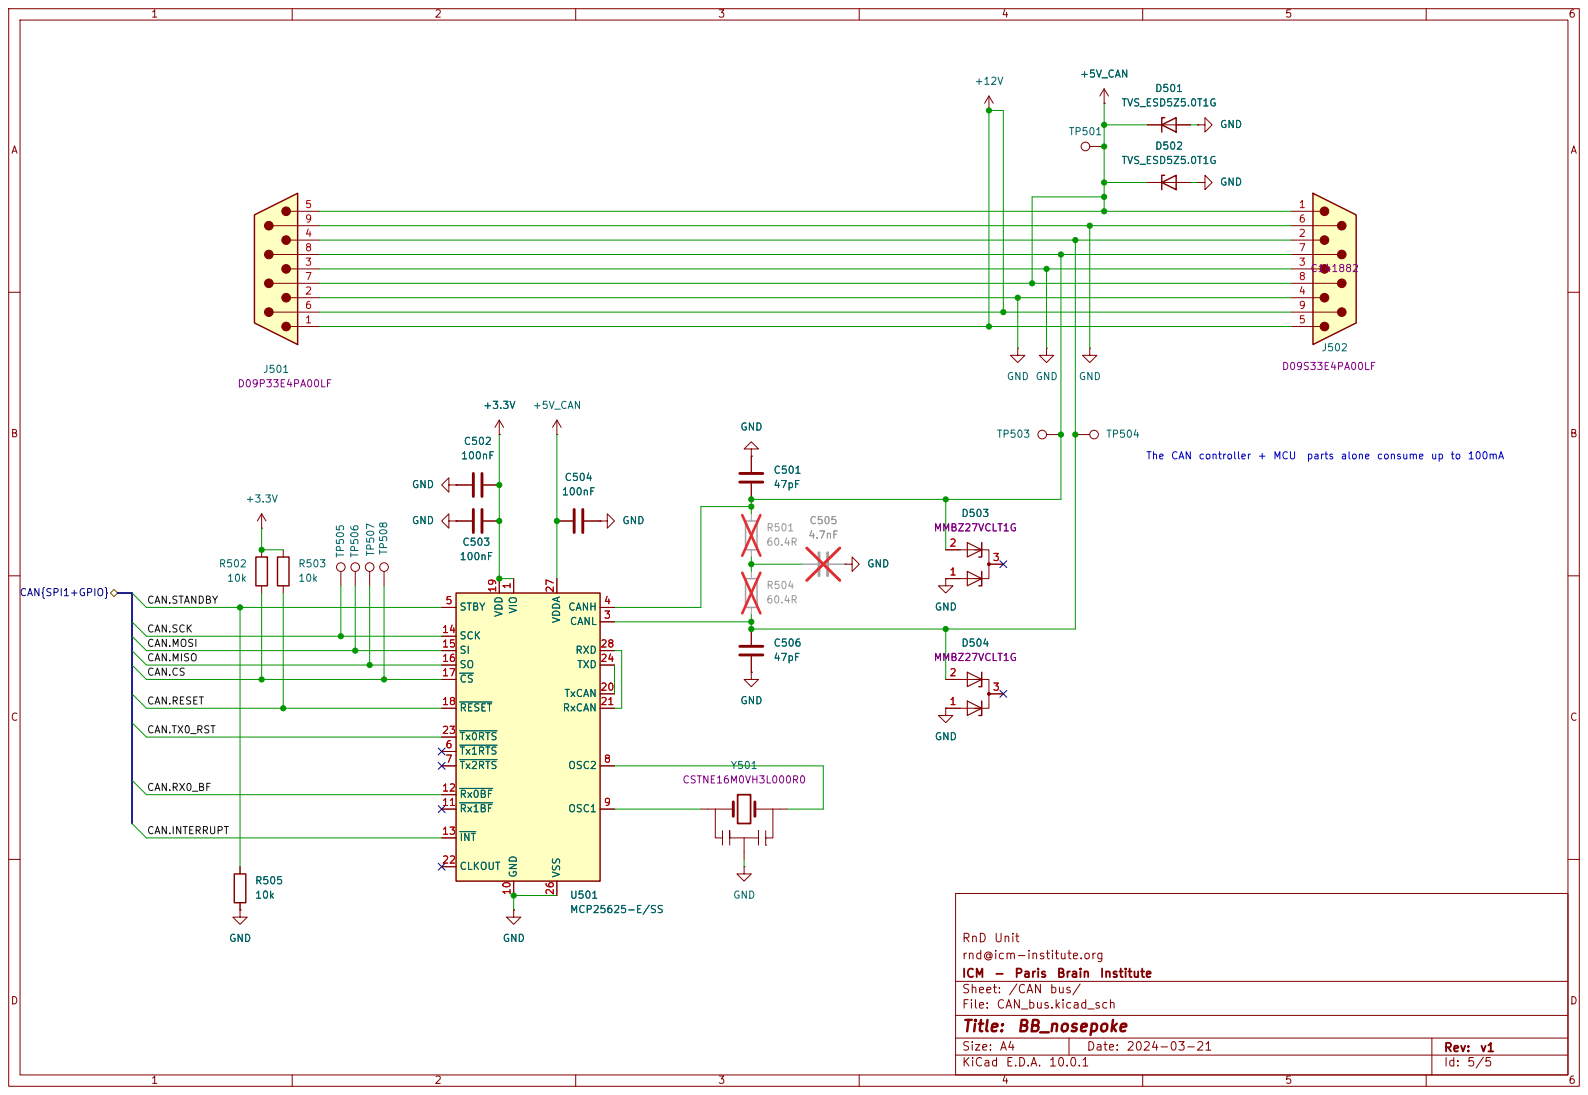
[picture p65: page 5]

The CAN controller + MCU parts alone consume up to 100mA D503 MMBZ27VCLT1G

CAN.MOSI CAN.CS CAN.MISO

rnd@icm-institute.org
ICM - Paris Brain Institute
Sheet: /CAN bus/
File: CAN_bus.kicad_sch
Title: BB_nosepoke
