Open-BeatBox/Open-BeatBox_Hardware/electronics/BB_tunnel_V1/BB_tunnel_V1.pdf

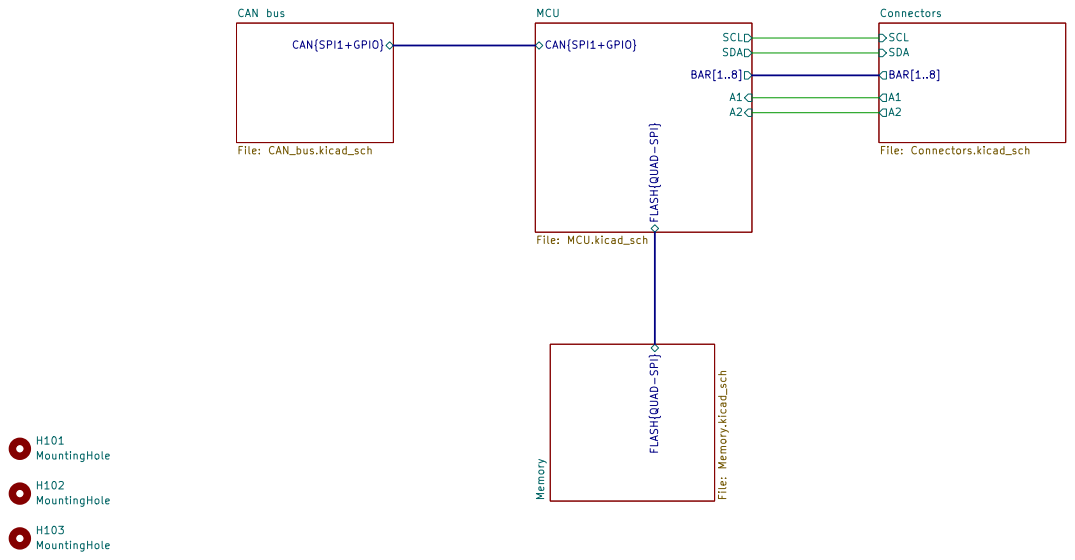
[picture p66: page 1]

CAN{SPI1+GPIO} CAN bus File: CAN_bus.kicad_sch H101 MountingHole H102 MountingHole H103 MountingHole

A2 MCU
RnD Unit FLASH{QUAD-SPI}

rnd@icm-institute.org
ICM - Paris Brain Institute
Sheet: /
File: BB_tunnel_V1.kicad_sch
Title: BB_tunnel

Size: A4 | Rev: v1
KiCad E.D.A. 10.0.1 | Id: 1/5


CLK clearance 3x width Quad-SPI FLASH NOR Memory

FLASH{QUAD-SPI} FLASH.IO3

Trace impedance 50R 10% matched length <120mm

RnD Unit
rnd@icm-institute.org
ICM - Paris Brain Institute
Sheet: /Memory/
File: Memory.kicad_sch
Title: BB_tunnel

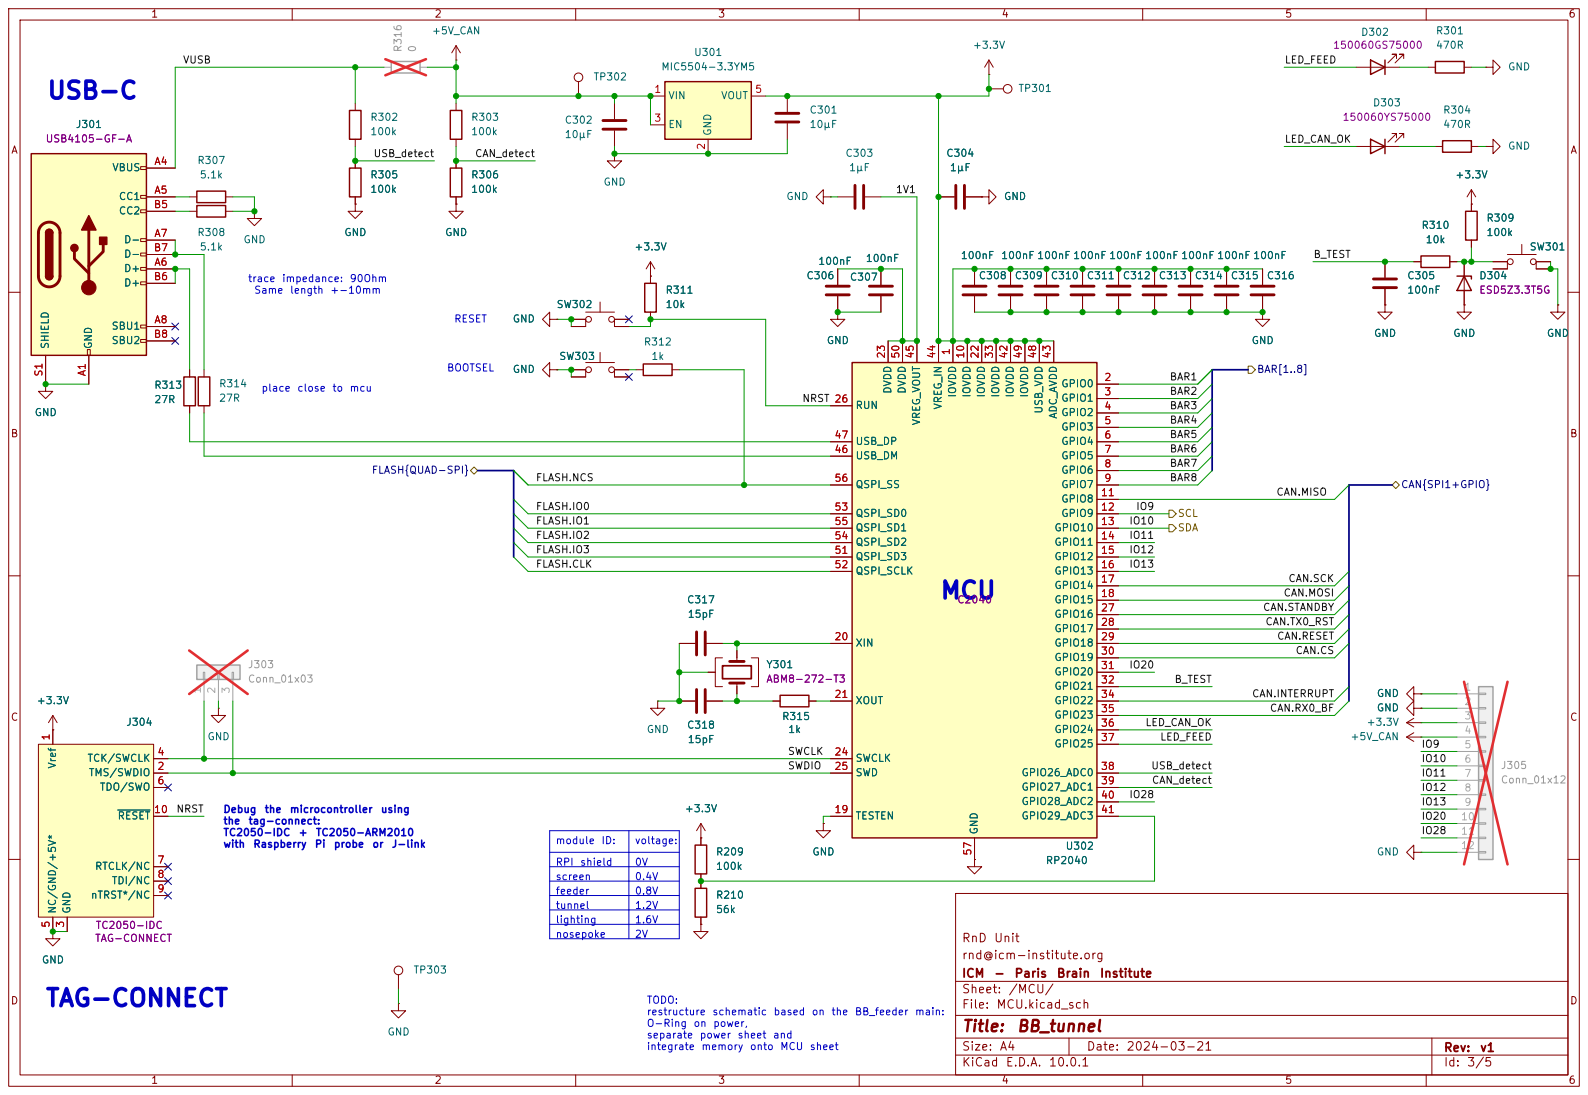
[picture p67: page 3]

integrate memory onto MCU sheet USB-C

place close to mcu

the tag-connect: TC2050-IDC + TC2050-ARM2010 with Raspberry Pi probe or J-link

screen | 0.4V
feeder | 0.8V

RnD Unit
rnd@icm-institute.org
ICM - Paris Brain Institute
Sheet: /MCU/
File: MCU.kicad_sch
Title: BB_tunnel

TODO:
restructure schematic based on the BB_feeder main: O-Ring on power, separate power sheet and

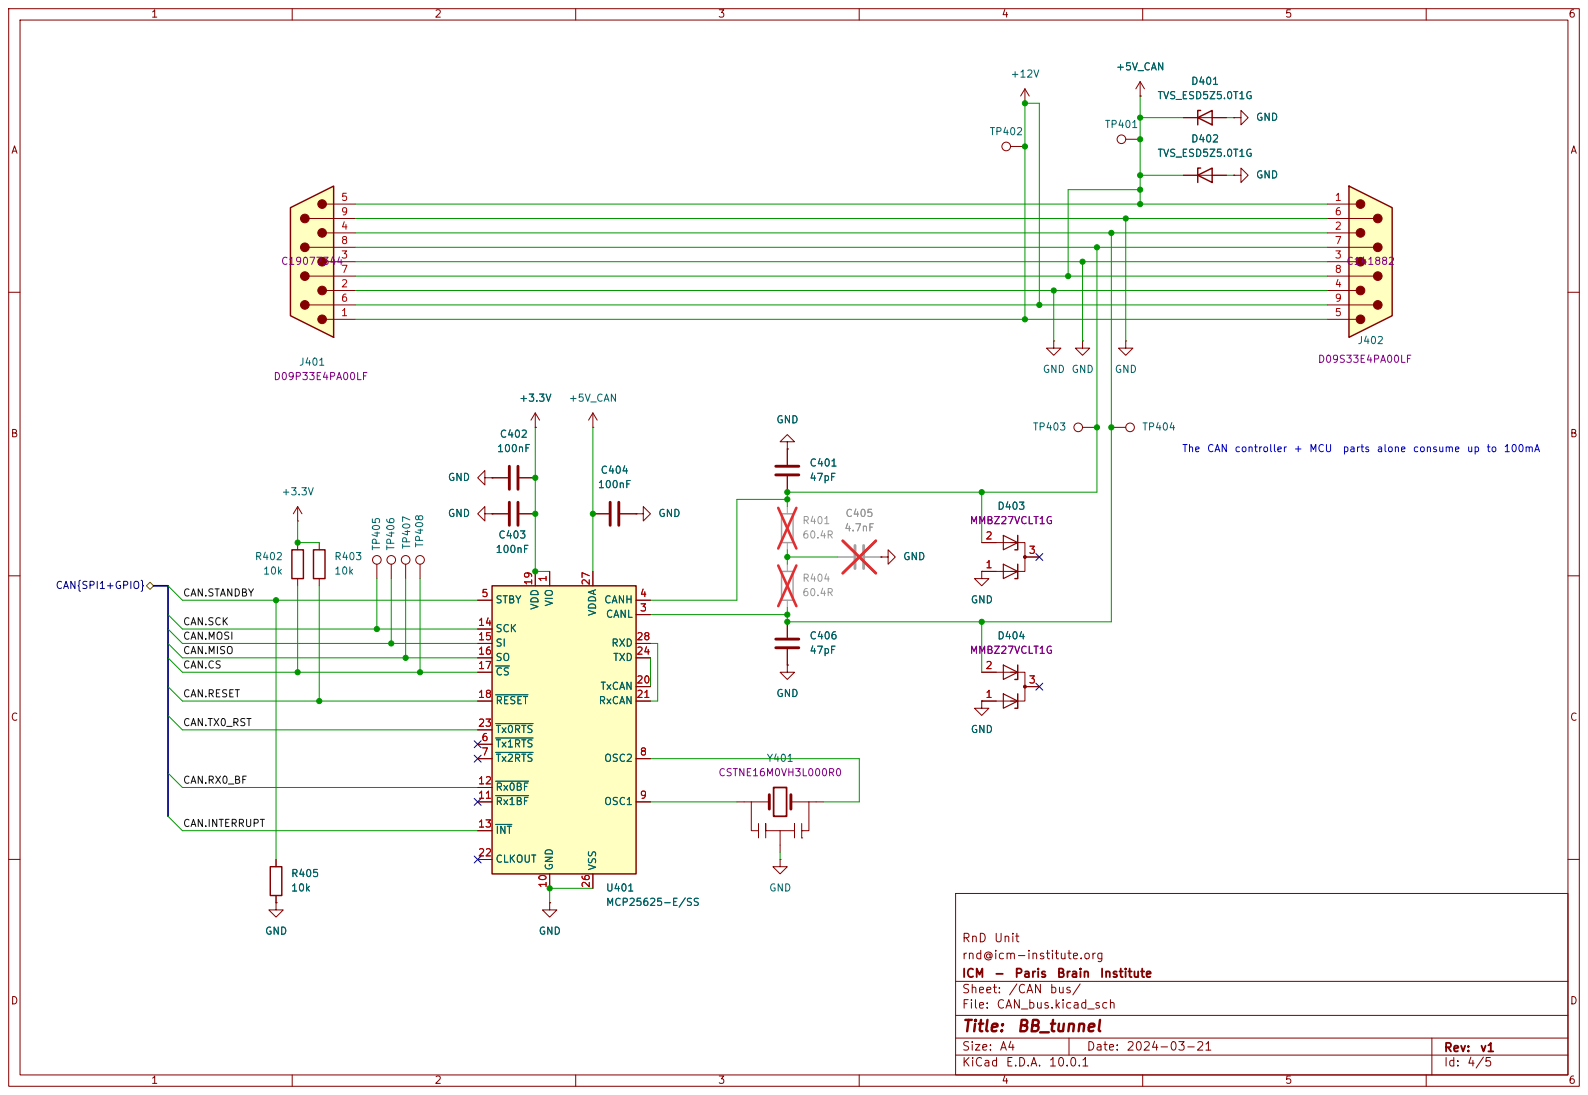
[picture p68: page 4]

CAN.INTERRUPT CAN.TX0_RST CAN.RESET CAN.CS CAN.MISO

rnd@icm-institute.org
ICM - Paris Brain Institute
Sheet: /CAN bus/
File: CAN_bus.kicad_sch
Title: BB_tunnel

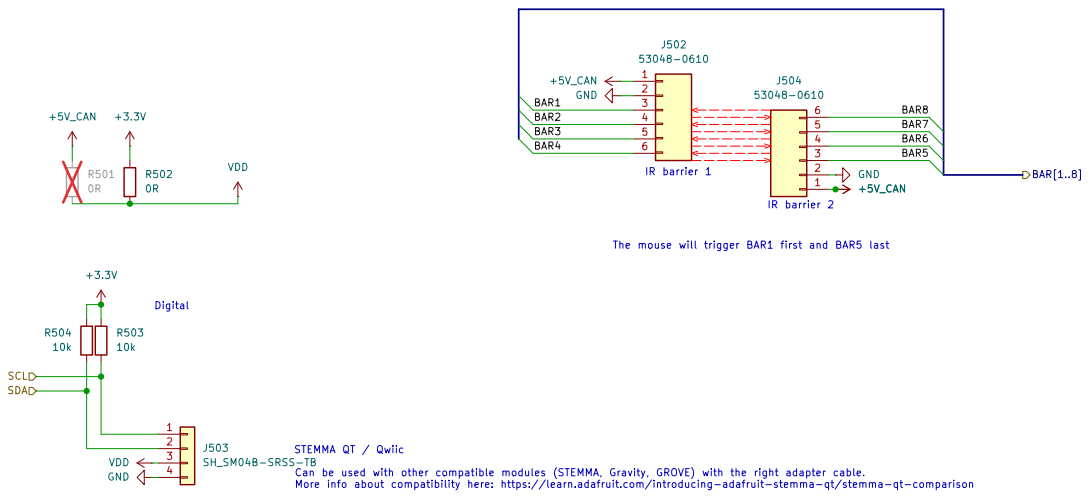
[picture p69: page 5]

IR barrier 1
The mouse will trigger BAR1 first and BAR5 last +5V_CAN

STEMMA QT / Qwiic Can be used with other compatible modules (STEMMA, Gravity, GROVE) with the right adapter cable. More info about compatibility here: https://learn.adafruit.com/introducing-adafruit-stemma-qt/stemma-qt-comparison

RnD Unit
rnd@icm-institute.org
ICM - Paris Brain Institute
Sheet: /Connectors/
File: Connectors.kicad_sch
Title: BB_tunnel
