Open-BeatBox/Open-BeatBox_Hardware/electronics/BB_lighting_V1/BB_lighting_V1.kicad_pcb

## KiCad design electronics/BB_lighting_V1/BB_lighting_V1.kicad_pcb (2026-11-03)

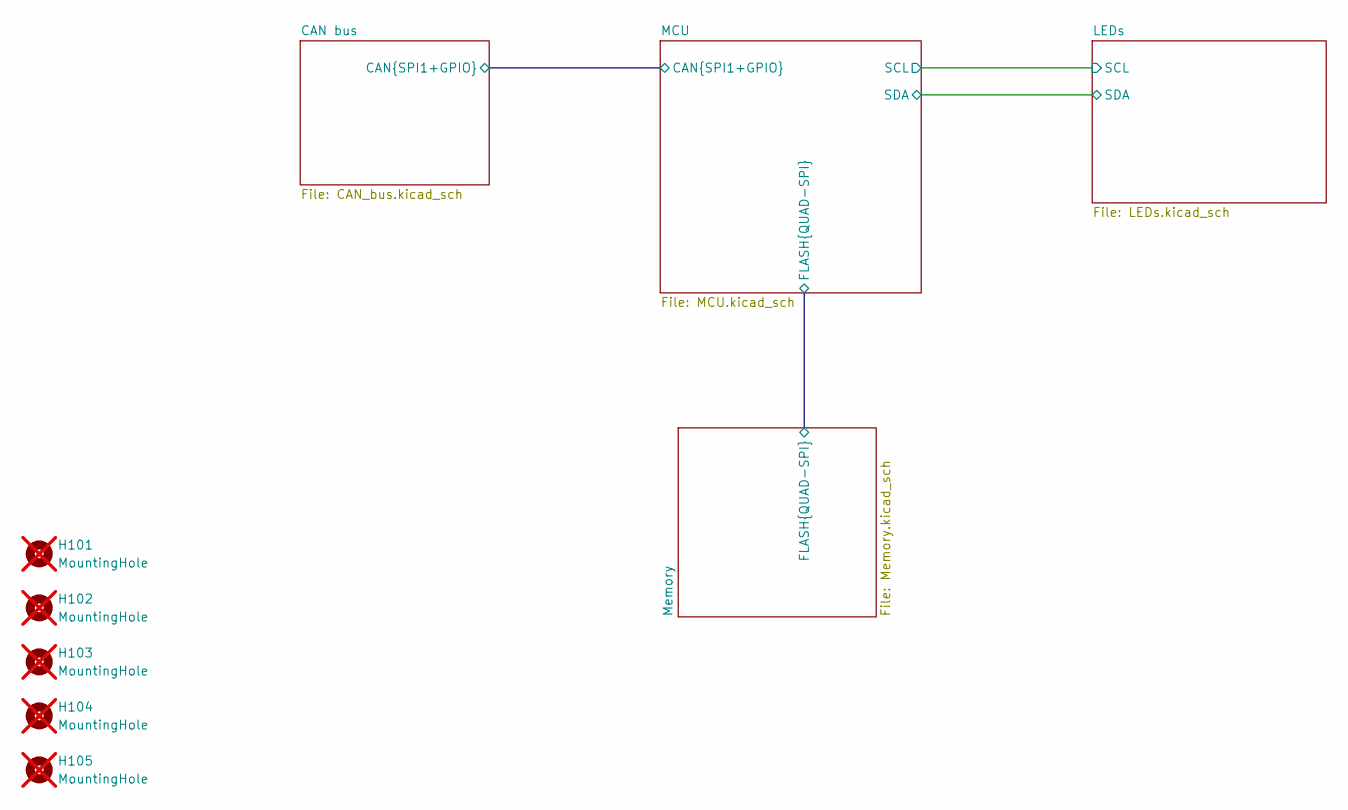
[picture p70: schematic BB_lighting_V1.kicad_sch, BB_lighting]

Parts:
H101, H102, H103, H104, H105: MountingHole; not fitted

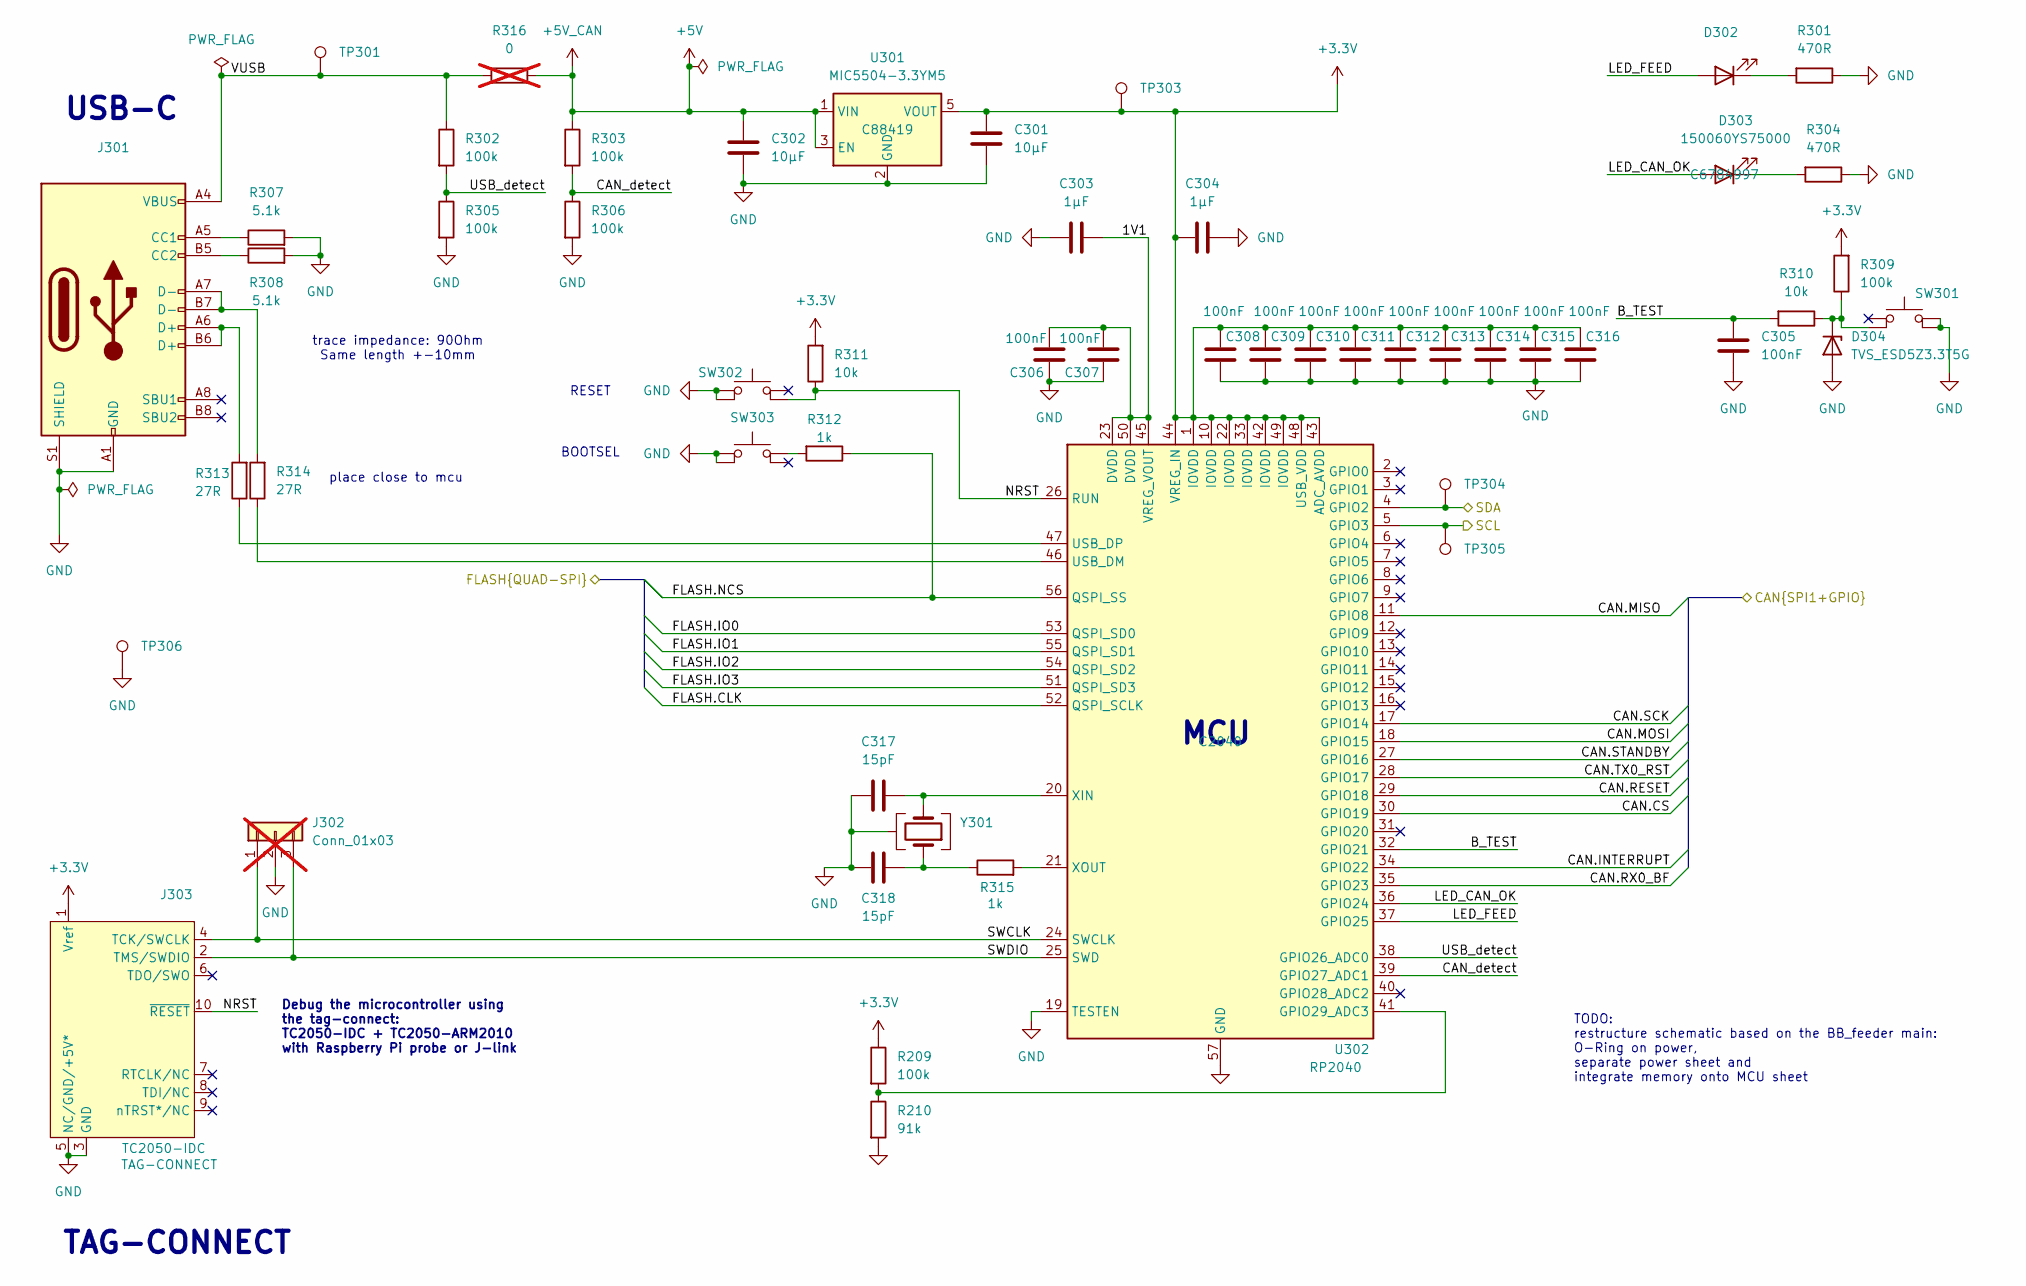
[picture p71: schematic MCU.kicad_sch, BB_lighting]

Parts:
C301, C302: 10µF; C_0603_1608Metric
C303, C304: 1µF; C_0603_1608Metric
C305, C306, C307, C308, C309, C310, C311, C312, C313, C314, C315, C316: 100nF; C_0603_1608Metric
C317, C318: 15pF; C_0603_1608Metric
D302: LED_150060GS75000; LED_0603_1608Metric; MPN 150060GS75000; JLCPCB Part C5252984
D303: LED_150060YS75000; LED_0603_1608Metric; MPN 150060YS75000; JLCPCB Part C6784997
D304: TVS_ESD5Z3.3T5G; D_SOD-523; MPN ESD5Z3.3T5G; JLCPCB Part C22440024
J301: Conn_USB-C_USB4105-GF-A; Conn_USB_C_Receptacle_GCT_USB4105-xx-A_16P_TopMnt_Horizontal; MPN USB4105-GF-A; JLCPCB Part C393939
J302: Conn_01x03; not fitted
J303: Conn_TagConnect_TC2050-IDC; Tag-Connect_TC2050-IDC-FP_2x05_P1.27mm_Vertical; MPN TC2050-IDC
R209, R302, R303, R305, R306, R309: 100k; R_0603_1608Metric
R210: 91k; R_0603_1608Metric
R301, R304: 470R; R_0603_1608Metric
R307, R308: 5.1k; R_0603_1608Metric
R310, R311: 10k; R_0603_1608Metric
R312, R315: 1k; R_0603_1608Metric
R313, R314: 27R; R_0603_1608Metric
R316: 0; R_0603_1608Metric; not fitted
SW301, SW302, SW303: SW_TL3305AF160QG; SW_Push_TL3305; MPN TL3305AF160QG; JLCPCB Part C18078070
TP301, TP303, TP306: TestPoint; TestPoint_THTPad_D2.0mm_Drill1.0mm
TP304, TP305: TestPoint_SMD; TestPoint_Pad_D1.0mm
U301: MIC5504-3.3YM5; SOT-23-5; MPN MIC5504-3.3YM5; JLCPCB Part C88419
U302: RP2040; QFN-56-1EP_7x7mm_P0.4mm_EP3.2x3.2mm; MPN RP2040; JLCPCB Part C2040
Y301: Crystal_ABM8-272-T3; Crystal_SMD_Abracon_ABM8; MPN ABM8-272-T3; JLCPCB Part C20625731

Connections:
+3.3V: C301.1, C304.1, C308.1, C309.1, C310.1, C311.1, C312.1, C313.1, C314.1, C315.1, C316.1, J303.1 (Vref), R209.1, R309.2, R311.2, TP303.1 (1_1), U301.5 (VOUT), U302.1 (IOVDD), U302.10 (IOVDD), U302.22 (IOVDD), U302.33 (IOVDD), U302.42 (IOVDD), U302.43 (ADC_AVDD), U302.44 (VREG_IN), U302.48 (USB_VDD), U302.49 (IOVDD); also elsewhere on the board
+5V: C302.1, R303.1, R316.2, U301.1 (VIN), U301.3 (EN); also elsewhere on the board
/CAN bus/CAN.CS: U302.30 (GPIO19); also elsewhere on the board
/CAN bus/CAN.INTERRUPT: U302.34 (GPIO22); also elsewhere on the board
/CAN bus/CAN.MISO: U302.11 (GPIO8); also elsewhere on the board
/CAN bus/CAN.MOSI: U302.18 (GPIO15); also elsewhere on the board
/CAN bus/CAN.RESET: U302.29 (GPIO18); also elsewhere on the board
/CAN bus/CAN.RX0_BF: U302.35 (GPIO23); also elsewhere on the board
/CAN bus/CAN.SCK: U302.17 (GPIO14); also elsewhere on the board
/CAN bus/CAN.STANDBY: U302.27 (GPIO16); also elsewhere on the board
/CAN bus/CAN.TX0_RST: U302.28 (GPIO17); also elsewhere on the board
/LEDs/SCL: TP305.1 (1_1), U302.5 (GPIO3); also elsewhere on the board
/LEDs/SDA: TP304.1 (1_1), U302.4 (GPIO2); also elsewhere on the board
/MCU/1V1: C303.2, C306.2, C307.1, U302.23 (DVDD), U302.45 (VREG_VOUT), U302.50 (DVDD)
/MCU/B_TEST: C305.1, R310.2, U302.32 (GPIO21)
/MCU/CAN_detect: R303.2, R306.1, U302.39 (GPIO27_ADC1)
/MCU/FLASH.CLK: U302.52 (QSPI_SCLK); also elsewhere on the board
/MCU/FLASH.IO0: U302.53 (QSPI_SD0); also elsewhere on the board
/MCU/FLASH.IO1: U302.55 (QSPI_SD1); also elsewhere on the board
/MCU/FLASH.IO2: U302.54 (QSPI_SD2); also elsewhere on the board
/MCU/FLASH.IO3: U302.51 (QSPI_SD3); also elsewhere on the board
/MCU/FLASH.NCS: R312.1, U302.56 (QSPI_SS); also elsewhere on the board
/MCU/LED_CAN_OK: D303.2 (A), U302.36 (GPIO24)
/MCU/LED_FEED: D302.2 (A), U302.37 (GPIO25)
/MCU/NRST: J303.10 (~RESET), R311.1, SW302.2, U302.26 (RUN)
/MCU/SWCLK: J302.1, J303.4 (TCK/SWCLK), U302.24 (SWCLK)
/MCU/SWDIO: J302.3, J303.2 (TMS/SWDIO), U302.25 (SWD)
/MCU/USB_detect: R302.2, R305.1, U302.38 (GPIO26_ADC0)
/MCU/VUSB: J301.A4 (VBUS), J301.A9 (VBUS), J301.B4 (VBUS), J301.B9 (VBUS), R302.1, R316.1, TP301.1 (1_1)
GND: C301.2, C302.2, C303.1, C304.2, C305.2, C306.1, C307.2, C308.2, C309.2, C310.2, C311.2, C312.2, C313.2, C314.2, C315.2, C316.2, C317.1, C318.1, D304.2 (A), J301.A1 (GND), J301.A12 (GND), J301.B1 (GND), J301.B12 (GND), J301.S1 (SHIELD), J302.2, J303.3 (GND), J303.5 (NC/GND/+5V*), R210.2, R301.1, R304.1, R305.2, R306.2, R307.2, R308.2, SW301.1, SW301.2, SW302.3, SW302.4, SW303.1, SW303.2, TP306.1 (1_1), U301.2 (GND), U302.19 (TESTEN), U302.57 (GND), Y301.2, Y301.4; also elsewhere on the board
unnamed: C318.2, R315.1, Y301.1
unnamed: D302.1 (K), R301.2
unnamed: D303.1 (K), R304.2
unnamed: D304.1 (K), R309.1, R310.1, SW301.4
unnamed: J301.A5 (CC1), R307.1
unnamed: J301.B5 (CC2), R308.1
unnamed: J301.A6 (D+), J301.B6 (D+), R313.2
unnamed: J301.A7 (D-), J301.B7 (D-), R314.2
unnamed: R312.2, SW303.3
unnamed: R209.2, R210.1, U302.41 (GPIO29_ADC3)
unnamed: R314.1, U302.46 (USB_DM)
unnamed: R313.1, U302.47 (USB_DP)
unnamed: C317.2, U302.20 (XIN), Y301.3
unnamed: R315.2, U302.21 (XOUT)

Notes on the sheet:
trace impedance: 90Ohm Same length +-10mm
TODO: restructure schematic based on the BB_feeder main: O-Ring on power, separate power sheet and integrate memory onto MCU sheet
TAG-CONNECT
MCU
place close to mcu
BOOTSEL
Debug the microcontroller using the tag-connect: TC2050-IDC + TC2050-ARM2010 with Raspberry Pi probe or J-link
RESET
USB-C

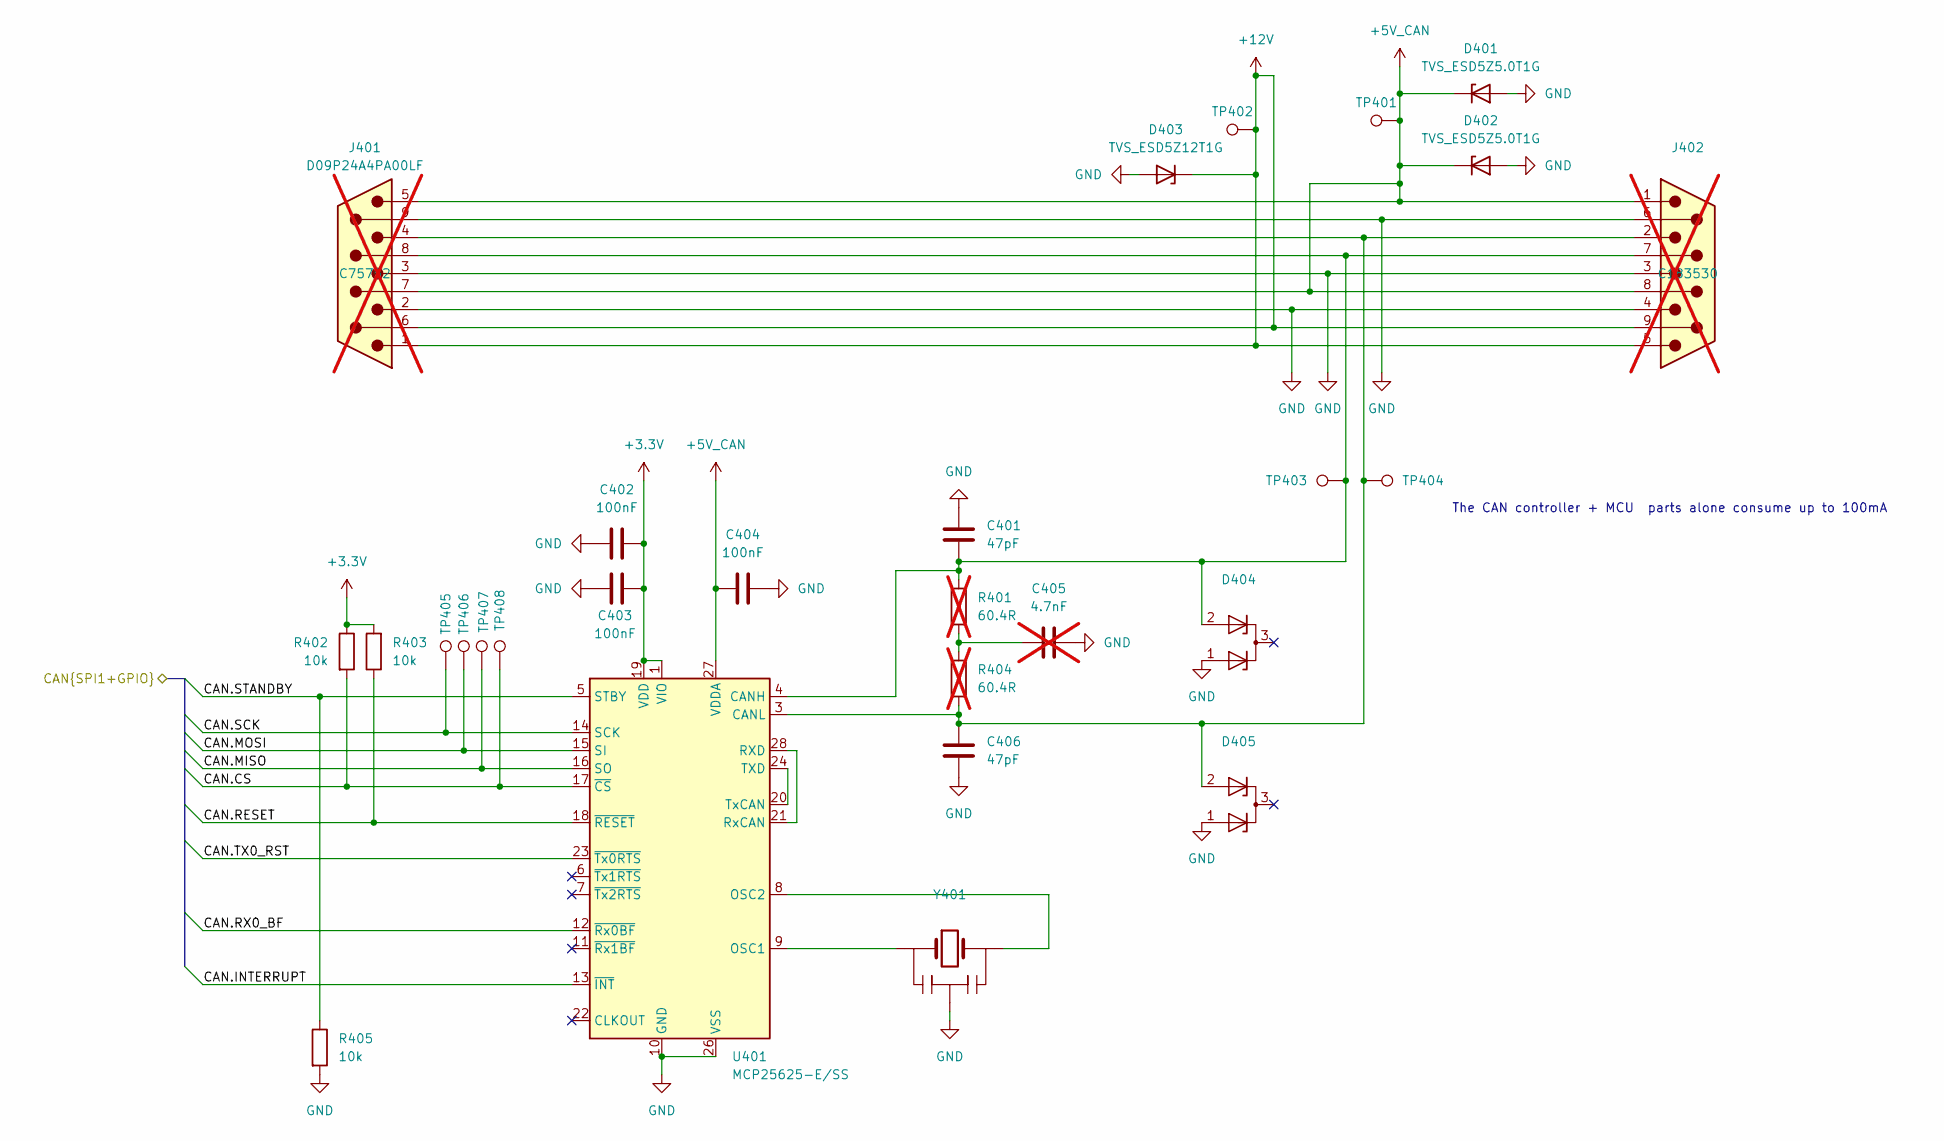
[picture p72: schematic CAN_bus.kicad_sch, BB_lighting]

Parts:
C401, C406: 47pF; C_0603_1608Metric
C402, C403, C404: 100nF; C_0603_1608Metric
C405: 4.7nF; C_0603_1608Metric; not fitted
D401, D402: TVS_ESD5Z5.0T1G; D_SOD-523; MPN ESD5Z5.0T1G; JLCPCB Part C343989
D403: TVS_ESD5Z12T1G; D_SOD-523; MPN ESD5Z12T1G
D404, D405: MMBZ27VCLT1G; SOT-23; MPN MMBZ27VCLT1G; JLCPCB Part C128609
J401: Conn-DB9_D09P24A4PA00LF; Conn_DB9_D09P24A4PA00LF; MPN D09P24A4PA00LF; JLCPCB Part C75752; not fitted
J402: Conn-DB9_D09S24A4PA00LF; Conn_DB9_D09S24A4PA00LF; MPN D09S24A4PA00LF; JLCPCB Part C183530; not fitted
R401, R404: 60.4R; R_0603_1608Metric; not fitted
R402, R403, R405: 10k; R_0603_1608Metric
TP401, TP402: TestPoint; TestPoint_THTPad_D2.0mm_Drill1.0mm
TP403, TP404, TP405, TP406, TP407, TP408: TestPoint_SMD; TestPoint_Pad_D1.0mm
U401: MCP25625-E/SS; SSOP-28_5.3x10.2mm_P0.65mm; MPN MCP25625-E/SS; JLCPCB Part C184944
Y401: CSTNE16M0VH3L000R0; Resonator_SMD_Murata_CSTxExxV-3Pin_3.0x1.1mm; MPN CSTNE16M0VH3L000R0; JLCPCB Part C1870467

Connections:
+3.3V: C402.2, C403.2, R402.1, R403.2, U401.1 (VIO), U401.19 (VDD); also elsewhere on the board
+5V: C404.1, D401.1 (K), D402.1 (K), J401.5, J401.7, J402.1, J402.8, TP401.1 (1_1), U401.27 (VDDA); also elsewhere on the board
+12V: D403.1 (K), J401.1, J401.6, J402.5, J402.9, TP402.1 (1_1); also elsewhere on the board
/CAN bus/CAN.CS: R402.2, TP408.1 (1_1), U401.17 (~CS); also elsewhere on the board
/CAN bus/CAN.INTERRUPT: U401.13 (~INT); also elsewhere on the board
/CAN bus/CAN.MISO: TP407.1 (1_1), U401.16 (SO); also elsewhere on the board
/CAN bus/CAN.MOSI: TP406.1 (1_1), U401.15 (SI); also elsewhere on the board
/CAN bus/CAN.RESET: R403.1, U401.18 (~RESET); also elsewhere on the board
/CAN bus/CAN.RX0_BF: U401.12 (~Rx0BF); also elsewhere on the board
/CAN bus/CAN.SCK: TP405.1 (1_1), U401.14 (SCK); also elsewhere on the board
/CAN bus/CAN.STANDBY: R405.1, U401.5 (STBY); also elsewhere on the board
/CAN bus/CAN.TX0_RST: U401.23 (~Tx0RTS); also elsewhere on the board
GND: C401.1, C402.1, C403.1, C404.2, C405.2, C406.2, D401.2 (A), D402.2 (A), D403.2 (A), D404.1 (K), D405.1 (K), J401.2, J401.3, J401.9, J402.3, J402.4, J402.6, R405.2, U401.10 (GND), U401.26 (VSS), Y401.2 (GND); also elsewhere on the board
unnamed: C405.1, R401.1, R404.2
unnamed: C401.2, D404.2 (K), J401.8, J402.7, R401.2, TP403.1 (1_1), U401.4 (CANH)
unnamed: C406.1, D405.2 (K), J401.4, J402.2, R404.1, TP404.1 (1_1), U401.3 (CANL)
unnamed: U401.9 (OSC1), Y401.1 (Input)
unnamed: U401.8 (OSC2), Y401.3 (Output)
unnamed: U401.21 (RxCAN), U401.28 (RXD)
unnamed: U401.20 (TxCAN), U401.24 (TXD)

Notes on the sheet:
The CAN controller + MCU parts alone consume up to 100mA

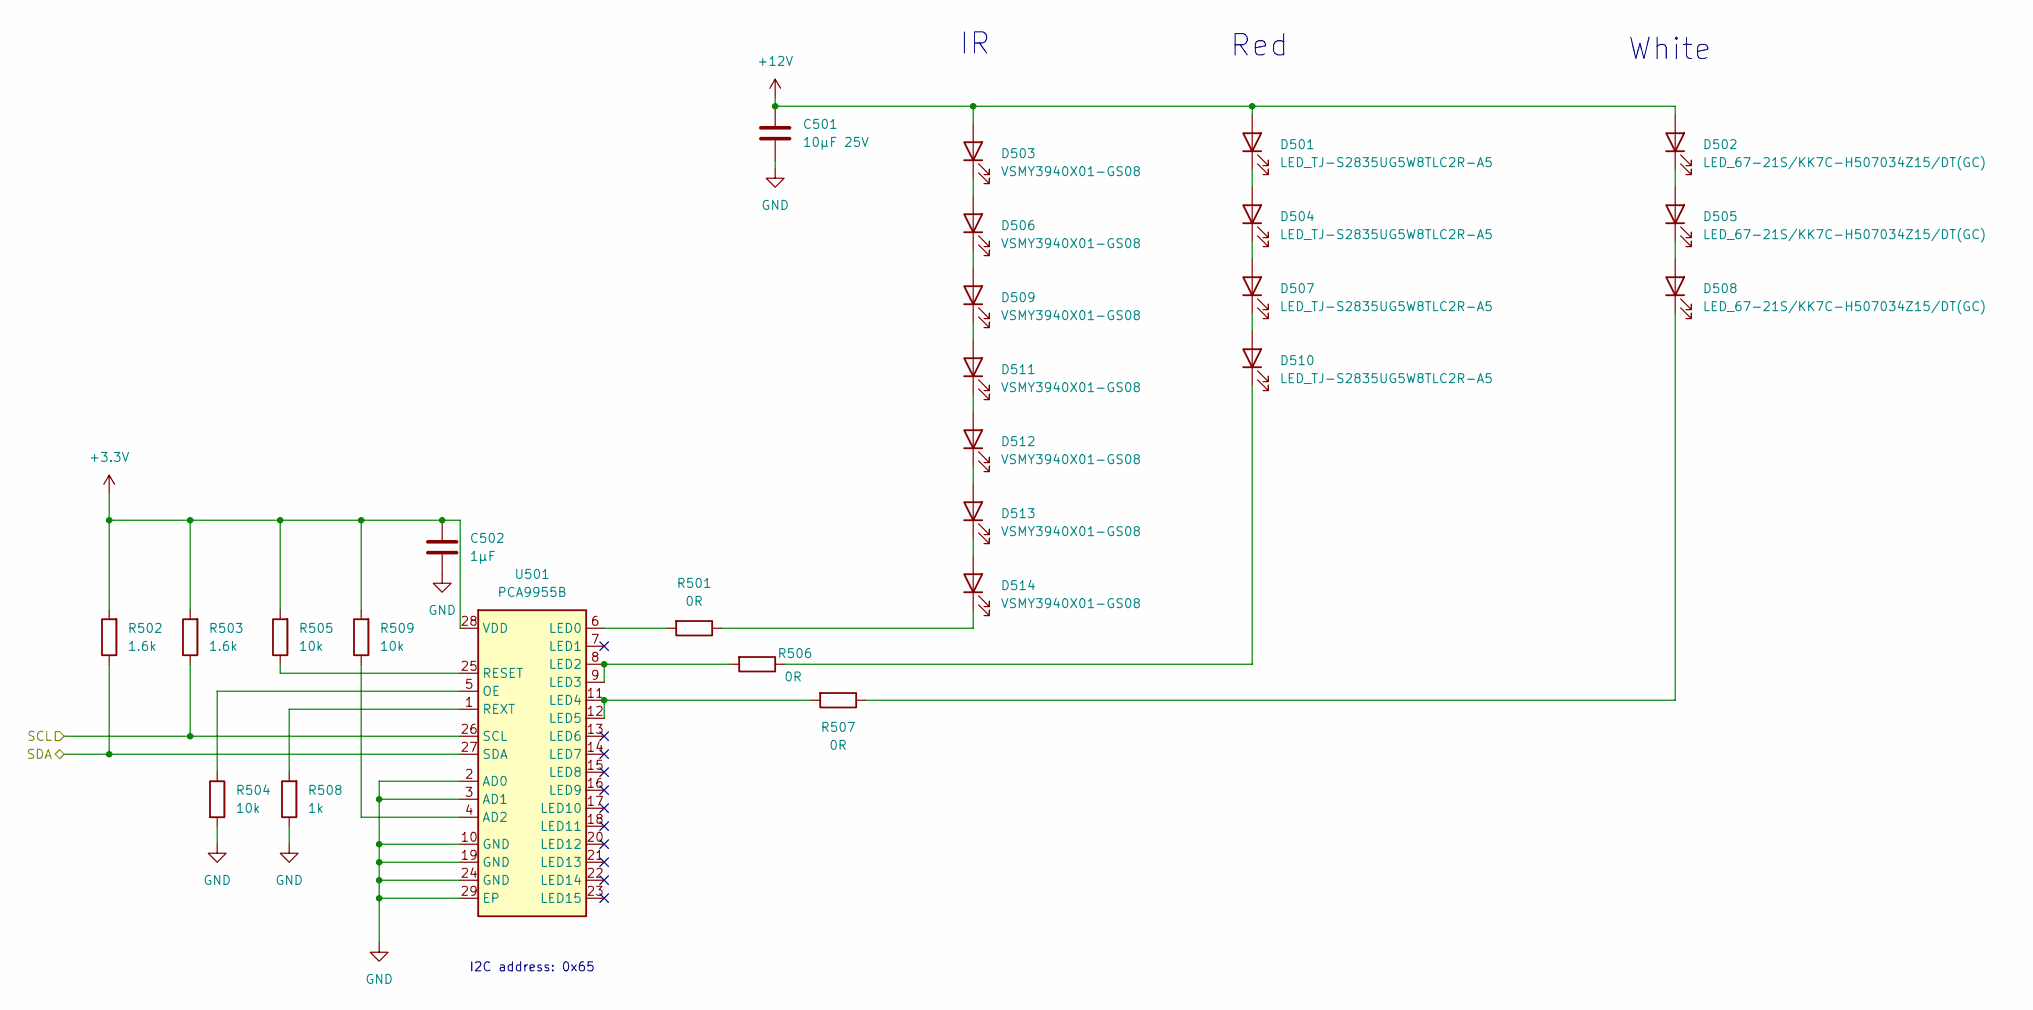
[picture p73: schematic LEDs.kicad_sch, BB_lighting]

Parts:
C501: 10µF 25V; C_0603_1608Metric
C502: 1µF; C_0603_1608Metric
D501, D504, D507, D510: LED_TJ-S2835UG5W8TLC2R-A5; LED_PLCC_2835_TOGIALED; MPN TJ-S2835UG5W8TLC2R-A5; JLCPCB Part C440450
D502, D505, D508: LED_67-21S/KK7C-H507034Z15/DT(GC); LED_PLCC_2835_Everlight; MPN 67-21S/KK7C-H507034Z15/DT(GC); JLCPCB Part C475394
D503, D506, D509, D511, D512, D513, D514: VSMY3940X01-GS08; LED_Vishay_PLCC-2; MPN VSMY3940X01-GS08; JLCPCB Part C962573
R501, R506, R507: 0R; R_0603_1608Metric
R502, R503: 1.6k; R_0603_1608Metric
R504, R505, R509: 10k; R_0603_1608Metric
R508: 1k; R_0603_1608Metric
U501: PCA9955B; NXP_HTSSOP-28-1EP_4.4x9.7mm_P0.65mm_EP2.2x3.4mm; MPN PCA9955BTW/Q900J; JLCPCB Part C2678554

Connections:
+3.3V: C502.1, R502.2, R503.2, R505.2, R509.2, U501.28 (VDD); also elsewhere on the board
+12V: C501.1, D501.2 (A), D502.2 (A), D503.2 (A); also elsewhere on the board
/LEDs/SCL: R503.1, U501.26 (SCL); also elsewhere on the board
/LEDs/SDA: R502.1, U501.27 (SDA); also elsewhere on the board
GND: C501.2, C502.2, R504.2, R508.1, U501.2 (AD0), U501.3 (AD1), U501.10 (GND), U501.19 (GND), U501.24 (GND), U501.29 (EP); also elsewhere on the board
unnamed: D501.1 (K), D504.2 (A)
unnamed: D502.1 (K), D505.2 (A)
unnamed: D503.1 (K), D506.2 (A)
unnamed: D504.1 (K), D507.2 (A)
unnamed: D505.1 (K), D508.2 (A)
unnamed: D506.1 (K), D509.2 (A)
unnamed: D507.1 (K), D510.2 (A)
unnamed: D508.1 (K), R507.1
unnamed: D509.1 (K), D511.2 (A)
unnamed: D510.1 (K), R506.1
unnamed: D511.1 (K), D512.2 (A)
unnamed: D512.1 (K), D513.2 (A)
unnamed: D513.1 (K), D514.2 (A)
unnamed: D514.1 (K), R501.1
unnamed: R509.1, U501.4 (AD2)
unnamed: R501.2, U501.6 (LED0)
unnamed: R506.2, U501.8 (LED2), U501.9 (LED3)
unnamed: R507.2, U501.11 (LED4), U501.12 (LED5)
unnamed: R504.1, U501.5 (OE)
unnamed: R505.1, U501.25 (RESET)
unnamed: R508.2, U501.1 (REXT)

Notes on the sheet:
Red
I2C address: 0x65
White

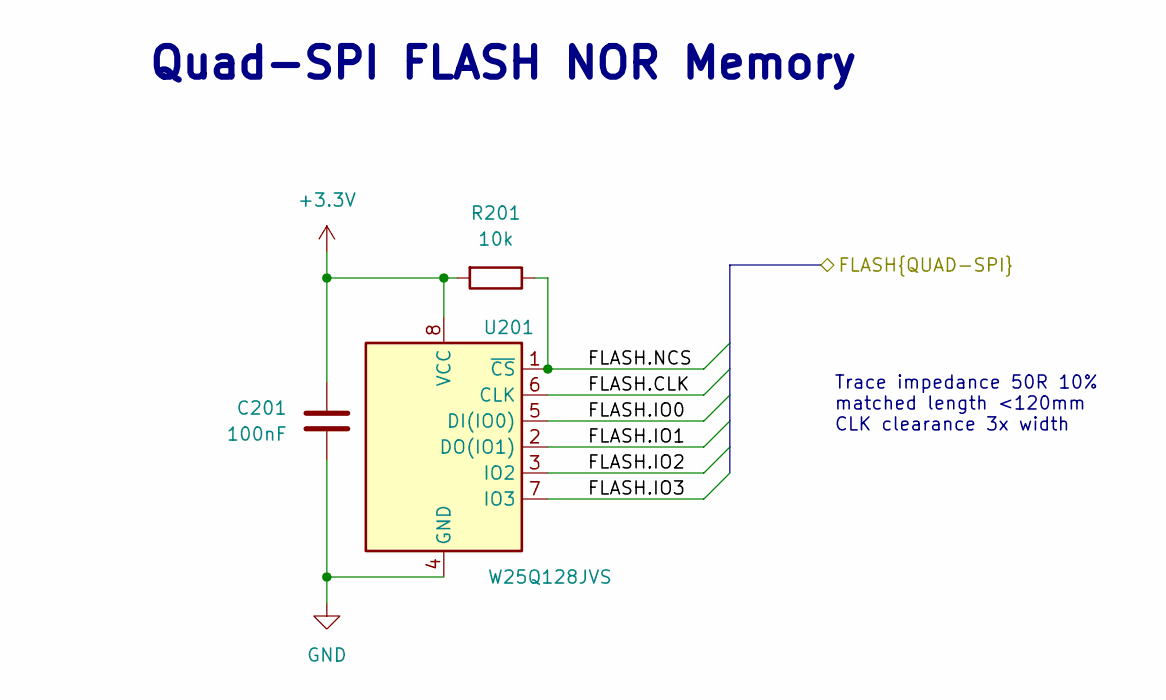
[picture p74: schematic Memory.kicad_sch, BB_lighting]

Parts:
C201: 100nF; C_0603_1608Metric
R201: 10k; R_0603_1608Metric
U201: W25Q128JVS; SOIC-8_W25Q128JV; MPN W25Q128JVS; JLCPCB Part C97521

Connections:
+3.3V: C201.2, R201.2, U201.8 (VCC); also elsewhere on the board
/MCU/FLASH.CLK: U201.6 (CLK); also elsewhere on the board
/MCU/FLASH.IO0: U201.5 (DI(IO0)); also elsewhere on the board
/MCU/FLASH.IO1: U201.2 (DO(IO1)); also elsewhere on the board
/MCU/FLASH.IO2: U201.3 (IO2); also elsewhere on the board
/MCU/FLASH.IO3: U201.7 (IO3); also elsewhere on the board
/MCU/FLASH.NCS: R201.1, U201.1 (~CS); also elsewhere on the board
GND: C201.1, U201.4 (GND); also elsewhere on the board

Notes on the sheet:
Trace impedance 50R 10% matched length <120mm CLK clearance 3x width
Quad-SPI FLASH NOR Memory

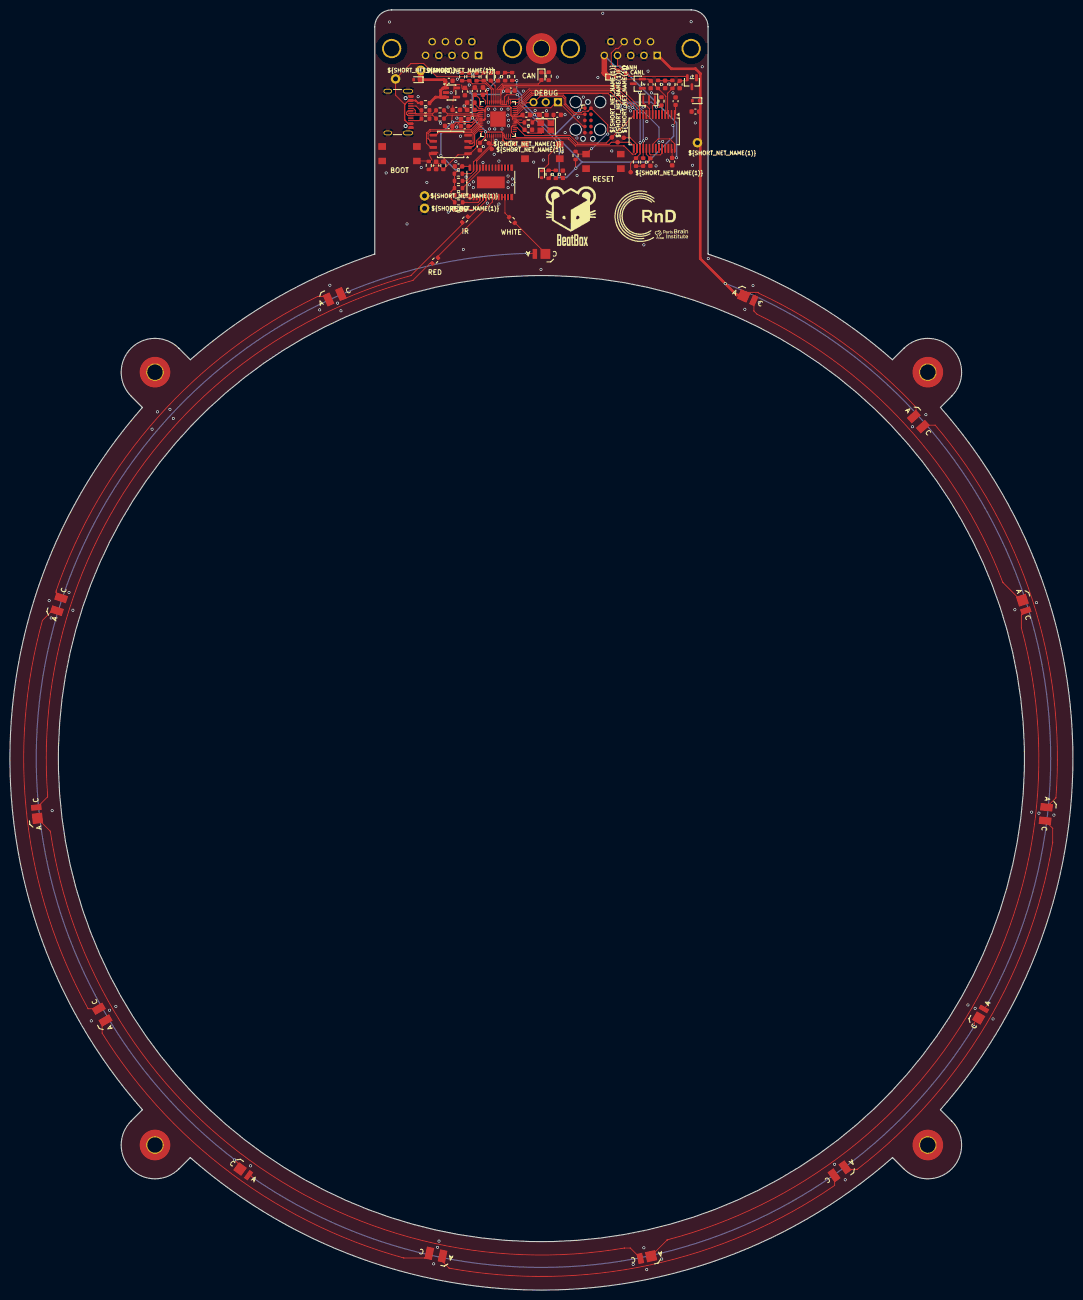
[picture p75: board BB_lighting_V1.kicad_pcb from above]

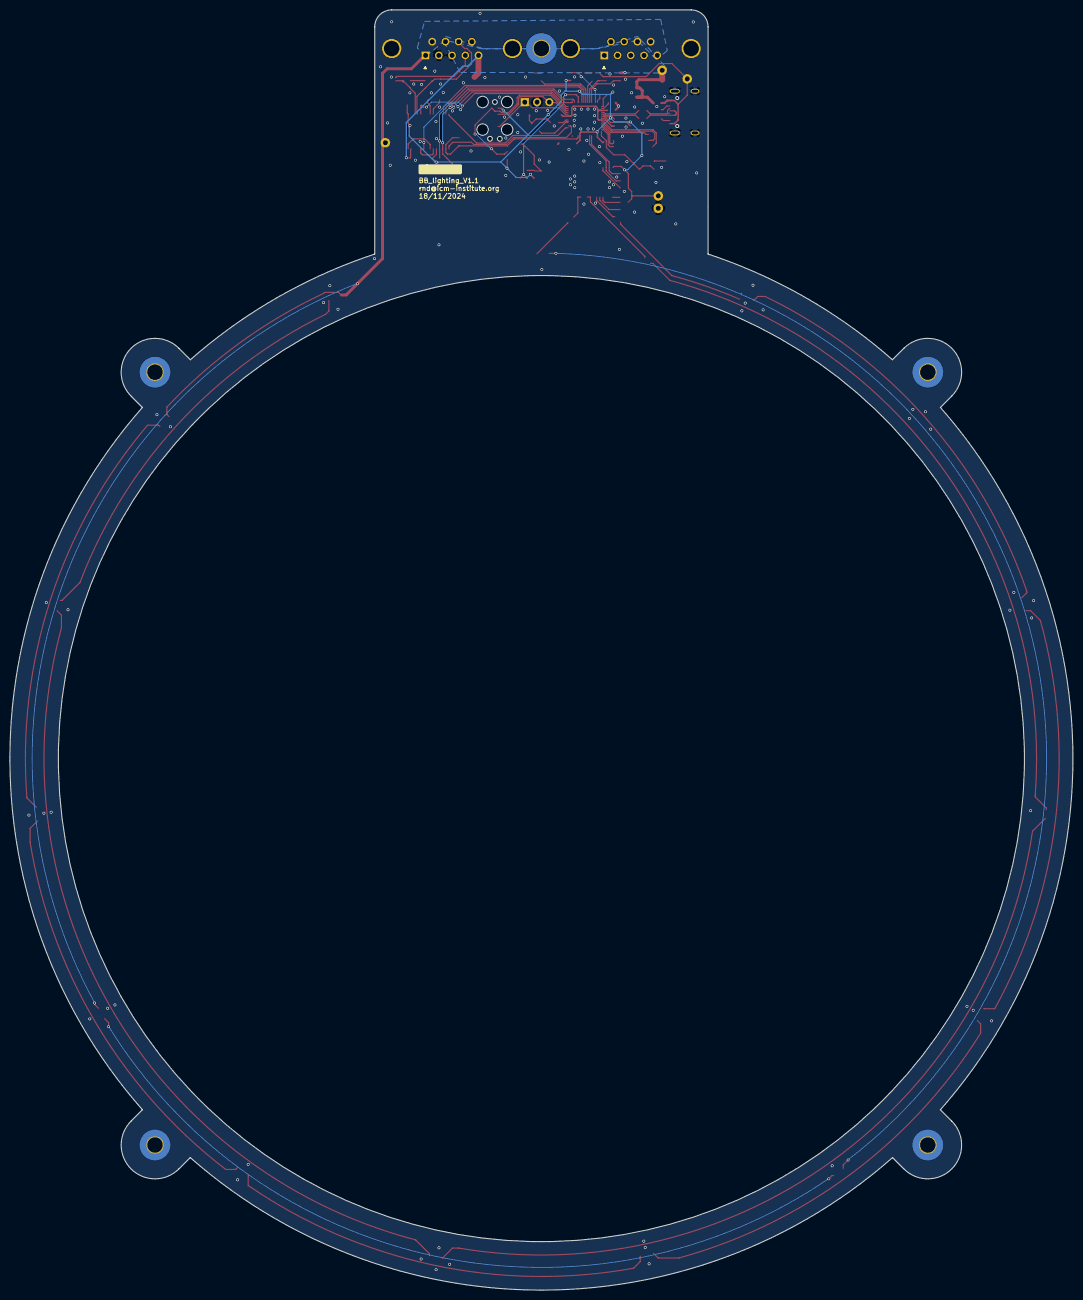
[picture p76: board BB_lighting_V1.kicad_pcb from below]

Board: 4 copper layers, 220.1 x 265.0 mm, 116 parts (2 on the bottom side), 73 nets.

Other parts of the board:
G2: LOGO
