Open-BeatBox/Open-BeatBox_Hardware/electronics/BB_screen_main_V1/BB_screen_main_V1.kicad_pcb

## KiCad design electronics/BB_screen_main_V1/BB_screen_main_V1.kicad_pcb (2026-09-29)

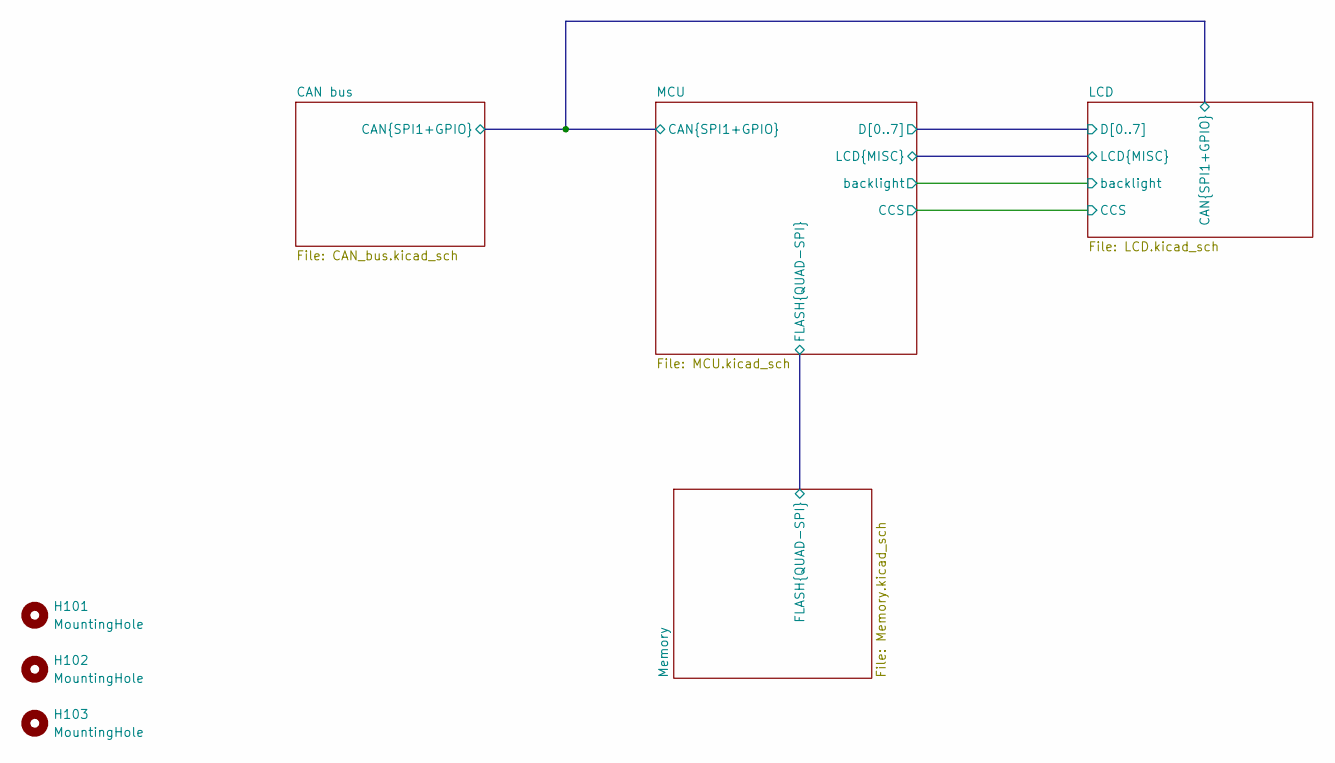
[picture p77: schematic BB_screen_main_V1.kicad_sch]

Parts:
H101, H102, H103: MountingHole; MountingHole_3.2mm_M3_Pad_TopBottom
