Open-BeatBox/Open-BeatBox_Hardware/electronics/BB_screen_main_V1/BB_screen_main_V1.kicad_pcb

## KiCad design electronics/BB_screen_main_V1/BB_screen_main_V1.kicad_pcb (continued)

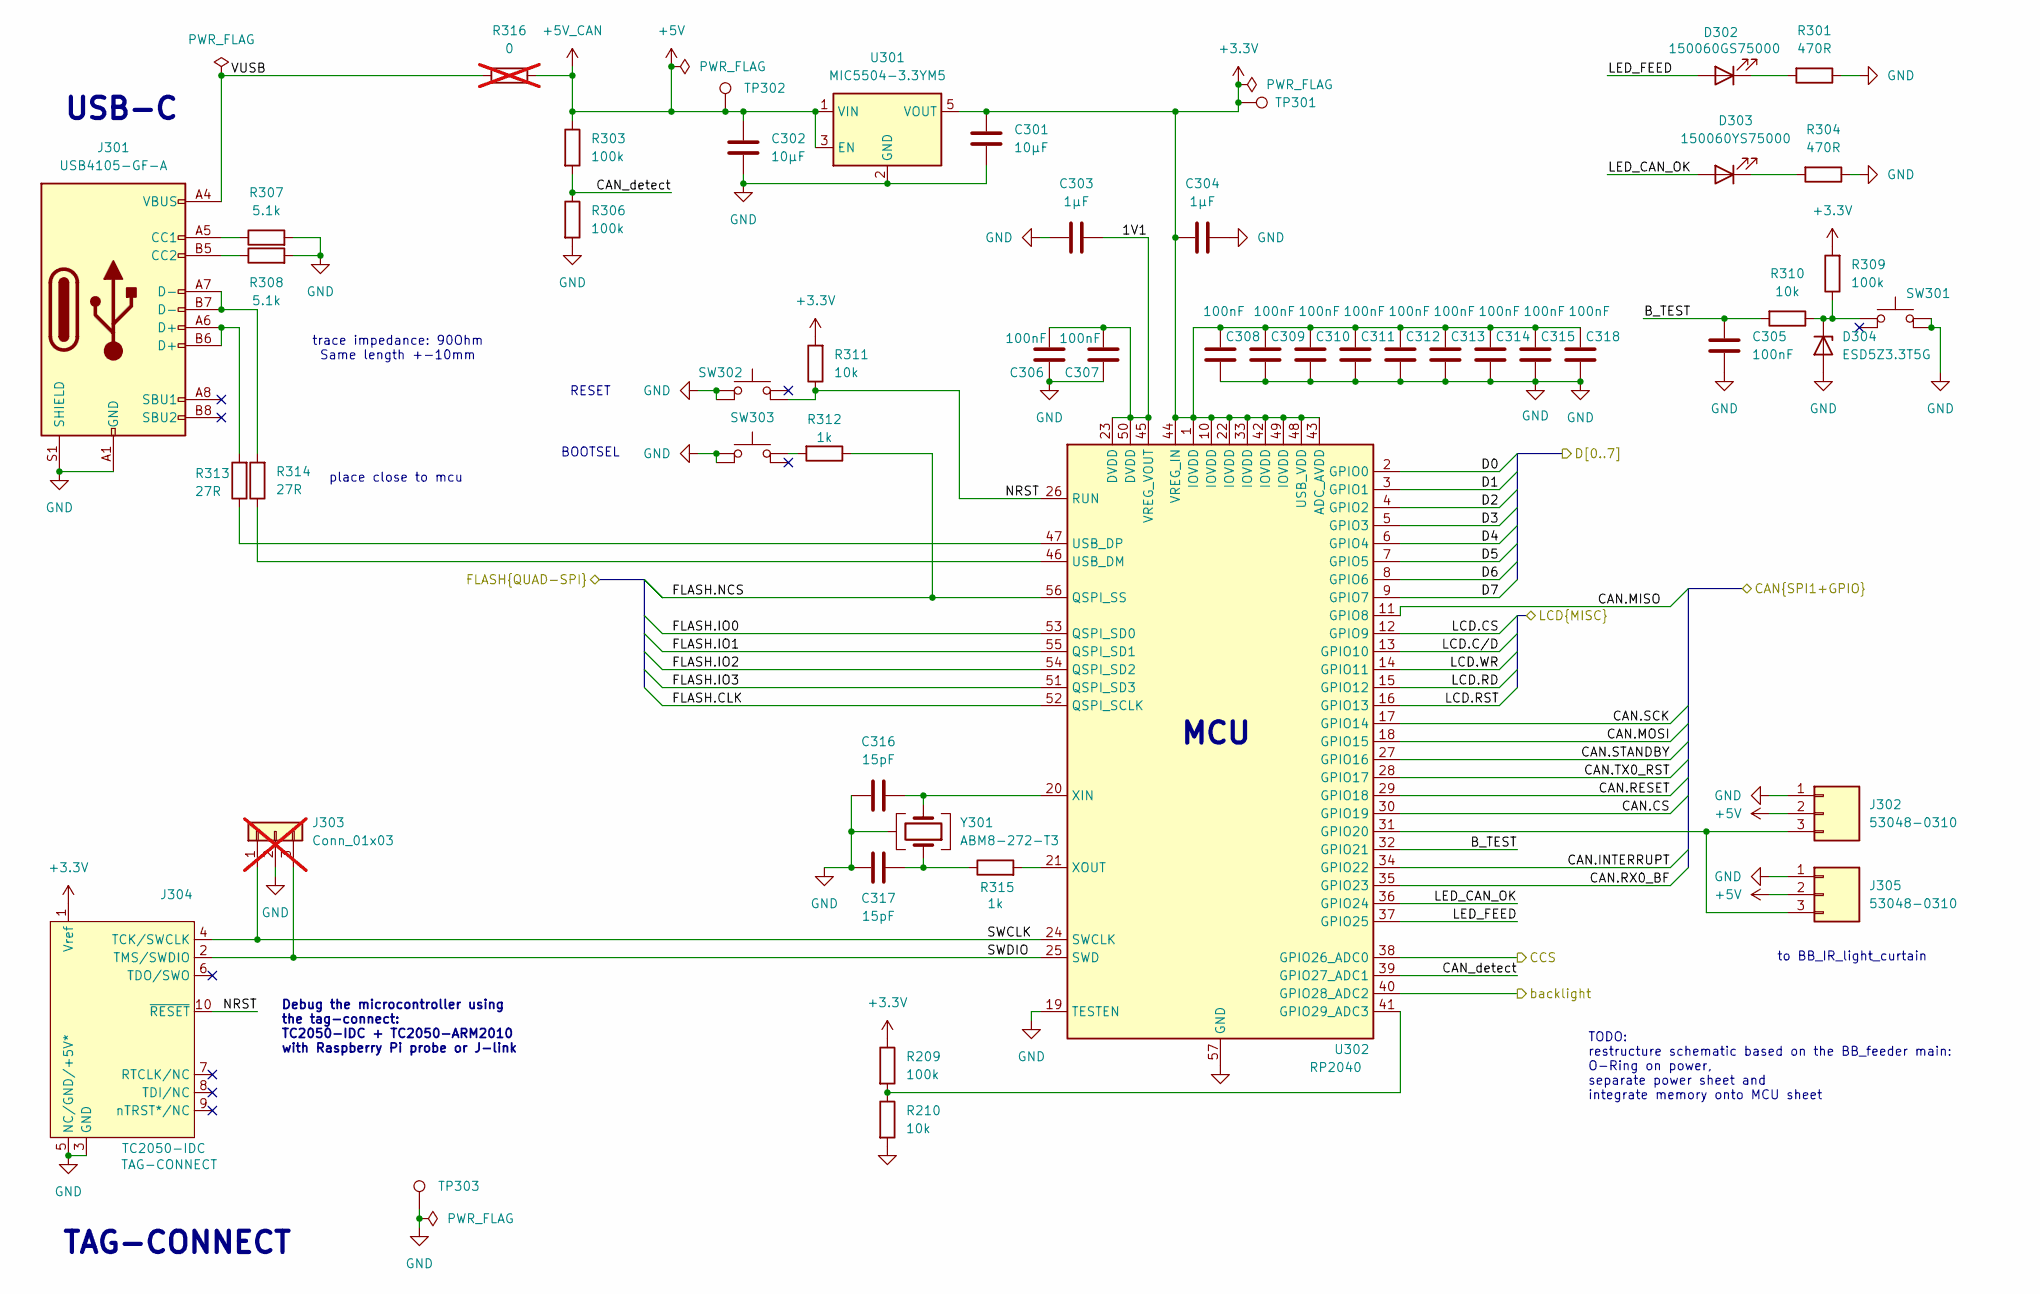
[picture p78: schematic MCU.kicad_sch, BB_nosepoke]

Parts:
C301, C302: 10µF; C_0603_1608Metric
C303, C304: 1µF; C_0603_1608Metric
C305, C306, C307, C308, C309, C310, C311, C312, C313, C314, C315, C318: 100nF; C_0603_1608Metric
C316, C317: 15pF; C_0603_1608Metric
D302: LED_150060GS75000; LED_0603_1608Metric; MPN 150060GS75000; JLC Part C5252984
D303: LED_150060YS75000; LED_0603_1608Metric; MPN 150060YS75000; JLC Part C6784997
D304: TVS_ESD5Z3.3T5G; D_SOD-523; MPN ESD5Z3.3T5G; JLC Part C22440024
J301: Conn_USB-C_USB4105-GF-A; Conn_USB_C_Receptacle_GCT_USB4105-xx-A_16P_TopMnt_Horizontal; MPN USB4105-GF-A; JLC Part C393939
J302, J305: Conn_Picoblade_Molex_53048-0310; Conn_Molex_PicoBlade_53048-0310_1x03_P1.25mm_Horizontal; MPN 53048-0310; JLC Part C505275
J303: Conn_01x03; PinHeader_1x03_P2.54mm_Vertical; not fitted
J304: Conn_TagConnect_TC2050-IDC; Tag-Connect_TC2050-IDC-FP_2x05_P1.27mm_Vertical; MPN TC2050-IDC
R209, R303, R306, R309: 100k; R_0603_1608Metric
R210, R310, R311: 10k; R_0603_1608Metric
R301, R304: 470R; R_0603_1608Metric
R307, R308: 5.1k; R_0603_1608Metric
R312, R315: 1k; R_0603_1608Metric
R313, R314: 27R; R_0603_1608Metric
R316: 0; R_0603_1608Metric; not fitted
SW301, SW302, SW303: SW_TL3305AF160QG; SW_Push_TL3305; MPN TL3305AF160QG; JLC Part C18078070
TP301, TP302, TP303: TestPoint; TestPoint_THTPad_D2.0mm_Drill1.0mm
U301: MIC5504-3.3YM5; SOT-23-5; MPN MIC5504-3.3YM5; JLC Part C88419
U302: RP2040; QFN-56-1EP_7x7mm_P0.4mm_EP3.2x3.2mm; MPN RP2040; JLC Part C2040
Y301: Crystal_ABM8-272-T3; Crystal_SMD_Abracon_ABM8; MPN ABM8-272-T3; JLC Part C20625731

Connections:
+3.3V: C301.1, C304.1, C308.1, C309.1, C310.1, C311.1, C312.1, C313.1, C314.1, C315.1, C318.1, J304.1 (Vref), R209.1, R309.2, R311.2, TP301.1 (1_1), U301.5 (VOUT), U302.1 (IOVDD), U302.10 (IOVDD), U302.22 (IOVDD), U302.33 (IOVDD), U302.42 (IOVDD), U302.43 (ADC_AVDD), U302.44 (VREG_IN), U302.48 (USB_VDD), U302.49 (IOVDD); also elsewhere on the board
+5V: C302.1, J302.2, J305.2, R303.1, R316.2, TP302.1 (1_1), U301.1 (VIN), U301.3 (EN); also elsewhere on the board
/CAN bus/CAN.CS: U302.30 (GPIO19); also elsewhere on the board
/CAN bus/CAN.INTERRUPT: U302.34 (GPIO22); also elsewhere on the board
/CAN bus/CAN.MISO: U302.11 (GPIO8); also elsewhere on the board
/CAN bus/CAN.MOSI: U302.18 (GPIO15); also elsewhere on the board
/CAN bus/CAN.RESET: U302.29 (GPIO18); also elsewhere on the board
/CAN bus/CAN.RX0_BF: U302.35 (GPIO23); also elsewhere on the board
/CAN bus/CAN.SCK: U302.17 (GPIO14); also elsewhere on the board
/CAN bus/CAN.STANDBY: U302.27 (GPIO16); also elsewhere on the board
/CAN bus/CAN.TX0_RST: U302.28 (GPIO17); also elsewhere on the board
/LCD/CCS: U302.38 (GPIO26_ADC0); also elsewhere on the board
/LCD/D0: U302.2 (GPIO0); also elsewhere on the board
/LCD/D1: U302.3 (GPIO1); also elsewhere on the board
/LCD/D2: U302.4 (GPIO2); also elsewhere on the board
/LCD/D3: U302.5 (GPIO3); also elsewhere on the board
/LCD/D4: U302.6 (GPIO4); also elsewhere on the board
/LCD/D5: U302.7 (GPIO5); also elsewhere on the board
/LCD/D6: U302.8 (GPIO6); also elsewhere on the board
/LCD/D7: U302.9 (GPIO7); also elsewhere on the board
/LCD/LCD.CS: U302.12 (GPIO9); also elsewhere on the board
/LCD/LCD.C/D: U302.13 (GPIO10); also elsewhere on the board
/LCD/LCD.RD: U302.15 (GPIO12); also elsewhere on the board
/LCD/LCD.RST: U302.16 (GPIO13); also elsewhere on the board
/LCD/LCD.WR: U302.14 (GPIO11); also elsewhere on the board
/LCD/backlight: U302.40 (GPIO28_ADC2); also elsewhere on the board
/MCU/1V1: C303.2, C306.2, C307.1, U302.23 (DVDD), U302.45 (VREG_VOUT), U302.50 (DVDD)
/MCU/B_TEST: C305.1, R310.2, U302.32 (GPIO21)
/MCU/CAN_detect: R303.2, R306.1, U302.39 (GPIO27_ADC1)
/MCU/FLASH.CLK: U302.52 (QSPI_SCLK); also elsewhere on the board
/MCU/FLASH.IO0: U302.53 (QSPI_SD0); also elsewhere on the board
/MCU/FLASH.IO1: U302.55 (QSPI_SD1); also elsewhere on the board
/MCU/FLASH.IO2: U302.54 (QSPI_SD2); also elsewhere on the board
/MCU/FLASH.IO3: U302.51 (QSPI_SD3); also elsewhere on the board
/MCU/FLASH.NCS: R312.1, U302.56 (QSPI_SS); also elsewhere on the board
/MCU/LED_CAN_OK: D303.2 (A), U302.36 (GPIO24)
/MCU/LED_FEED: D302.2 (A), U302.37 (GPIO25)
/MCU/NRST: J304.10 (~RESET), R311.1, SW302.2, U302.26 (RUN)
/MCU/SWCLK: J303.1, J304.4 (TCK/SWCLK), U302.24 (SWCLK)
/MCU/SWDIO: J303.3, J304.2 (TMS/SWDIO), U302.25 (SWD)
/MCU/VUSB: J301.A4 (VBUS), J301.A9 (VBUS), J301.B4 (VBUS), J301.B9 (VBUS), R316.1
GND: C301.2, C302.2, C303.1, C304.2, C305.2, C306.1, C307.2, C308.2, C309.2, C310.2, C311.2, C312.2, C313.2, C314.2, C315.2, C316.1, C317.1, C318.2, D304.2 (A), J301.A1 (GND), J301.A12 (GND), J301.B1 (GND), J301.B12 (GND), J301.S1 (SHIELD), J302.1, J303.2, J304.3 (GND), J304.5 (NC/GND/+5V*), J305.1, R210.2, R301.1, R304.1, R306.2, R307.2, R308.2, SW301.1, SW301.2, SW302.3, SW302.4, SW303.1, SW303.2, TP303.1 (1_1), U301.2 (GND), U302.19 (TESTEN), U302.57 (GND), Y301.2, Y301.4; also elsewhere on the board
unnamed: C317.2, R315.1, Y301.1
unnamed: D302.1 (K), R301.2
unnamed: D303.1 (K), R304.2
unnamed: D304.1 (K), R309.1, R310.1, SW301.3
unnamed: J301.A5 (CC1), R307.1
unnamed: J301.B5 (CC2), R308.1
unnamed: J301.A6 (D+), J301.B6 (D+), R313.2
unnamed: J301.A7 (D-), J301.B7 (D-), R314.2
unnamed: J302.3, J305.3, U302.31 (GPIO20)
unnamed: R312.2, SW303.3
unnamed: R209.2, R210.1, U302.41 (GPIO29_ADC3)
unnamed: R314.1, U302.46 (USB_DM)
unnamed: R313.1, U302.47 (USB_DP)
unnamed: C316.2, U302.20 (XIN), Y301.3
unnamed: R315.2, U302.21 (XOUT)

Notes on the sheet:
trace impedance: 90Ohm Same length +-10mm
TODO: restructure schematic based on the BB_feeder main: O-Ring on power, separate power sheet and integrate memory onto MCU sheet
TAG-CONNECT
MCU
place close to mcu
BOOTSEL
Debug the microcontroller using the tag-connect: TC2050-IDC + TC2050-ARM2010 with Raspberry Pi probe or J-link
RESET
USB-C
to BB_IR_light_curtain

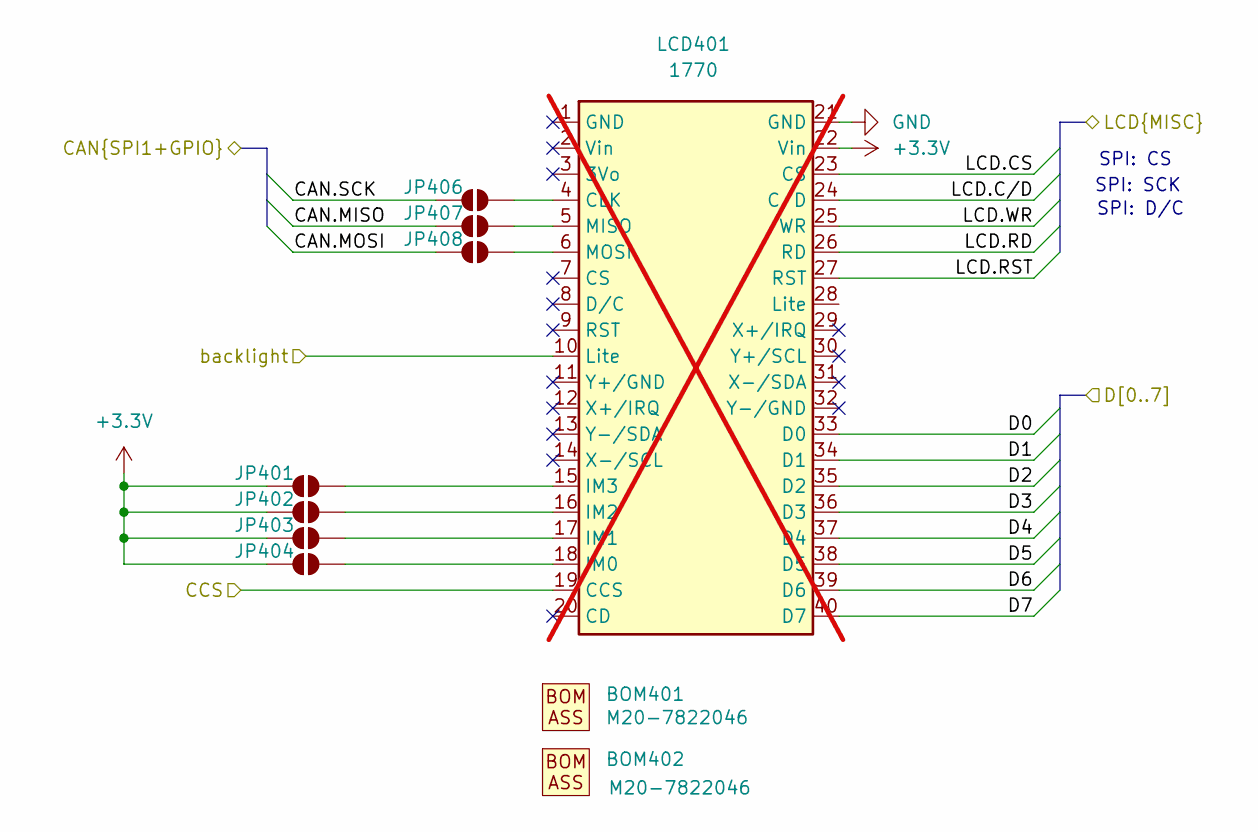
[picture p79: schematic LCD.kicad_sch]

Parts:
BOM401, BOM402: M20-7822046; Placeholder; MPN M20-7822046; JLC Part C7499336
JP401, JP402, JP403, JP404, JP406, JP407, JP408: SolderJumper_2_Open; SolderJumper-2_P1.3mm_Open_RoundedPad1.0x1.5mm
LCD401: 1770; Adafruit_2.8_TFT_LCD_1771; MPN 1770; not fitted

Connections:
+3.3V: JP401.1 (A), JP402.1 (A), JP403.1 (A), JP404.1 (A), LCD401.22 (Vin); also elsewhere on the board
/CAN bus/CAN.MISO: JP407.1 (A); also elsewhere on the board
/CAN bus/CAN.MOSI: JP408.1 (A); also elsewhere on the board
/CAN bus/CAN.SCK: JP406.1 (A); also elsewhere on the board
/LCD/CCS: LCD401.19 (CCS); also elsewhere on the board
/LCD/D0: LCD401.33 (D0); also elsewhere on the board
/LCD/D1: LCD401.34 (D1); also elsewhere on the board
/LCD/D2: LCD401.35 (D2); also elsewhere on the board
/LCD/D3: LCD401.36 (D3); also elsewhere on the board
/LCD/D4: LCD401.37 (D4); also elsewhere on the board
/LCD/D5: LCD401.38 (D5); also elsewhere on the board
/LCD/D6: LCD401.39 (D6); also elsewhere on the board
/LCD/D7: LCD401.40 (D7); also elsewhere on the board
/LCD/LCD.CS: LCD401.23 (CS); also elsewhere on the board
/LCD/LCD.C/D: LCD401.24 (C/D); also elsewhere on the board
/LCD/LCD.RD: LCD401.26 (RD); also elsewhere on the board
/LCD/LCD.RST: LCD401.27 (RST); also elsewhere on the board
/LCD/LCD.WR: LCD401.25 (WR); also elsewhere on the board
/LCD/backlight: LCD401.10 (Lite); also elsewhere on the board
GND: LCD401.21 (GND); also elsewhere on the board
unnamed: JP401.2 (B), LCD401.15 (IM3)
unnamed: JP402.2 (B), LCD401.16 (IM2)
unnamed: JP403.2 (B), LCD401.17 (IM1)
unnamed: JP404.2 (B), LCD401.18 (IM0)
unnamed: JP406.2 (B), LCD401.4 (CLK)
unnamed: JP407.2 (B), LCD401.5 (MISO)
unnamed: JP408.2 (B), LCD401.6 (MOSI)

Notes on the sheet:
SPI: SCK
SPI: CS
SPI: D/C

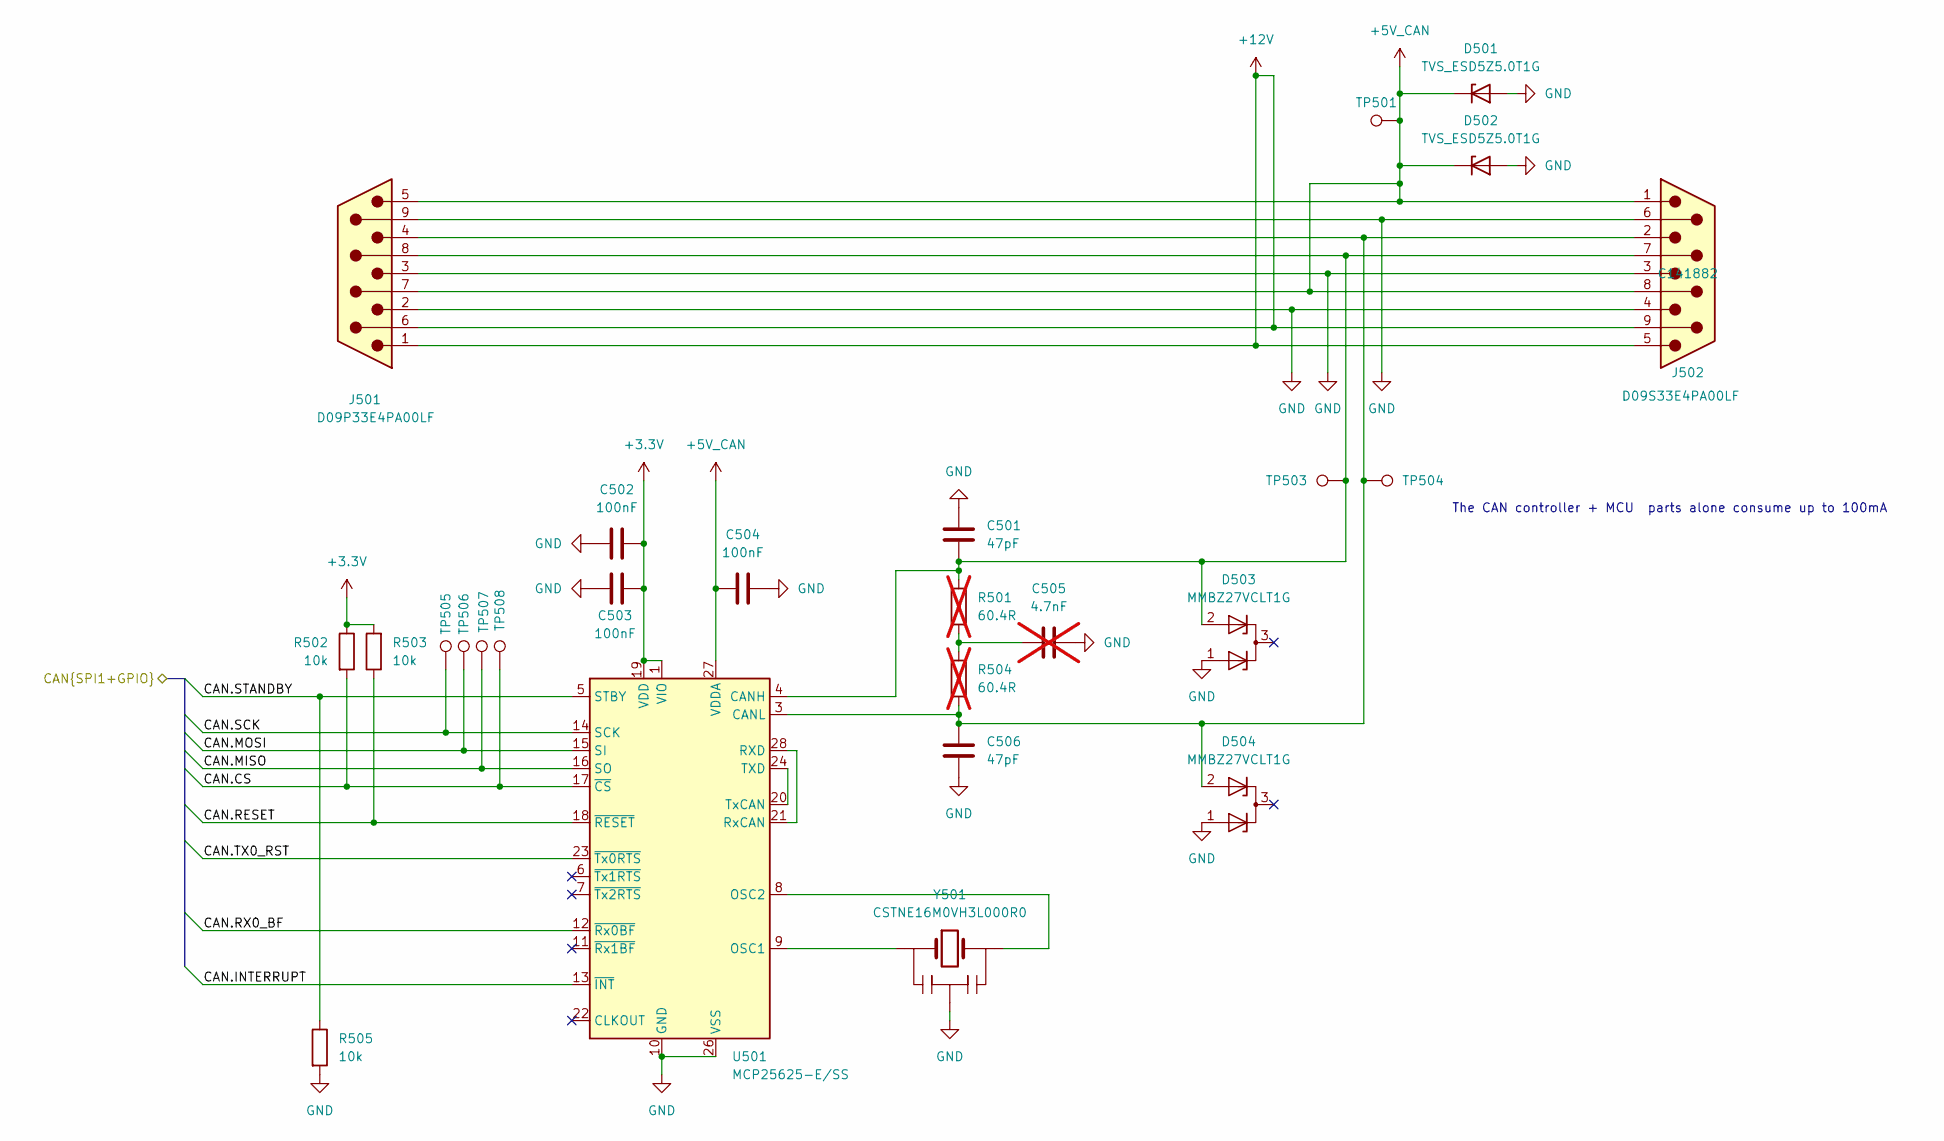
[picture p80: schematic CAN_bus.kicad_sch, BB_nosepoke]

Parts:
C501, C506: 47pF; C_0603_1608Metric
C502, C503, C504: 100nF; C_0603_1608Metric
C505: 4.7nF; C_0603_1608Metric; not fitted
D501, D502: TVS_ESD5Z5.0T1G; D_SOD-523; MPN ESD5Z5.0T1G; JLC Part C343989
D503, D504: MMBZ27VCLT1G; SOT-23; MPN MMBZ27VCLT1G; JLC Part C128609
J501: Conn-DB9_D09P33E4PA00LF; Conn_DB9_D09P33E4PA00LF; MPN D09P33E4PA00LF; JLC Part C19077344
J502: Conn-DB9_D09S33E4PA00LF; Conn_DB9_D09S33E4PA00LF; MPN D09S33E4PA00LF; JLC Part C141882
R501, R504: 60.4R; R_0603_1608Metric; not fitted
R502, R503, R505: 10k; R_0603_1608Metric
TP501: TestPoint; TestPoint_THTPad_D2.0mm_Drill1.0mm
TP503, TP504, TP505, TP506, TP507, TP508: TestPoint_SMD; TestPoint_Pad_D1.0mm
U501: MCP25625-E/SS; SSOP-28_5.3x10.2mm_P0.65mm; MPN MCP25625-E/SS; JLC Part C184944
Y501: CSTNE16M0VH3L000R0; Resonator_SMD_Murata_CSTxExxV-3Pin_3.0x1.1mm; MPN CSTNE16M0VH3L000R0; JLC Part C1870467

Connections:
+3.3V: C502.2, C503.2, R502.1, R503.2, U501.1 (VIO), U501.19 (VDD); also elsewhere on the board
+5V: C504.1, D501.1 (K), D502.1 (K), J501.5, J501.7, J502.1, J502.8, TP501.1 (1_1), U501.27 (VDDA); also elsewhere on the board
+12V: J501.1, J501.6, J502.5, J502.9
/CAN bus/CAN.CS: R502.2, TP508.1 (1_1), U501.17 (~CS); also elsewhere on the board
/CAN bus/CAN.INTERRUPT: U501.13 (~INT); also elsewhere on the board
/CAN bus/CAN.MISO: TP507.1 (1_1), U501.16 (SO); also elsewhere on the board
/CAN bus/CAN.MOSI: TP506.1 (1_1), U501.15 (SI); also elsewhere on the board
/CAN bus/CAN.RESET: R503.1, U501.18 (~RESET); also elsewhere on the board
/CAN bus/CAN.RX0_BF: U501.12 (~Rx0BF); also elsewhere on the board
/CAN bus/CAN.SCK: TP505.1 (1_1), U501.14 (SCK); also elsewhere on the board
/CAN bus/CAN.STANDBY: R505.1, U501.5 (STBY); also elsewhere on the board
/CAN bus/CAN.TX0_RST: U501.23 (~Tx0RTS); also elsewhere on the board
GND: C501.1, C502.1, C503.1, C504.2, C505.2, C506.2, D501.2 (A), D502.2 (A), D503.1 (K), D504.1 (K), J501.2, J501.3, J501.9, J502.3, J502.4, J502.6, R505.2, U501.10 (GND), U501.26 (VSS), Y501.2 (GND); also elsewhere on the board
unnamed: C505.1, R501.1, R504.2
unnamed: C501.2, D503.2 (K), J501.8, J502.7, R501.2, TP503.1 (1_1), U501.4 (CANH)
unnamed: C506.1, D504.2 (K), J501.4, J502.2, R504.1, TP504.1 (1_1), U501.3 (CANL)
unnamed: U501.9 (OSC1), Y501.1 (Input)
unnamed: U501.8 (OSC2), Y501.3 (Output)
unnamed: U501.21 (RxCAN), U501.28 (RXD)
unnamed: U501.20 (TxCAN), U501.24 (TXD)

Notes on the sheet:
The CAN controller + MCU parts alone consume up to 100mA

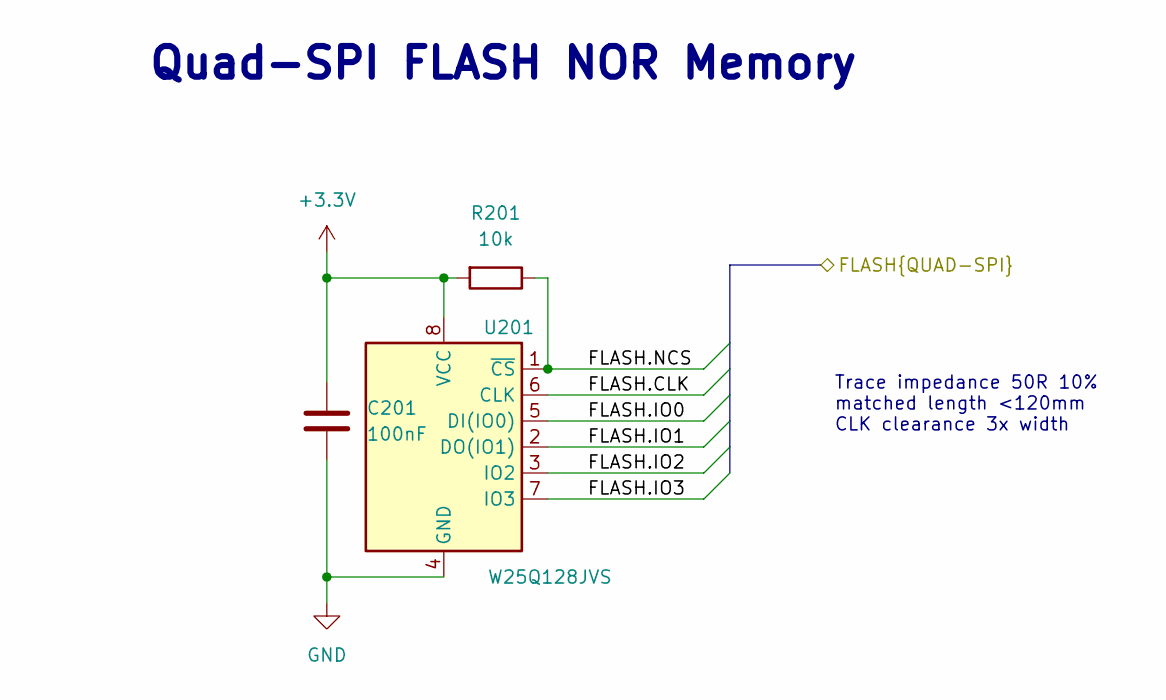
[picture p81: schematic Memory.kicad_sch, BB_nosepoke]

Parts:
C201: 100nF; C_0603_1608Metric
R201: 10k; R_0603_1608Metric
U201: W25Q128JVS; SOIC-8_W25Q128JV; MPN W25Q128JVS; JLC Part C97521

Connections:
+3.3V: C201.2, R201.2, U201.8 (VCC); also elsewhere on the board
/MCU/FLASH.CLK: U201.6 (CLK); also elsewhere on the board
/MCU/FLASH.IO0: U201.5 (DI(IO0)); also elsewhere on the board
/MCU/FLASH.IO1: U201.2 (DO(IO1)); also elsewhere on the board
/MCU/FLASH.IO2: U201.3 (IO2); also elsewhere on the board
/MCU/FLASH.IO3: U201.7 (IO3); also elsewhere on the board
/MCU/FLASH.NCS: R201.1, U201.1 (~CS); also elsewhere on the board
GND: C201.1, U201.4 (GND); also elsewhere on the board

Notes on the sheet:
Trace impedance 50R 10% matched length <120mm CLK clearance 3x width
Quad-SPI FLASH NOR Memory

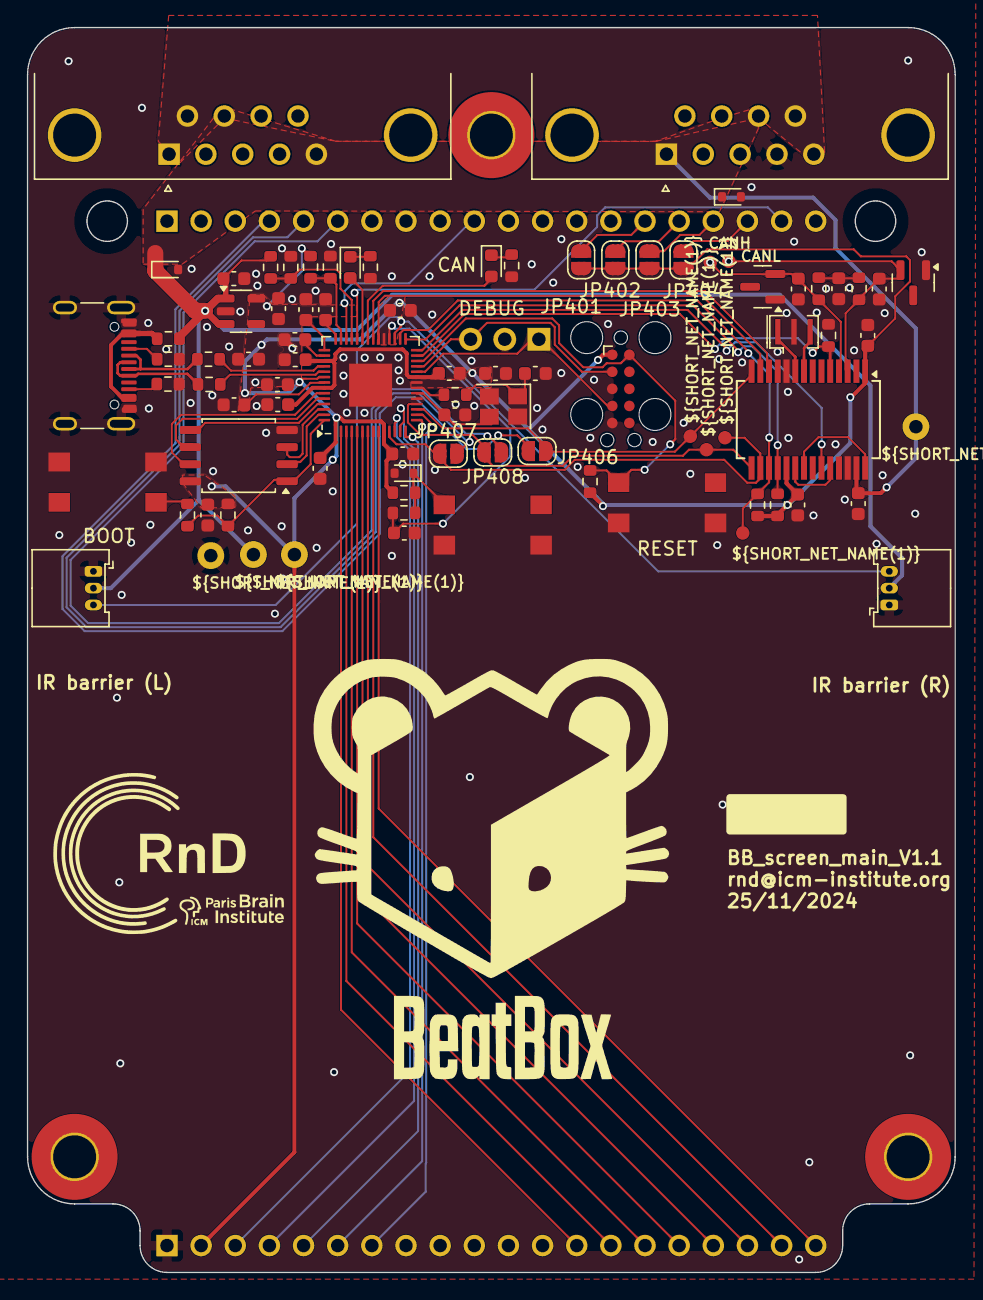
[picture p82: board BB_screen_main_V1.kicad_pcb from above]

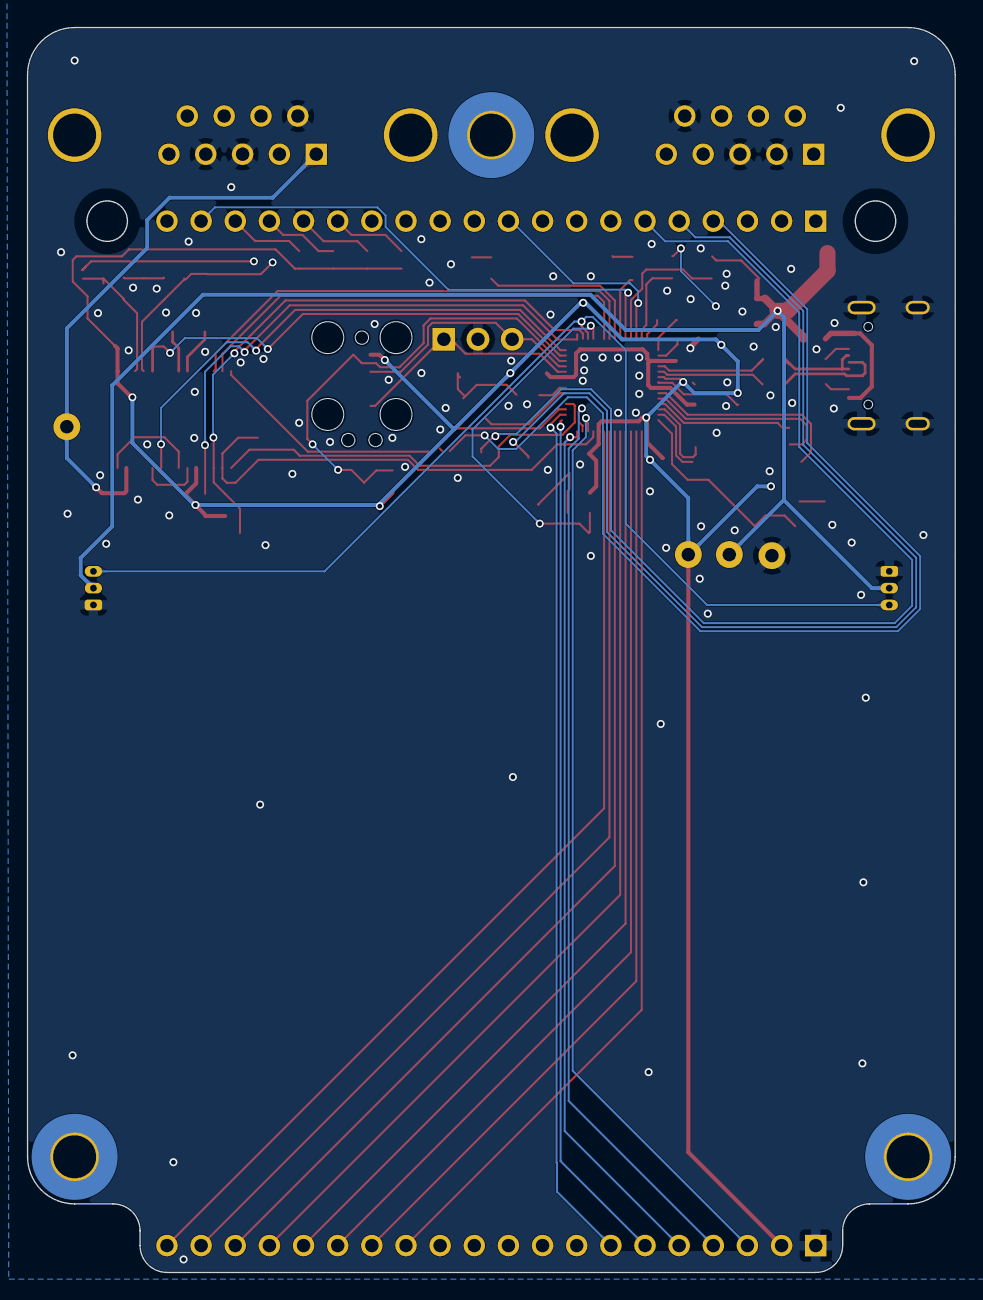
[picture p83: board BB_screen_main_V1.kicad_pcb from below]

Board: 4 copper layers, 69.0 x 92.6 mm, 93 parts (3 on the bottom side), 72 nets.
