Open-BeatBox/Open-BeatBox_Hardware/electronics/BB_feeder_main_V1/BB_feeder_main_V1.kicad_pcb

## KiCad design electronics/BB_feeder_main_V1/BB_feeder_main_V1.kicad_pcb (2026-09-29)

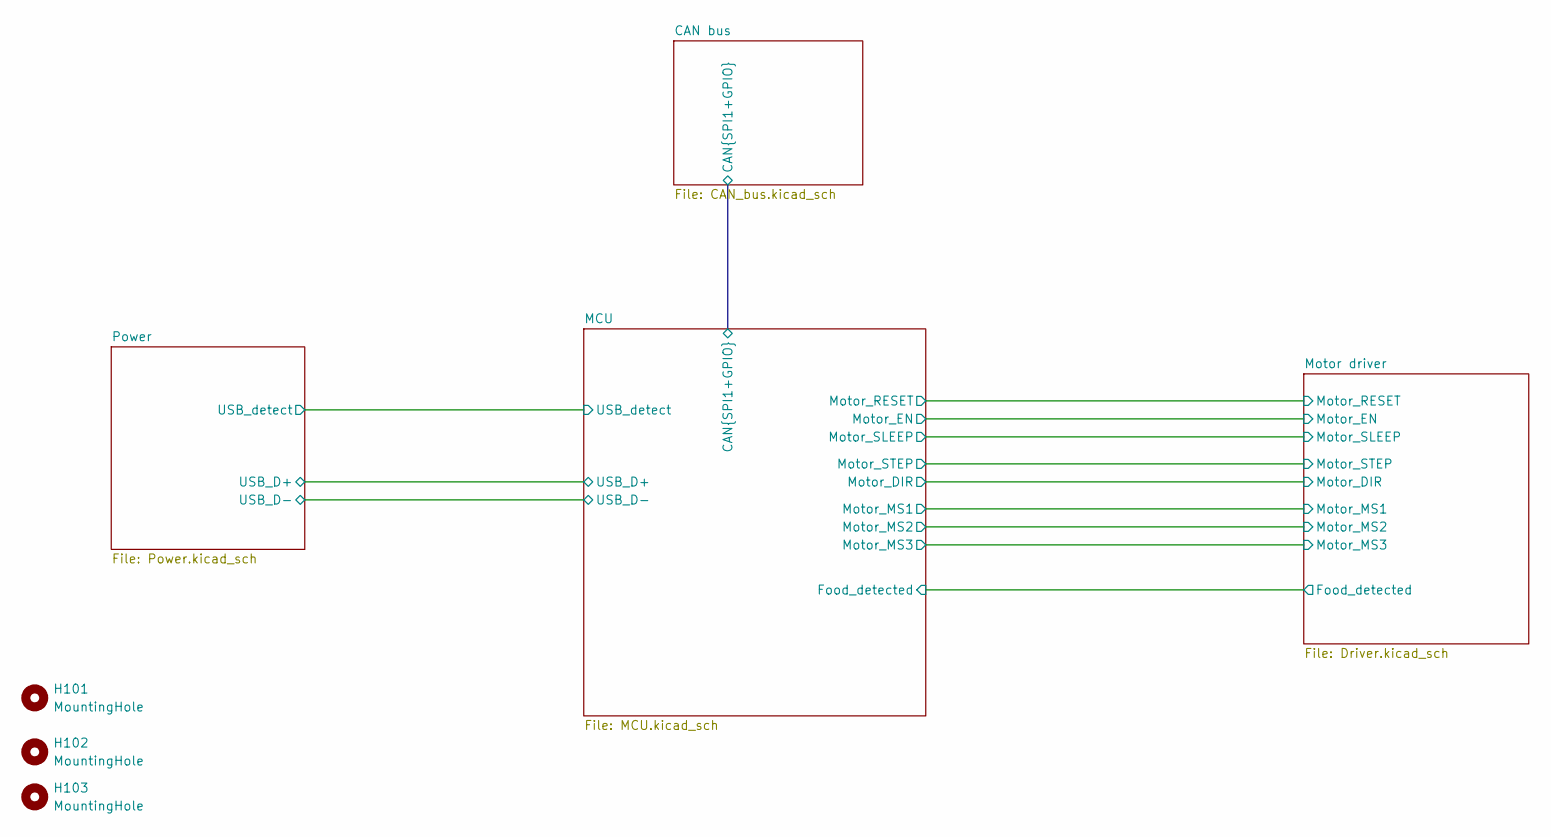
[picture p84: schematic BB_feeder_main_V1.kicad_sch, BB_feeder_main]

Parts:
H101, H102, H103: MountingHole; MountingHole_3.2mm_M3_Pad_TopBottom

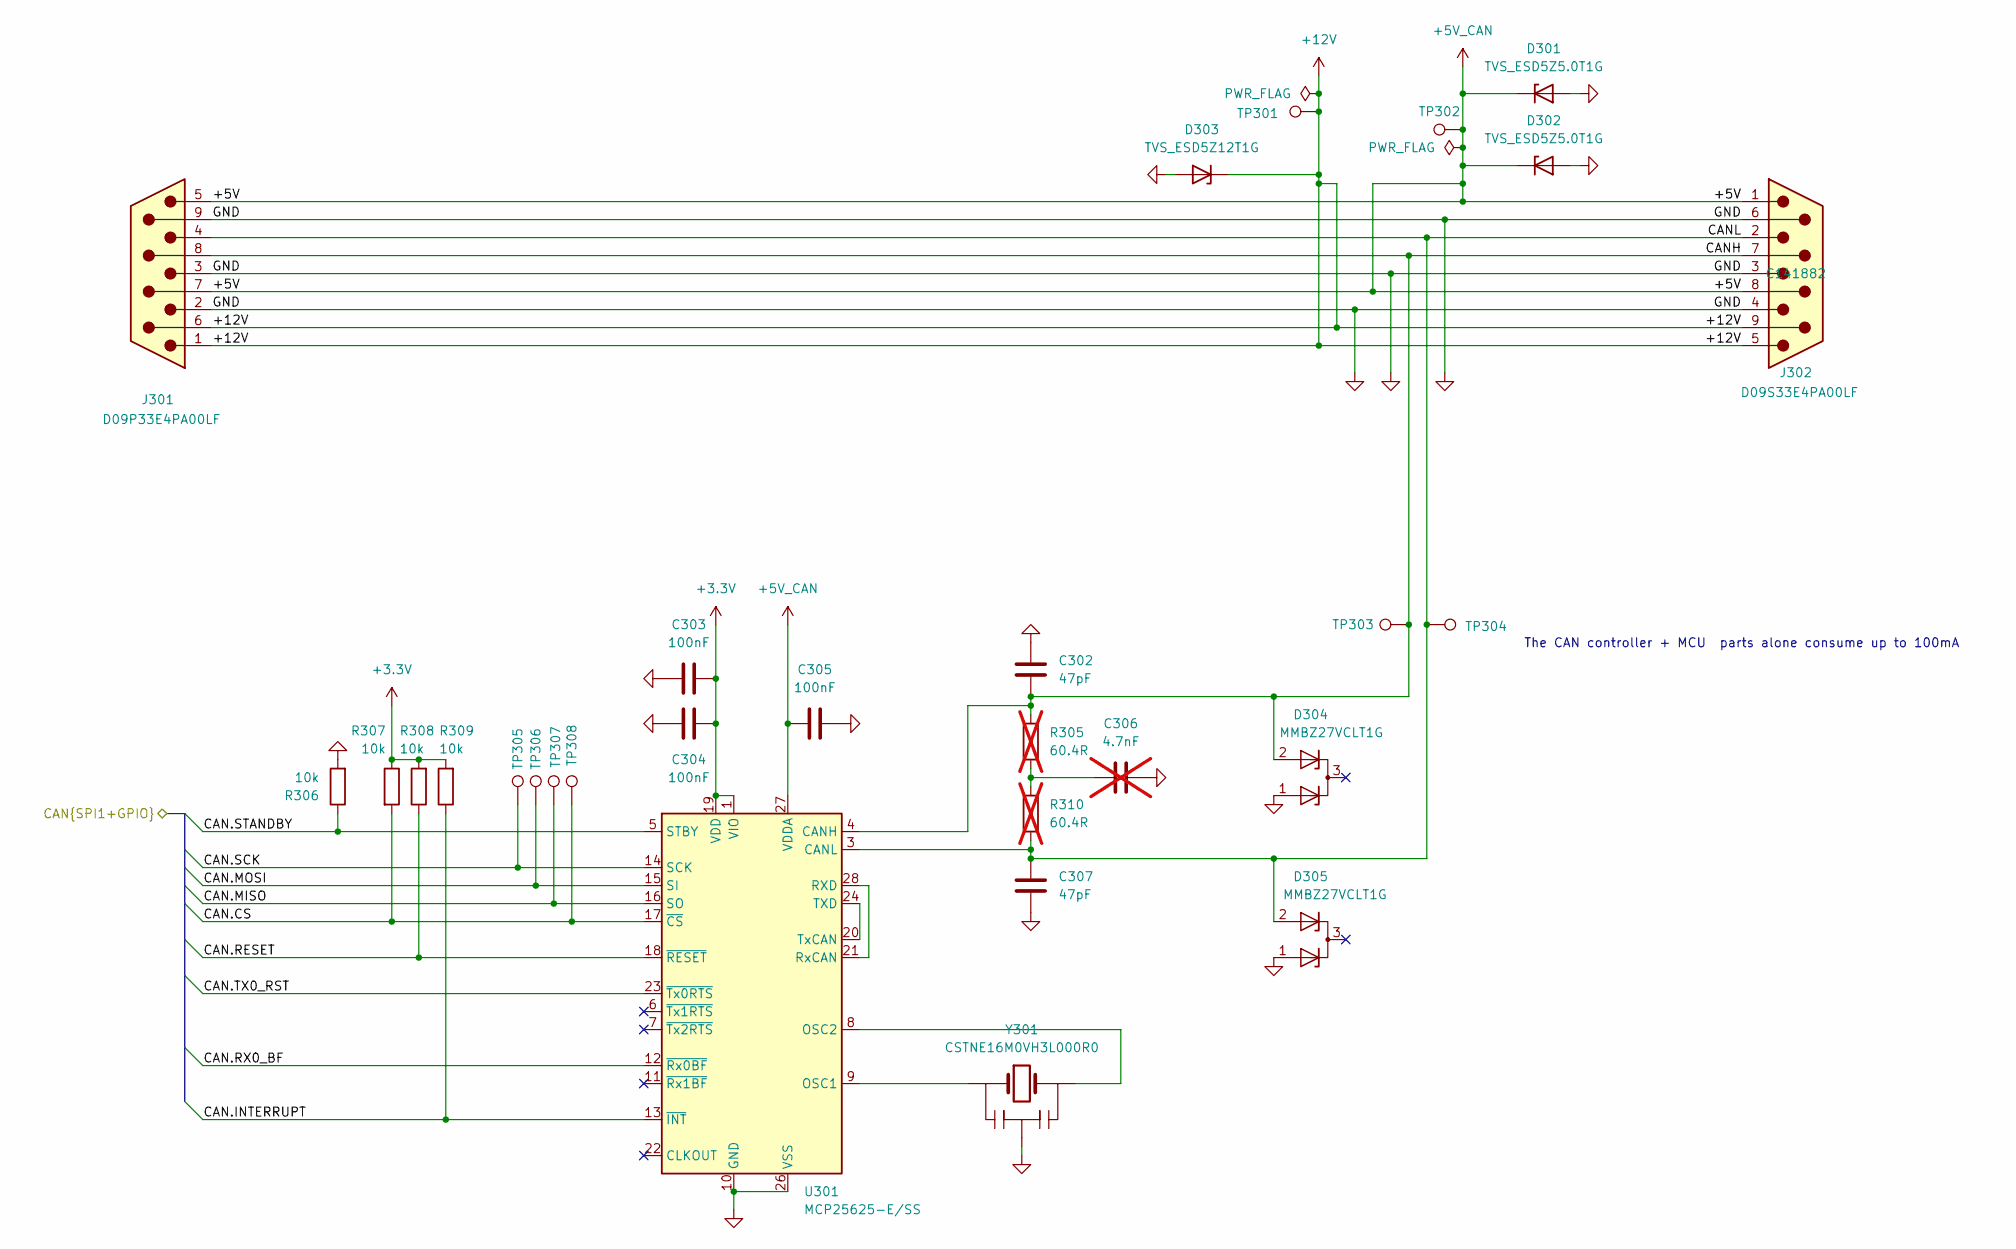
[picture p85: schematic CAN_bus.kicad_sch, BB_feeder_main]

Parts:
C302, C307: 47pF; C_0603_1608Metric
C303, C304, C305: 100nF; C_0603_1608Metric
C306: 4.7nF; C_0603_1608Metric; not fitted
D301, D302: TVS_ESD5Z5.0T1G; D_SOD-523; MPN ESD5Z5.0T1G; JLC Part C343989
D303: TVS_ESD5Z12T1G; D_SOD-523; MPN ESD5Z12T1G
D304, D305: MMBZ27VCLT1G; SOT-23; MPN MMBZ27VCLT1G; JLC Part C128609
J301: Conn-DB9_D09P33E4PA00LF; Conn_DB9_D09P33E4PA00LF; MPN D09P33E4PA00LF; JLC Part C19077344
J302: Conn-DB9_D09S33E4PA00LF; Conn_DB9_D09S33E4PA00LF; MPN D09S33E4PA00LF; JLC Part C141882
R305, R310: 60.4R; R_0603_1608Metric; not fitted
R306, R307, R308, R309: 10k; R_0603_1608Metric
TP301, TP302: TestPoint; TestPoint_THTPad_D2.0mm_Drill1.0mm
TP303, TP304, TP305, TP306, TP307, TP308: TestPoint; TestPoint_Pad_D1.0mm
U301: MCP25625-E/SS; SSOP-28_5.3x10.2mm_P0.65mm; MPN MCP25625-E/SS; JLC Part C184944
Y301: CSTNE16M0VH3L000R0; Resonator_SMD_Murata_CSTxExxV-3Pin_3.0x1.1mm; MPN CSTNE16M0VH3L000R0; JLC Part C1870467

Connections:
+3.3V: C303.2, C304.2, R307.1, R308.2, R309.2, U301.1 (VIO), U301.19 (VDD); also elsewhere on the board
+5V_CAN: C305.1, D301.1 (K), D302.1 (K), J301.5, J301.7, J302.1, J302.8, TP302.1 (1_1), U301.27 (VDDA); also elsewhere on the board
+12V: D303.1 (K), J301.1, J301.6, J302.5, J302.9, TP301.1 (1_1); also elsewhere on the board
/CAN bus/CAN.CS: R307.2, TP308.1 (1_1), U301.17 (~CS); also elsewhere on the board
/CAN bus/CAN.INTERRUPT: R309.1, U301.13 (~INT); also elsewhere on the board
/CAN bus/CAN.MISO: TP307.1 (1_1), U301.16 (SO); also elsewhere on the board
/CAN bus/CAN.MOSI: TP306.1 (1_1), U301.15 (SI); also elsewhere on the board
/CAN bus/CAN.RESET: R308.1, U301.18 (~RESET); also elsewhere on the board
/CAN bus/CAN.RX0_BF: U301.12 (~Rx0BF); also elsewhere on the board
/CAN bus/CAN.SCK: TP305.1 (1_1), U301.14 (SCK); also elsewhere on the board
/CAN bus/CAN.STANDBY: R306.1, U301.5 (STBY); also elsewhere on the board
/CAN bus/CAN.TX0_RST: U301.23 (~Tx0RTS); also elsewhere on the board
/CAN bus/CANH: C302.2, D304.2 (K), J301.8, J302.7, R305.2, TP303.1 (1_1), U301.4 (CANH)
/CAN bus/CANL: C307.1, D305.2 (K), J301.4, J302.2, R310.1, TP304.1 (1_1), U301.3 (CANL)
GND: C302.1, C303.1, C304.1, C305.2, C306.2, C307.2, D301.2 (A), D302.2 (A), D303.2 (A), D304.1 (K), D305.1 (K), J301.2, J301.3, J301.9, J302.3, J302.4, J302.6, R306.2, U301.10 (GND), U301.26 (VSS), Y301.2 (GND); also elsewhere on the board
unnamed: C306.1, R305.1, R310.2
unnamed: U301.9 (OSC1), Y301.1 (Input)
unnamed: U301.8 (OSC2), Y301.3 (Output)
unnamed: U301.21 (RxCAN), U301.28 (RXD)
unnamed: U301.20 (TxCAN), U301.24 (TXD)

Notes on the sheet:
The CAN controller + MCU parts alone consume up to 100mA
