Open-BeatBox/Open-BeatBox_Hardware/electronics/BB_feeder_main_V1/BB_feeder_main_V1.kicad_pcb

## KiCad design electronics/BB_feeder_main_V1/BB_feeder_main_V1.kicad_pcb (continued)

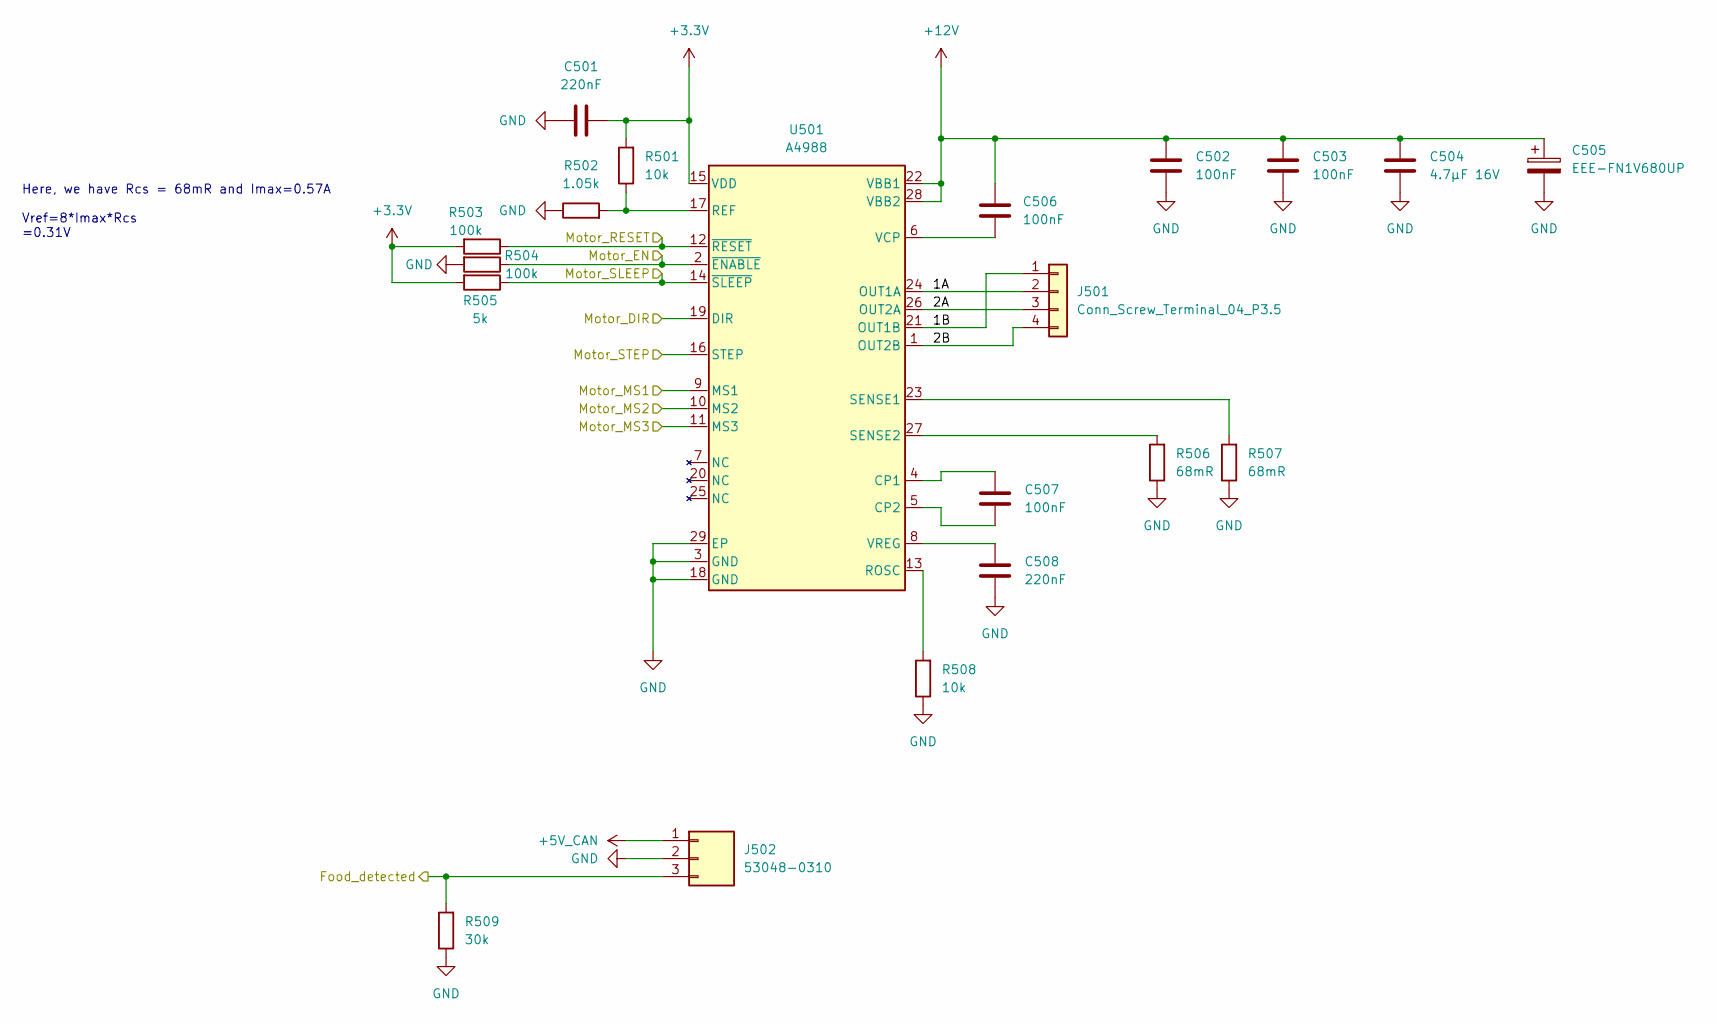
[picture p86: schematic Driver.kicad_sch, BB_feeder_main]

Parts:
C501, C508: 220nF; C_0603_1608Metric
C502, C503, C506, C507: 100nF; C_0603_1608Metric
C504: 4.7µF 16V; C_1206_3216Metric
C505: EEE-FN1V680UP; MPN EEE-FN1V680UP
J501: Conn_Screw_Terminal_04_P3.5; TerminalBlock_Phoenix_PT-1,5-4-3.5-H_1x04_P3.50mm_Horizontal; MPN 20020327-C041B01LF; JLC Part C2757925
J502: Conn_Picoblade_Molex_53048-0310; Conn_Molex_PicoBlade_53048-0310_1x03_P1.25mm_Horizontal; MPN 53048-0310; JLC Part C505275
R501, R508: 10k; R_0603_1608Metric
R502: 1.05k; R_0603_1608Metric
R503, R504: 100k; R_0603_1608Metric
R505: 5k; R_0603_1608Metric
R506, R507: 68mR; R_0603_1608Metric
R509: 30k; R_0603_1608Metric
U501: A4988; QFN-28-1EP_5x5mm_P0.5mm_EP3.1x3.1mm; MPN A4988SETTR-T

Connections:
+3.3V: C501.1, R501.2, R503.2, R505.2, U501.15 (VDD); also elsewhere on the board
+5V_CAN: J502.1; also elsewhere on the board
+12V: C502.1, C503.1, C504.1, C505.2, C506.2, U501.22 (VBB1), U501.28 (VBB2); also elsewhere on the board
/MCU/Food_detected: J502.3, R509.2; also elsewhere on the board
/MCU/Motor_DIR: U501.19 (DIR); also elsewhere on the board
/MCU/Motor_EN: R504.1, U501.2 (~ENABLE); also elsewhere on the board
/MCU/Motor_MS1: U501.9 (MS1); also elsewhere on the board
/MCU/Motor_MS2: U501.10 (MS2); also elsewhere on the board
/MCU/Motor_MS3: U501.11 (MS3); also elsewhere on the board
/MCU/Motor_RESET: R503.1, U501.12 (~RESET); also elsewhere on the board
/MCU/Motor_SLEEP: R505.1, U501.14 (~SLEEP); also elsewhere on the board
/MCU/Motor_STEP: U501.16 (STEP); also elsewhere on the board
/Motor driver/1A: J501.2, U501.24 (OUT1A)
/Motor driver/1B: J501.1, U501.21 (OUT1B)
/Motor driver/2A: J501.3, U501.26 (OUT2A)
/Motor driver/2B: J501.4, U501.1 (OUT2B)
GND: C501.2, C502.2, C503.2, C504.2, C505.1, C508.2, J502.2, R502.1, R504.2, R506.1, R507.1, R508.1, R509.1, U501.3 (GND), U501.18 (GND), U501.29 (EP); also elsewhere on the board
unnamed: C507.1, U501.4 (CP1)
unnamed: C507.2, U501.5 (CP2)
unnamed: R501.1, R502.2, U501.17 (REF)
unnamed: R508.2, U501.13 (ROSC)
unnamed: R507.2, U501.23 (SENSE1)
unnamed: R506.2, U501.27 (SENSE2)
unnamed: C506.1, U501.6 (VCP)
unnamed: C508.1, U501.8 (VREG)

Notes on the sheet:
Here, we have Rcs = 68mR and Imax=0.57A Vref=8*Imax*Rcs =0.31V

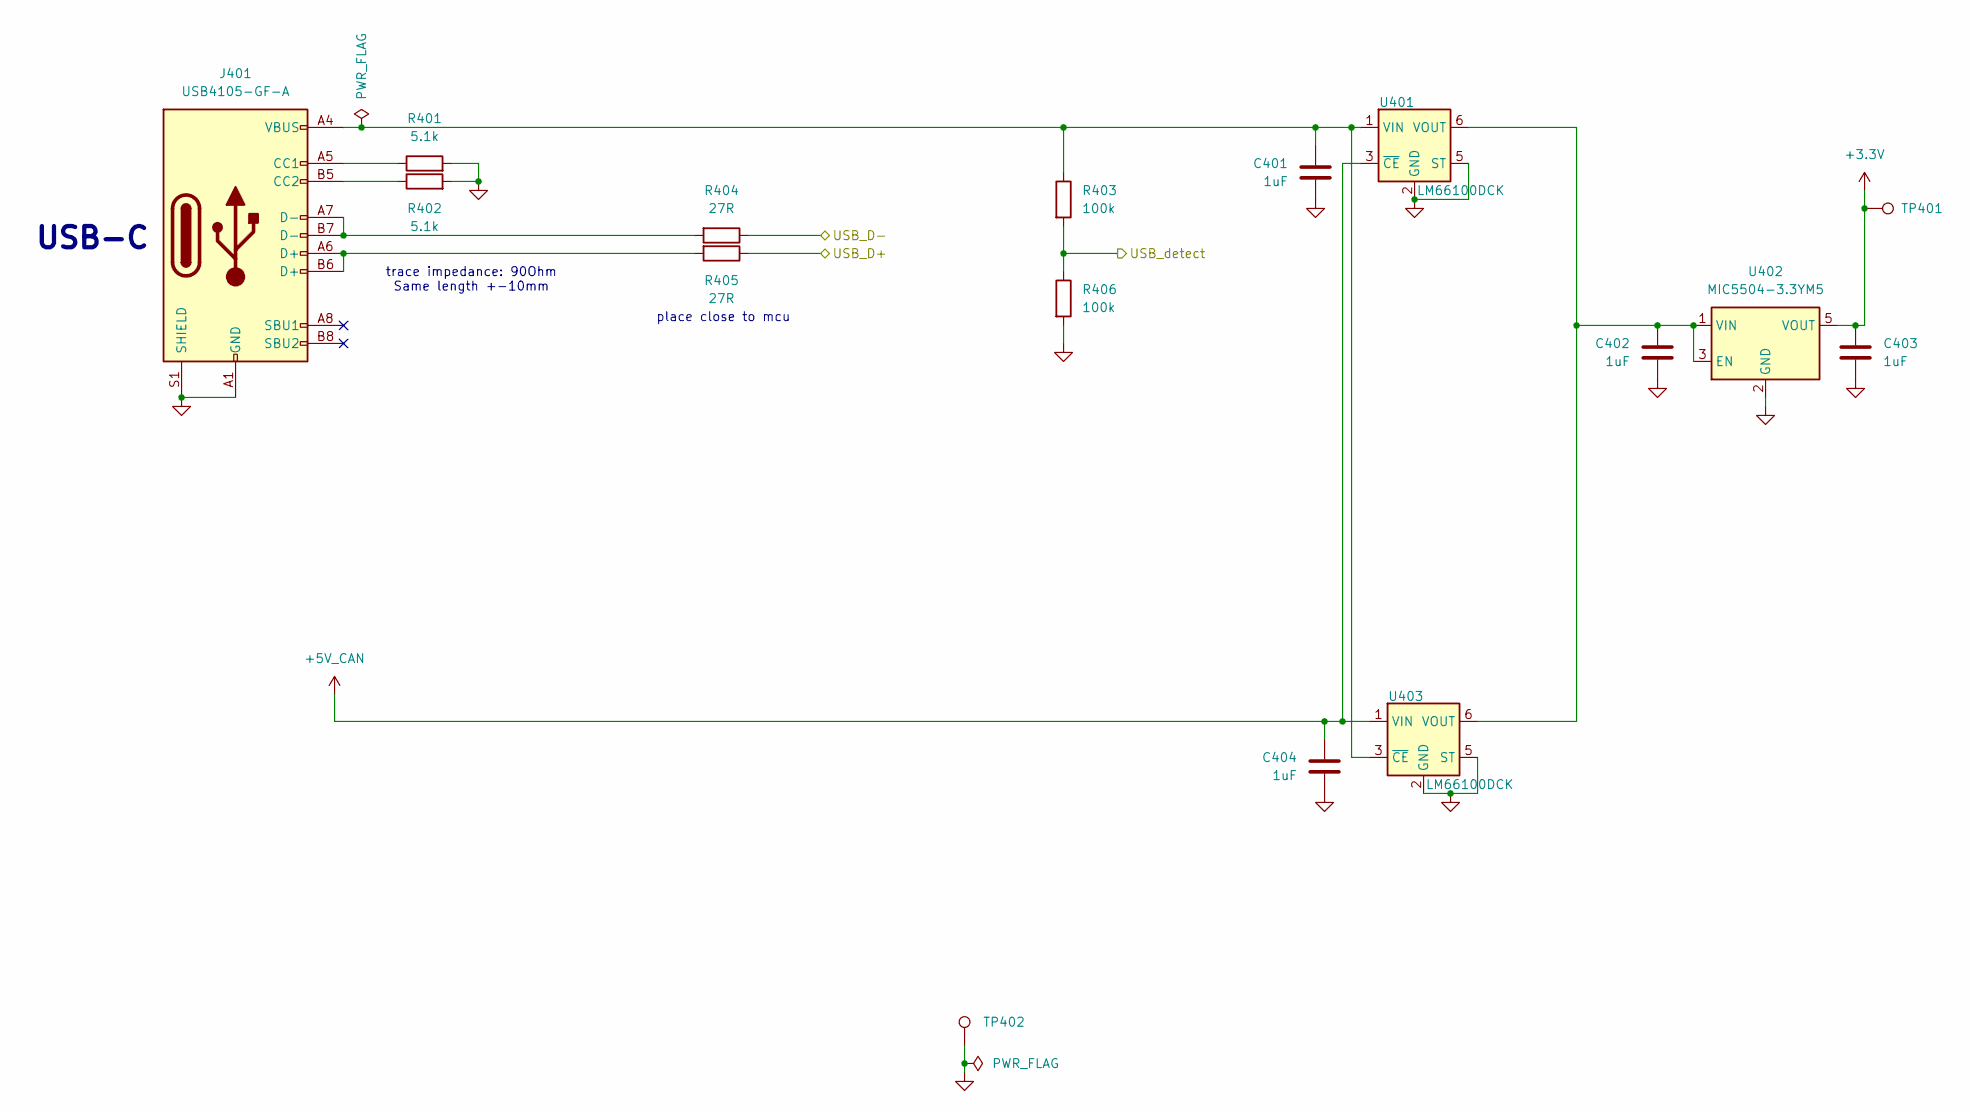
[picture p87: schematic Power.kicad_sch, BB_feeder_main]

Parts:
C401, C402, C403, C404: 1uF; C_0603_1608Metric
J401: Conn_USB-C_USB4105-GF-A; Conn_USB_C_Receptacle_GCT_USB4105-xx-A_16P_TopMnt_Horizontal; MPN USB4105-GF-A; JLC Part C393939
R401, R402: 5.1k; R_0603_1608Metric
R403, R406: 100k; R_0603_1608Metric
R404, R405: 27R; R_0603_1608Metric
TP401, TP402: TestPoint; TestPoint_THTPad_D2.0mm_Drill1.0mm
U401, U403: LM66100DCK; SOT-363_SC-70-6; MPN LM66100DCKR; JLC Part C2869734
U402: MIC5504-3.3YM5; SOT-23-5; MPN MIC5504-3.3YM5; JLC Part C88419

Connections:
+3.3V: C403.1, TP401.1 (1_1), U402.5 (VOUT); also elsewhere on the board
+5V_CAN: C404.2, U401.3 (~CE), U403.1 (VIN); also elsewhere on the board
/MCU/USB_D+: R405.1; also elsewhere on the board
/MCU/USB_D-: R404.1; also elsewhere on the board
/MCU/USB_detect: R403.2, R406.1; also elsewhere on the board
GND: C401.1, C402.2, C403.2, C404.1, J401.A1 (GND), J401.A12 (GND), J401.B1 (GND), J401.B12 (GND), J401.S1 (SHIELD), R401.2, R402.2, R406.2, TP402.1 (1_1), U401.2 (GND), U401.5 (ST), U402.2 (GND), U403.2 (GND), U403.5 (ST); also elsewhere on the board
unnamed: J401.A5 (CC1), R401.1
unnamed: J401.B5 (CC2), R402.1
unnamed: J401.A6 (D+), J401.B6 (D+), R405.2
unnamed: J401.A7 (D-), J401.B7 (D-), R404.2
unnamed: C401.2, J401.A4 (VBUS), J401.A9 (VBUS), J401.B4 (VBUS), J401.B9 (VBUS), R403.1, U401.1 (VIN), U403.3 (~CE)
unnamed: C402.1, U401.6 (VOUT), U402.1 (VIN), U402.3 (EN), U403.6 (VOUT)

Notes on the sheet:
place close to mcu
trace impedance: 90Ohm Same length +-10mm
USB-C

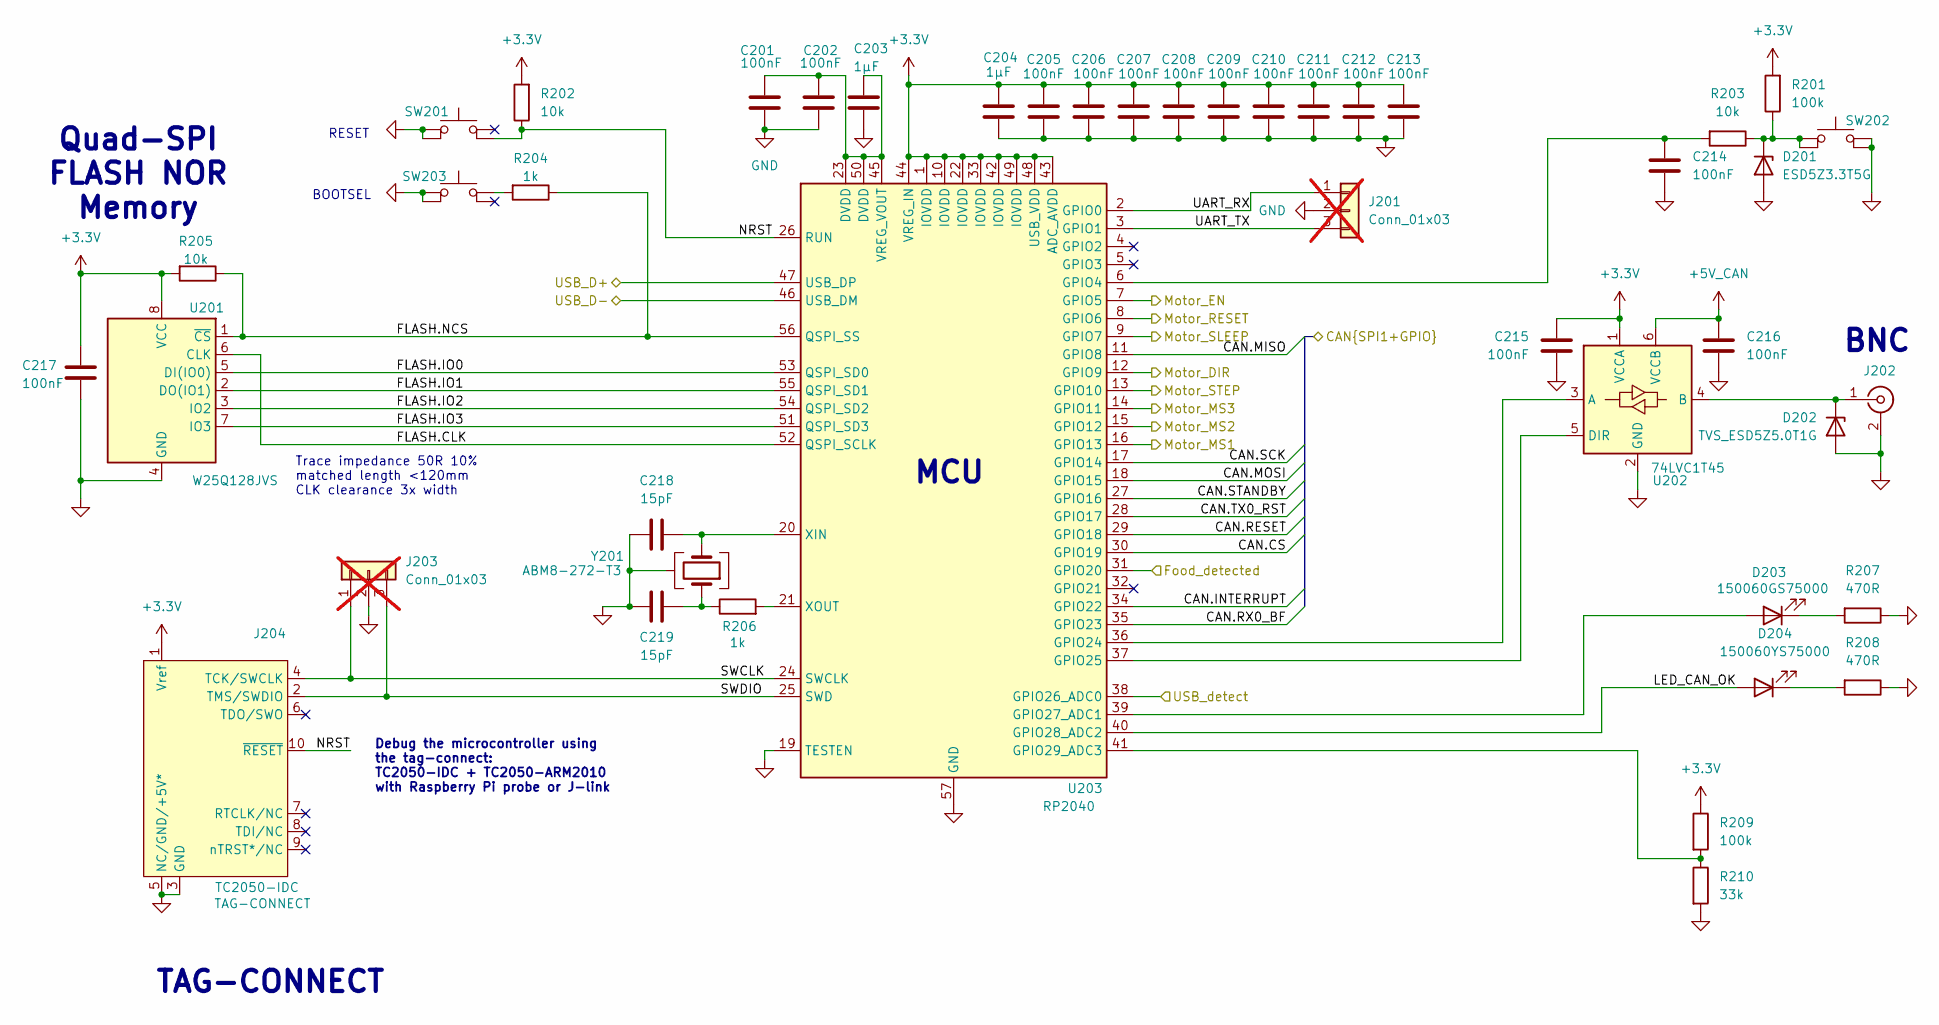
[picture p88: schematic MCU.kicad_sch, BB_feeder_main]

Parts:
C201, C202, C205, C206, C207, C208, C209, C210, C211, C212, C213, C214, C215, C216, C217: 100nF; C_0603_1608Metric
C203, C204: 1µF; C_0603_1608Metric
C218, C219: 15pF; C_0603_1608Metric
D201: TVS_ESD5Z3.3T5G; D_SOD-523; MPN ESD5Z3.3T5G; JLC Part C22440024
D202: TVS_ESD5Z5.0T1G; D_SOD-523; MPN ESD5Z5.0T1G; JLC Part C343989
D203: LED_150060GS75000; LED_0603_1608Metric; MPN 150060GS75000; JLC Part C5252984
D204: LED_150060YS75000; LED_0603_1608Metric; MPN 150060YS75000; JLC Part C6784997
J201, J203: Conn_01x03; PinHeader_1x03_P2.54mm_Vertical; not fitted
J202: Conn_BNC_KH-BNC50-3511; KH-BNC50-3511; MPN KH-BNC50-3511; JLC Part C2837587
J204: Conn_TagConnect_TC2050-IDC; Tag-Connect_TC2050-IDC-FP_2x05_P1.27mm_Vertical; MPN TC2050-IDC
R201, R209: 100k; R_0603_1608Metric
R202, R203, R205: 10k; R_0603_1608Metric
R204, R206: 1k; R_0603_1608Metric
R207, R208: 470R; R_0603_1608Metric
R210: 33k; R_0603_1608Metric
SW201, SW202, SW203: SW_TL3305AF160QG; SW_Push_TL3305; MPN TL3305AF160QG; JLC Part C18078070
U201: W25Q128JVS; SOIC-8_W25Q128JV; MPN W25Q128JVS; JLC Part C97521
U202: 74LVC1T45; SOT-363_SC-70-6; MPN 74LVC1T45DW-7; JLC Part C168855
U203: RP2040; QFN-56-1EP_7x7mm_P0.4mm_EP3.2x3.2mm; MPN RP2040; JLC Part C2040
Y201: Crystal_ABM8-272-T3; Crystal_SMD_Abracon_ABM8; MPN ABM8-272-T3; JLC Part C20625731

Connections:
+3.3V: C204.1, C205.1, C206.1, C207.1, C208.1, C209.1, C210.1, C211.1, C212.1, C213.1, C215.2, C217.2, J204.1 (Vref), R201.2, R202.2, R205.2, R209.1, U201.8 (VCC), U202.1 (VCCA), U203.1 (IOVDD), U203.10 (IOVDD), U203.22 (IOVDD), U203.33 (IOVDD), U203.42 (IOVDD), U203.43 (ADC_AVDD), U203.44 (VREG_IN), U203.48 (USB_VDD), U203.49 (IOVDD); also elsewhere on the board
+5V_CAN: C216.2, U202.6 (VCCB); also elsewhere on the board
/CAN bus/CAN.CS: U203.30 (GPIO19); also elsewhere on the board
/CAN bus/CAN.INTERRUPT: U203.34 (GPIO22); also elsewhere on the board
/CAN bus/CAN.MISO: U203.11 (GPIO8); also elsewhere on the board
/CAN bus/CAN.MOSI: U203.18 (GPIO15); also elsewhere on the board
/CAN bus/CAN.RESET: U203.29 (GPIO18); also elsewhere on the board
/CAN bus/CAN.RX0_BF: U203.35 (GPIO23); also elsewhere on the board
/CAN bus/CAN.SCK: U203.17 (GPIO14); also elsewhere on the board
/CAN bus/CAN.STANDBY: U203.27 (GPIO16); also elsewhere on the board
/CAN bus/CAN.TX0_RST: U203.28 (GPIO17); also elsewhere on the board
/MCU/FLASH.CLK: U201.6 (CLK), U203.52 (QSPI_SCLK)
/MCU/FLASH.IO0: U201.5 (DI(IO0)), U203.53 (QSPI_SD0)
/MCU/FLASH.IO1: U201.2 (DO(IO1)), U203.55 (QSPI_SD1)
/MCU/FLASH.IO2: U201.3 (IO2), U203.54 (QSPI_SD2)
/MCU/FLASH.IO3: U201.7 (IO3), U203.51 (QSPI_SD3)
/MCU/FLASH.NCS: R204.1, R205.1, U201.1 (~CS), U203.56 (QSPI_SS)
/MCU/Food_detected: U203.31 (GPIO20); also elsewhere on the board
/MCU/LED_CAN_OK: D204.2 (A), U203.40 (GPIO28_ADC2)
/MCU/Motor_DIR: U203.12 (GPIO9); also elsewhere on the board
/MCU/Motor_EN: U203.7 (GPIO5); also elsewhere on the board
/MCU/Motor_MS1: U203.16 (GPIO13); also elsewhere on the board
/MCU/Motor_MS2: U203.15 (GPIO12); also elsewhere on the board
/MCU/Motor_MS3: U203.14 (GPIO11); also elsewhere on the board
/MCU/Motor_RESET: U203.8 (GPIO6); also elsewhere on the board
/MCU/Motor_SLEEP: U203.9 (GPIO7); also elsewhere on the board
/MCU/Motor_STEP: U203.13 (GPIO10); also elsewhere on the board
/MCU/NRST: J204.10 (~RESET), R202.1, SW201.2, U203.26 (RUN)
/MCU/SWCLK: J203.1, J204.4 (TCK/SWCLK), U203.24 (SWCLK)
/MCU/SWDIO: J203.3, J204.2 (TMS/SWDIO), U203.25 (SWD)
/MCU/UART_RX: J201.1, U203.2 (GPIO0)
/MCU/UART_TX: J201.3, U203.3 (GPIO1)
/MCU/USB_D+: U203.47 (USB_DP); also elsewhere on the board
/MCU/USB_D-: U203.46 (USB_DM); also elsewhere on the board
/MCU/USB_detect: U203.38 (GPIO26_ADC0); also elsewhere on the board
GND: C201.1, C202.2, C203.1, C204.2, C205.2, C206.2, C207.2, C208.2, C209.2, C210.2, C211.2, C212.2, C213.2, C214.2, C215.1, C216.1, C217.1, C218.1, C219.1, D201.2 (A), D202.2 (A), J201.2, J202.2 (Ext), J203.2, J204.3 (GND), J204.5 (NC/GND/+5V*), R207.1, R208.1, R210.2, SW201.3, SW201.4, SW202.3, SW202.4, SW203.1, SW203.2, U201.4 (GND), U202.2 (GND), U203.19 (TESTEN), U203.57 (GND), Y201.2, Y201.4; also elsewhere on the board
unnamed: C219.2, R206.1, Y201.1
unnamed: D201.1 (K), R201.1, R203.1, SW202.1, SW202.2
unnamed: D202.1 (K), J202.1 (In), U202.4 (B)
unnamed: D203.2 (A), U203.39 (GPIO27_ADC1)
unnamed: D203.1 (K), R207.2
unnamed: D204.1 (K), R208.2
unnamed: R204.2, SW203.3
unnamed: U202.3 (A), U203.36 (GPIO24)
unnamed: U202.5 (DIR), U203.37 (GPIO25)
unnamed: C214.1, R203.2, U203.6 (GPIO4)
unnamed: R209.2, R210.1, U203.41 (GPIO29_ADC3)
unnamed: C201.2, C202.1, C203.2, U203.23 (DVDD), U203.45 (VREG_VOUT), U203.50 (DVDD)
unnamed: C218.2, U203.20 (XIN), Y201.3
unnamed: R206.2, U203.21 (XOUT)

Notes on the sheet:
Trace impedance 50R 10% matched length <120mm CLK clearance 3x width
RESET
Quad-SPI FLASH NOR Memory
Debug the microcontroller using the tag-connect: TC2050-IDC + TC2050-ARM2010 with Raspberry Pi probe or J-link
TAG-CONNECT
MCU
BNC
BOOTSEL

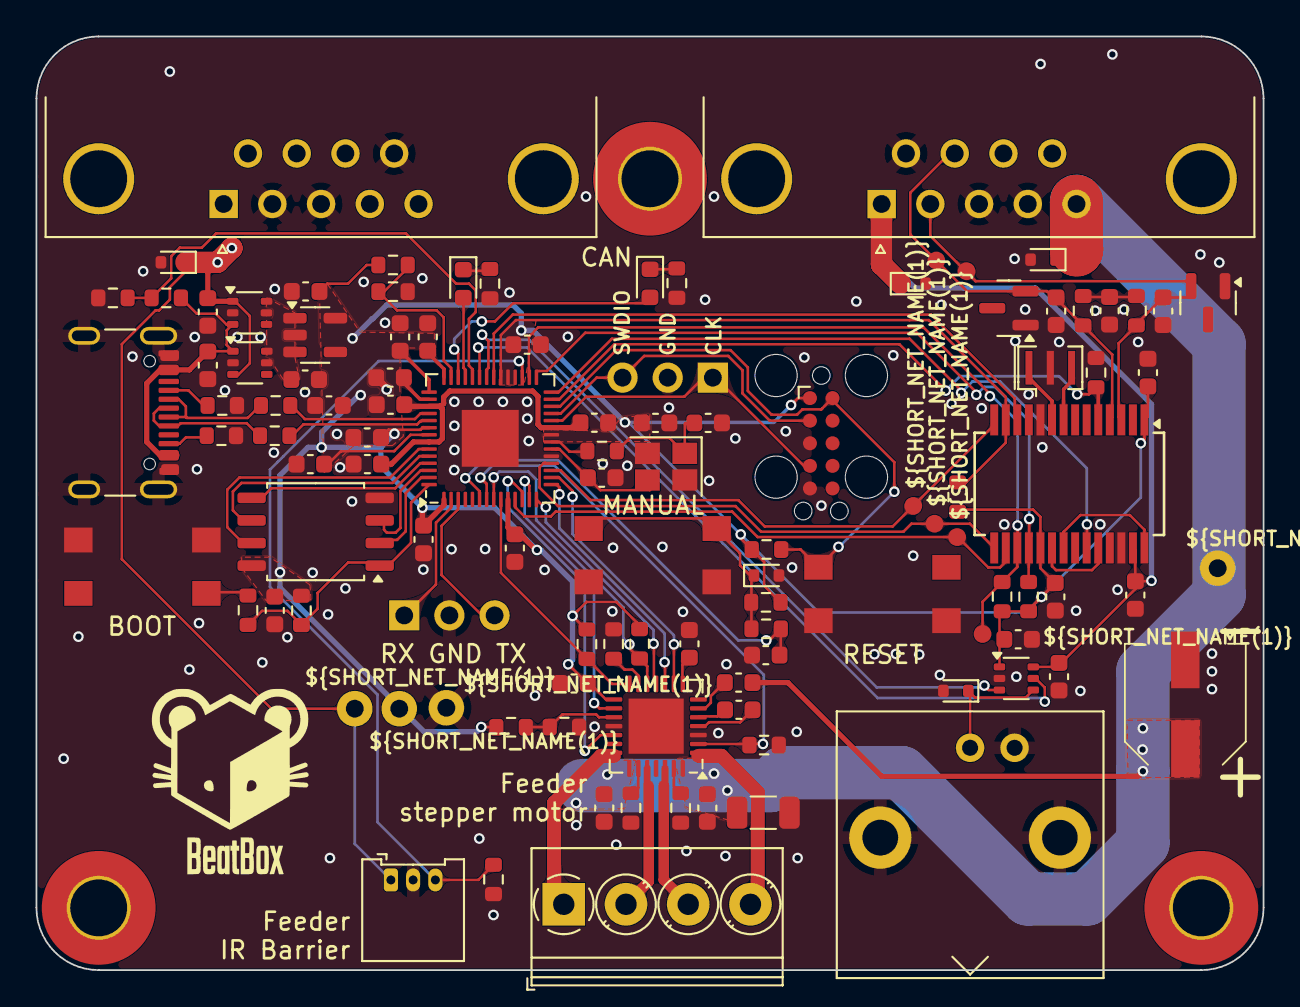
[picture p89: board BB_feeder_main_V1.kicad_pcb from above]

Board: 4 copper layers, 69.0 x 52.5 mm, 112 parts (0 on the bottom side), 76 nets.
