Open-BeatBox/Open-BeatBox_Hardware/electronics/BB_IR_light_curtain_V2_38k/BB_IR_light_curtain_V2_38.kicad_pcb

## KiCad design electronics/BB_IR_light_curtain_V2_38k/BB_IR_light_curtain_V2_38.kicad_pcb (2026-09-29)

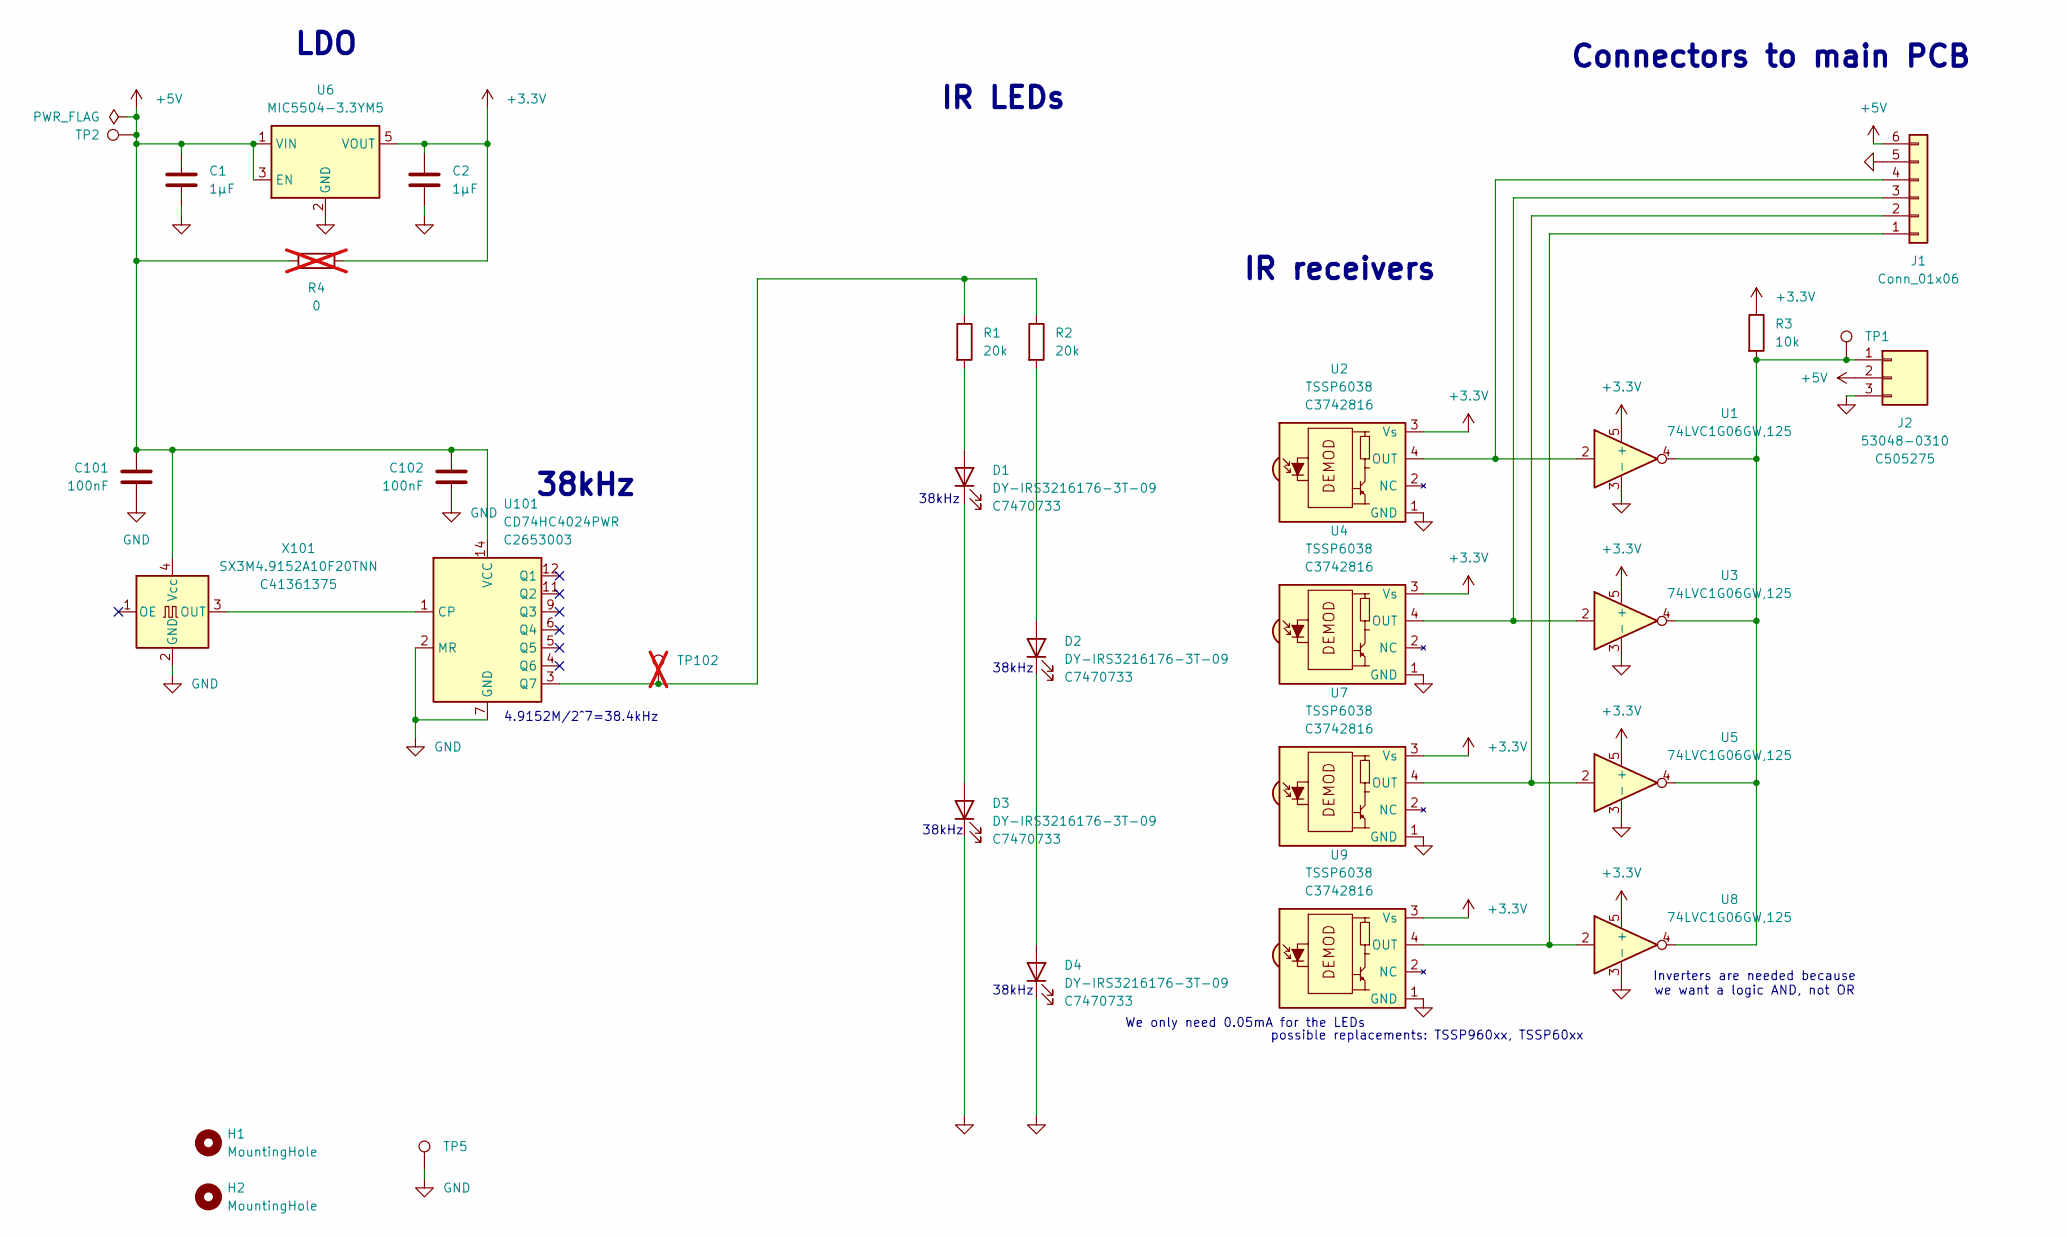
[picture p90: schematic BB_IR_light_curtain_V2_38.kicad_sch, Beatbox Light Curtain 38kHz]

Parts:
C1, C2: 1µF; C_0603_1608Metric
C101, C102: 100nF; C_0603_1608Metric
D1, D2, D3, D4: DY-IRS3216176-3T-09; LED_1206_3216Metric; MPN DY-IRS3216176-3T-09; JLCPCB Part C7470733
H1, H2: MountingHole; MountingHole_3.2mm_M3_Pad_TopBottom
J1: Conn_01x06; Conn_Molex_PicoBlade_53048-0610_1x06_P1.25mm_Horizontal
J2: Conn_Picoblade_Molex_53048-0310; Conn_Molex_PicoBlade_53048-0310_1x03_P1.25mm_Horizontal; MPN 53048-0310; JLCPCB Part C505275
R1, R2: 20k; R_0603_1608Metric_Pad0.98x0.95mm_HandSolder
R3: 10k; R_0603_1608Metric
R4: 0; R_0603_1608Metric; not fitted
TP1, TP2, TP5: TestPoint; TestPoint_Pad_D1.0mm
TP102: TestPoint; TestPoint_Pad_D1.0mm; not fitted
U1, U3, U5, U8: 74LVC1G06GW,125; SOT-353_SC-70-5; MPN 74LVC1G06GW,125; JLCPCB Part C426704
U2, U4, U7, U9: TSSP6038; Vishay-panhead; MPN TSSP6038; JLCPCB Part C3742816
U6: MIC5504-3.3YM5; SOT-23-5; MPN MIC5504-3.3YM5; JLCPCB Part C88419
U101: CD74HC4024PWR; TSSOP-14_4.4x5mm_P0.65mm; MPN CD74HC4024PWR; JLCPCB Part C2653003
X101: SX3M4.9152A10F20TNN; Crystal_SMD_3225-4Pin_3.2x2.5mm; MPN SX3M4.9152A10F20TNN; JLCPCB Part C41361375

Connections:
+3.3V: C2.1, R3.1, R4.2, U1.5 (+), U2.3 (Vs), U3.5 (+), U4.3 (Vs), U5.5 (+), U6.5 (VOUT), U7.3 (Vs), U8.5 (+), U9.3 (Vs)
+5V: C1.1, C101.2, C102.2, J1.6, J2.2, R4.1, TP2.1 (1_1), U6.1 (VIN), U6.3 (EN), U101.14 (VCC), X101.4 (Vcc)
GND: C1.2, C2.2, C101.1, C102.1, D3.1 (K), D4.1 (K), J1.5, J2.3, TP5.1 (1_1), U1.3 (-), U2.1 (GND), U3.3 (-), U4.1 (GND), U5.3 (-), U6.2 (GND), U7.1 (GND), U8.3 (-), U9.1 (GND), U101.2 (MR), U101.7 (GND), X101.2 (GND)
unnamed: D1.2 (A), R1.2
unnamed: D1.1 (K), D3.2 (A)
unnamed: D2.2 (A), R2.2
unnamed: D2.1 (K), D4.2 (A)
unnamed: J1.1, U8.2, U9.4 (OUT)
unnamed: J1.2, U5.2, U7.4 (OUT)
unnamed: J1.3, U3.2, U4.4 (OUT)
unnamed: J1.4, U1.2, U2.4 (OUT)
unnamed: J2.1, R3.2, TP1.1 (1_1), U1.4, U3.4, U5.4, U8.4
unnamed: U101.1 (CP), X101.3 (OUT)
unnamed: R1.1, R2.1, TP102.1 (1_1), U101.3 (Q7)

Notes on the sheet:
LDO
38kHz
4.9152M/2^7=38.4kHz
We only need 0.05mA for the LEDs
IR LEDs
Inverters are needed because we want a logic AND, not OR
IR receivers
Connectors to main PCB
possible replacements: TSSP960xx, TSSP60xx

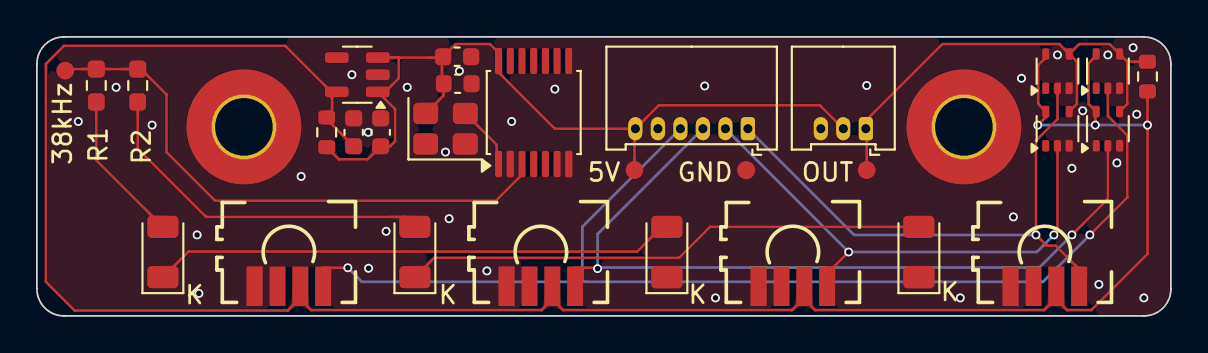
[picture p91: board BB_IR_light_curtain_V2_38.kicad_pcb from above]

Board: 4 copper layers, 63.0 x 15.5 mm, 31 parts (0 on the bottom side), 14 nets.
