Open-BeatBox/Open-BeatBox_Hardware/electronics/BB_feeder_IRBarrier_V1/BB_feeder_IRBarrier_V1.kicad_pcb

## KiCad design electronics/BB_feeder_IRBarrier_V1/BB_feeder_IRBarrier_V1.kicad_pcb (2026-09-29)

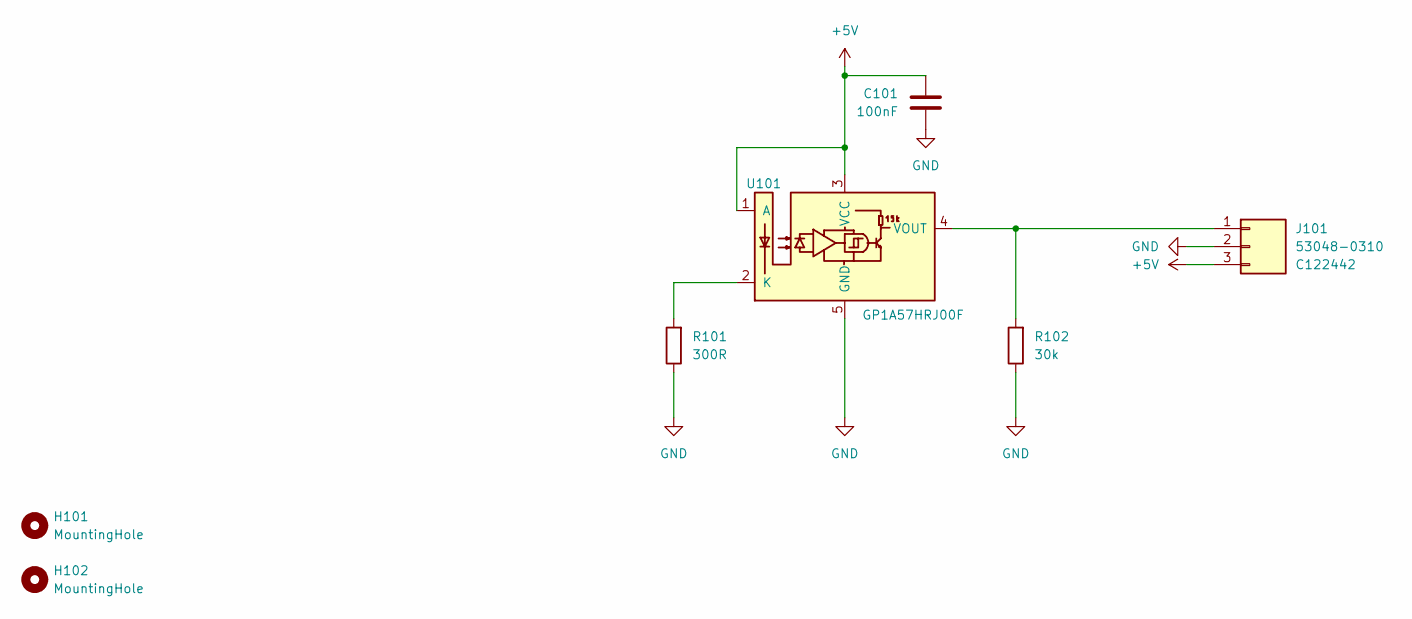
[picture p92: schematic BB_feeder_IRBarrier_V1.kicad_sch]

Parts:
C101: 100nF; C_0603_1608Metric
H101, H102: MountingHole; MountingHole_3.2mm_M3_Pad_TopBottom
J101: Conn_Picoblade_Molex_53047-0310; Conn_Molex_PicoBlade_53048-0310_1x03_P1.25mm_Horizontal; MPN 53048-0310; JLC Part C122442
R101: 300R; R_0603_1608Metric
R102: 30k; R_0603_1608Metric
U101: GP1A57HRJ00F; SHARP-GP1A57HRJ00F; MPN GP1A57HRJ00F; JLC Part C919627

Connections:
+5V: C101.2, J101.3, U101.1 (A), U101.3 (VCC)
GND: C101.1, J101.2, R101.1, R102.1, U101.5 (GND)
unnamed: J101.1, R102.2, U101.4 (VOUT)
unnamed: R101.2, U101.2 (K)

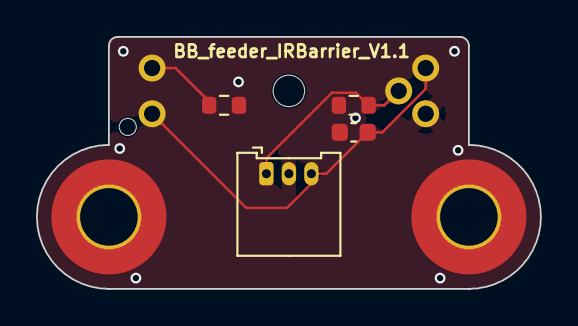
[picture p93: board BB_feeder_IRBarrier_V1.kicad_pcb from above]

Board: 4 copper layers, 28.0 x 14.0 mm, 7 parts (1 on the bottom side), 4 nets.
