Open-BeatBox/Open-BeatBox_Hardware/(commit log)

2026-02-04 UPDATE: add design parts and production parts
    [RPI_Shield_V3.STEP, RPI_shield_base_V3.STL, RPI_shield_top_V3.STL, beatbox_lighting_cover.DXF, feeder_V3.STEP, feeder_case_V3.STL, feeder_cover_V3.STL, feeder_front_V3.STL]
2026-07-13 UPDATE DESIGN FILES: add module names
    [feeder_V3.STEP, feeder_base_V3.STL, feeder_case_V3.STL, feeder_cover_V3.STL, feeder_front_V3.STL, lighting_V3.STEP, lighting_base_V3.STL, lighting_cap_V3.STL]
2026-07-13 UPDATE: add enclosure wall cutting files
    [backWall_1_3mm.DXF, backWall_2_3mm.DXF, basePlate_10mm.DXF, ceiling_3mm.DXF, doorWall_1_3mm.DXF, doorWall_2_3mm.DXF, door_3mm.DXF, feederWall_1_3mm.DXF]
2026-09-02 ADD structure elements
    [base_plate_V3.DXF, pillar_V3.STL]
2026-09-02 ADD door elements
    [doorKnob_V3.STL, doorLocker_V3_3mm.DXF]
2026-09-02 ADD electronics files
    [BB_IR_light_curtain.step, BB_IR_light_curtain_V2_38.kicad_pcb, BB_IR_light_curtain_V2_38.kicad_sch, BB_RPI_shield.step, BB_RPI_shield_V1.kicad_pcb, BB_RPI_shield_V1.kicad_sch, BB_feeder_IRBarrier.step, BB_feeder_IRBarrier_V1.kicad_pcb]
2026-09-02 ADD front_bottle_guide.STL
    [front_bottle_guide.STL]
2026-09-18 Initial commit: Open-BEATBox hardware CAD files
    Adds CAD sources and production files for hardware generations V2 and V3,
    under the CERN-OHL-S-2.0 licence.
    [RPI_Shield_V3.STEP, RPI_shield_base_V3.STL, RPI_shield_top_V3.STL, baseCage.SLDPRT, baseCage_1feeder_2screens.SLDPRT, baseCage_1feeder_2screens_backSide1_3mm_glossyBlack.DXF, baseCage_1feeder_2screens_backSide2_3mm_matteBlack.DXF, baseCage_1feeder_2screens_basePlate_10mm_black.DXF]
2026-09-18 Add CITATION.cff for the Cite this repository button
2026-09-25 UPDATE: cleanup, added ID resistors, corrected titles, exported pdf schematics, generated production files, added README
    [BB_IR_light_curtain.step, BB_IR_light_curtain_V2_38.kicad_pcb, BB_IR_light_curtain_V2_38.kicad_sch, BB_RPI_shield.step, BB_RPI_shield_V1.kicad_pcb, BB_feeder_IRBarrier_V1.kicad_pcb, BB_feeder_IRBarrier_V1.kicad_sch, BB_feeder_main.step]
2026-09-25 MODIFY file names
    [RPI_shield_base_V3.STL, RPI_shield_top_V3.STL, back_wall_1_3mm.DXF, back_wall_2_3mm.DXF, base_plate.DXF, base_plate_10mm.DXF, beatbox_lighting_cover.DXF, ceiling_3mm.DXF]
2026-09-29 Remove history-less V3 snapshot ahead of the versioned import
    The V3 CAD files were copied here without their history and have since
    been renamed and extended upstream. The next commit brings in the full
    versioned tree from the GitLab project instead.
    [RPI_Shield_V3.STEP, RPI_shield_base_V3.STL, RPI_shield_top_V3.STL, beatbox_lighting_cover.DXF, feeder_V3.STEP, feeder_case_V3.STL, feeder_cover_V3.STL, feeder_front_V3.STL]
2026-09-29 Rename CAD_files to mechanical and ECAD_files to electronics
    Plain names are easier to understand for people browsing the repository
    who are not familiar with the CAD/ECAD abbreviations.
    [BB_IR_light_curtain.step, BB_IR_light_curtain_V2_38.kicad_pcb, BB_IR_light_curtain_V2_38.kicad_sch, BB_RPI_shield.step, BB_RPI_shield_V1.kicad_pcb, BB_RPI_shield_V1.kicad_sch, BB_feeder_IRBarrier.step, BB_feeder_IRBarrier_V1.kicad_pcb]
2026-11-03 UPDATE: added passive values and footprints, corrected OE resiston on PCA9955
    Ported from ICM GitLab burguiere_beatbox_website, branch dev_electronics, commit a267129.
    [BB_lighting_V1.kicad_pcb, CAN_bus.kicad_sch, LEDs.kicad_sch, MCU.kicad_sch, Memory.kicad_sch, bom.csv, designators.csv, positions.csv]
2026-11-03 UPDATE: RPI_shield step
    Ported from ICM GitLab burguiere_beatbox_website, branch dev_electronics, commit 104b8e7.
    [BB_RPI_shield.step]
2026-11-03 UPDATE: add the BB_RPI_shield_V1 schematic PDF
    Ported from ICM GitLab burguiere_beatbox_website, branch dev_electronics, commit a517f13 ("UPDATE: added datasheets"). Only the schematic PDF is taken; the vendor datasheets are third-party documents and are not redistributed here.
